ankoman/HTBPA/dat/csig_sequence.xlsx

Sheet: 制御信号一覧
 | python |  |  | short name |  |  |  | python |  |  | short name
58 | 0 | 26 | 演算結果の選択 | os | 1=eeinv | 0=postadder
57 | 1 | 25 | 逆元演算器の動作EN | inve |  |  |  |  | 17 | 逆元演算器の動作EN | inve
56 | 2 | 24 | postadder addr3[0] | poa3 |  |  |  |  | 16 | postadder outsel[0] | pos | 00:reg1 | 10:reg3
55 | 3 | 23 | postadder addr3[1] |  |  |  |  |  | 15 | postadder outsel[1] |  | 01:reg2
54 | 4 | 22 | postadder addr2[0] | poa2 |  |  |  |  | 14 | postadder mode3[0] | pom3 | 01:in | 11:in-reg | 110:p-in
53 | 5 | 21 | postadder addr2[1] |  |  |  |  |  | 13 | postadder mode3[1] |  | 10:in+reg | 00:reg
52 | 6 | 20 | postadder outsel[0] | pos | 00:reg1 | 10:reg3 |  |  | 12 | postadder mode3[2] |  | 100:reg-in | 101:p-reg
51 | 7 | 19 | postadder outsel[1] |  | 01:reg2 |  |  |  | 11 | postadder mode2[0] | pom2 | 01:in | 11:in-reg | 110:p-in
50 | 8 | 18 | postadder mode3[0] | pom3 | 01:in | 11:in-reg | 111: 無視 |  | 10 | postadder mode2[1] |  | 10:in+reg | 00:reg
49 | 9 | 17 | postadder mode3[1] |  | 10:in+reg | 00:reg |  |  | 9 | postadder mode2[2] |  | 100:reg-in | 101:p-reg
48 | 10 | 16 | postadder mode3[2] |  | 100:reg-in | 101:p-reg |  |  | 8 | postadder mode1[0] | pom1 | 01:in | 11:in-reg | 110:p-in
47 | 11 | 15 | postadder mode2[0] | pom2 | 01:in | 11:in-reg | 111: 無視 |  | 7 | postadder mode1[1] |  | 10:in+reg | 00:reg
46 | 12 | 14 | postadder mode2[1] |  | 10:in+reg | 00:reg |  |  | 6 | postadder mode1[2] |  | 100:reg-in | 101:p-reg
45 | 13 | 13 | postadder mode2[2] |  | 100:reg-in | 101:p-reg |  |  | 5 | cmul mode[0] | cm | 001: 1倍 | 100: 4倍
44 | 14 | 12 | postadder mode1[0] | pom1 | 01:in | 11:in-reg | 110:p-in |  | 4 | cmul mode[1] |  | 010: 2倍 | 110: 6倍
43 | 15 | 11 | postadder mode1[1] |  | 10:in+reg | 00:reg | 111: reg+reg |  | 3 | cmul mode[2] |  | 011: 3倍
42 | 16 | 10 | postadder mode1[2] |  | 100:reg-in | 101:p-reg |  |  | 2 | preadder mode2[0] | pm | 00:スルー/スルー | 01:1段遅れ
41 | 17 | 9 | cmul mode[0] | cm | 001: 1倍 | 100: 4倍 |  |  | 1 | preadder mode2[1] |  | 10:2段遅れ
40 | 18 | 8 | cmul mode[1] |  | 010: 2倍 | 110: 6倍 |  |  | 0 | メモリ1への書き込みEN | me
39 | 19 | 7 | cmul mode[2] |  | 011: 3倍
38 | 20 | 6 | preadder mode2[0] | pm2 | 00:スルー | 10:d0-d1
37 | 21 | 5 | preadder mode2[1] |  | 01:delay1 + d1
36 | 22 | 4 | preadder mode1[0] | pm1 | 00:スルー | 10:d0+delay0
35 | 23 | 3 | preadder mode1[1] |  | 01:d0+d1
34 | 24 | 2 | メモリ1への書き込みEN | me1
33 | 25 | 1 | メモリ0への書き込みEN | me0
32 | 26 | 0 | opcode | opcode | 0:制御信号 | 1: 命令

Sheet: Opcodev2
Init State |  | 動作命令 | opcode | cycle
MillerLoop First | 0 | MillerLoop First + MillerLoop Second r = 0 | 0 | 277
MillerLoop Second r = 0 | 0 | MillerLoop ri = 0 | 1 | 144
MillerLoop ri = 0 | 1 | MillerLoop ri = 1 | 2 | 242
MillerLoop ri = 1 | 2 | Miller Loop Final + Final Addition | 3 | 326
Miller Loop Final | 3 | f^(p^6-1) + f^(p^2+1) | 4 | 670
Final Addition | 3 | Compress even + pipeline wait | 6 | 28
f^(p^6-1) | 4 | Compress odd + pipeline wait | 5 | 28
f^(p^2+1) | 4 | Compress odd + c55 out | 7 | 33
Compress even + pipeline wait | 6 | Compress even | 8 | 28
Compress odd + pipeline wait | 5 | before c55 | 9 | 10
Compress odd + c55 out | 7 | Compress mul | 10 | 228
Compress even | 8 | FP12_sq | 11 | 57
before c55 | 9 | FP12_mul Compress out | 12 | 110
Compress mul | 10 | FP12_sq Compress out | 13 | 57
FP12_sq | 11 | FP12_Co_mul | 14 | 108
FP12_mul Compress out | 12 | FP12_mul | 15 | 108
FP12_sq Compress out | 13 | FP12_Fro2 | 16 | 10
FP12_Co_mul | 14 | FP12_Fro13(1) | 17 | 12
FP12_mul | 15 | FP12_Fro13(3) | 17 | 12
FP12_Fro2 | 16 | 2cycle wait | 18 | 2
FP12_Fro13(1) | 17
FP12_Fro13(3) | 17
2cycle wait | 18

Sheet: Sheet1
 | opcnt |  |  |  | 最終的な命令コード
 | 動作命令単位カウンタ | 動作命令 | Opnum |  |  | Opcnt | 動作命令 | Opnum |  | Cycle
 | 0 | MillerLoop First | 0 | まとめて1つの 命令に | 1 | 0 | MillerLoop First + MillerLoop Second r = 0 | 0 |  | 277
1 | 1 | MillerLoop Second r = 0 | 0 |  | 0 | 1 | MillerLoop ri = 0 | 1 |  | 144
0 | 2 | MillerLoop ri = 0 | 1 |  | 0 | 2 | MillerLoop ri = 0 | 1 |  | 144
0 | 3 | MillerLoop ri = 0 | 1 |  | 0 | 3 | MillerLoop ri = 0 | 1 |  | 144
0 | 4 | MillerLoop ri = 0 | 1 |  | 0 | 4 | MillerLoop ri = 0 | 1 |  | 144
0 | 5 | MillerLoop ri = 0 | 1 |  | 0 | 5 | MillerLoop ri = 1 | 2 |  | 242
0 | 6 | MillerLoop ri = 1 | 2 |  | 1 | 6 | MillerLoop ri = 1 | 2 |  | 242
1 | 7 | MillerLoop ri = 1 | 2 |  | 1 | 7 | MillerLoop ri = 0 | 1 |  | 144
1 | 8 | MillerLoop ri = 0 | 1 |  | 0 | 8 | MillerLoop ri = 0 | 1 |  | 144
0 | 9 | MillerLoop ri = 0 | 1 |  | 0 | 9 | MillerLoop ri = 0 | 1 |  | 144
0 | 10 | MillerLoop ri = 0 | 1 |  | 0 | 10 | MillerLoop ri = 0 | 1 |  | 144
0 | 11 | MillerLoop ri = 0 | 1 |  | 0 | 11 | MillerLoop ri = 0 | 1 |  | 144
0 | 12 | MillerLoop ri = 0 | 1 |  | 0 | 12 | MillerLoop ri = 0 | 1 |  | 144
0 | 13 | MillerLoop ri = 0 | 1 |  | 0 | 13 | MillerLoop ri = 0 | 1 |  | 144
0 | 14 | MillerLoop ri = 0 | 1 |  | 0 | 14 | MillerLoop ri = 0 | 1 |  | 144
0 | 15 | MillerLoop ri = 0 | 1 |  | 0 | 15 | MillerLoop ri = 0 | 1 |  | 144
0 | 16 | MillerLoop ri = 0 | 1 |  | 0 | 16 | MillerLoop ri = 0 | 1 |  | 144
0 | 17 | MillerLoop ri = 0 | 1 |  | 0 | 17 | MillerLoop ri = 0 | 1 |  | 144
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
34 | 101 | Compress odd + pipeline wait | 5 |  | 34 | 101 | Compress even + pipeline wait | 6 |  | 28
35 | 102 | Compress even + pipeline wait | 6 |  | 35 | 102 | Compress odd + pipeline wait | 5 |  | 28
36 | 103 | Compress odd + pipeline wait | 5 |  | 36 | 103 | Compress even + pipeline wait | 6 |  | 28
37 | 104 | Compress even + pipeline wait | 6 |  | 37 | 104 | Compress odd + pipeline wait | 5 |  | 28
38 | 105 | Compress odd + pipeline wait | 5 |  | 38 | 105 | Compress even + pipeline wait | 6 |  | 28
39 | 106 | Compress even + pipeline wait | 6 |  | 39 | 106 | Compress odd + pipeline wait | 5 |  | 28
40 | 107 | Compress odd + pipeline wait | 5 |  | 40 | 107 | Compress even + pipeline wait | 6 |  | 28
41 | 108 | Compress even + pipeline wait | 6 |  | 41 | 108 | Compress odd + pipeline wait | 5 |  | 28
42 | 109 | Compress odd + pipeline wait | 5 |  | 42 | 109 | Compress even + pipeline wait | 6 |  | 28
43 | 110 | Compress even + pipeline wait | 6 |  | 43 | 110 | Compress odd + pipeline wait | 5 |  | 28
44 | 111 | Compress odd + pipeline wait | 5 |  | 44 | 111 | Compress even + pipeline wait | 6 |  | 28
45 | 112 | Compress even + pipeline wait | 6 |  | 45 | 112 | Compress odd + pipeline wait | 5 |  | 28
46 | 113 | Compress odd + pipeline wait | 5 |  | 46 | 113 | Compress even + pipeline wait | 6 |  | 28
47 | 114 | Compress even + pipeline wait | 6 |  | 47 | 114 | Compress odd + pipeline wait | 5 |  | 28
48 | 115 | Compress odd + pipeline wait | 5 |  | 48 | 115 | Compress even + pipeline wait | 6 |  | 28
49 | 116 | Compress even + pipeline wait | 6 |  | 49 | 116 | Compress odd + pipeline wait | 5 |  | 28
50 | 117 | Compress odd + pipeline wait | 5 |  | 50 | 117 | Compress even + pipeline wait | 6 |  | 28
51 | 118 | Compress even + pipeline wait | 6 |  | 51 | 118 | Compress odd + c55 out | 7 |  | 33
52 | 119 | Compress odd + pipeline wait | 5 |  | 52 | 119 | Compress even | 8 |  | 28
53 | 120 | Compress even + pipeline wait | 6 |  | 53 | 120 | before c55 | 9 |  | 10
54 | 121 | Compress odd + c55 out | 7 |  | 54 | 121 | Compress odd + pipeline wait | 5 |  | 28
55 | 122 | Compress even | 8 |  | 55 | 122 | Compress even + pipeline wait | 6 |  | 28
56 | 123 | before c55 | 9 |  | 56 | 123 | Compress odd + pipeline wait | 5 |  | 28
 | 124 | Compress odd + pipeline wait | 5 |  |  | 124 | Compress even + pipeline wait | 6 |  | 28
57 | 125 | Compress even + pipeline wait | 6 |  | 57 | 125 | Compress odd + pipeline wait | 5 |  | 28
58 | 126 | Compress odd + pipeline wait | 5 |  | 58 | 126 | Compress even | 8 |  | 28
59 | 127 | Compress even + pipeline wait | 6 |  | 59 | 127 | Compress mul | 10 |  | 228
60 | 128 | Compress odd + pipeline wait | 5 |  | 60 | 128 | FP12_sq | 11 |  | 57
61 | 129 | Compress even | 8 |  | 61 | 129 | FP12_sq | 11 |  | 57
62 | 130 | Compress mul | 10 |  | 62 | 130 | FP12_mul Compress out | 12 |  | 110
 | 131 | FP12_sq | 11 |  |  | 131 | Compress odd + pipeline wait | 5 |  | 28
 | 132 | FP12_sq | 11 |  |  | 132 | Compress even + pipeline wait | 6 |  | 28
 | 133 | FP12_mul Compress out | 12 |  |  | 133 | Compress odd + pipeline wait | 5 |  | 28
 | 134 | Compress odd + pipeline wait | 5 |  |  | 134 | Compress even + pipeline wait | 6 |  | 28
 | 135 | Compress even + pipeline wait | 6 |  |  | 135 | Compress odd + pipeline wait | 5 |  | 28
1 | 136 | Compress odd + pipeline wait | 5 |  | 1 | 136 | Compress even + pipeline wait | 6 |  | 28
2 | 137 | Compress even + pipeline wait | 6 |  | 2 | 137 | Compress odd + pipeline wait | 5 |  | 28
3 | 138 | Compress odd + pipeline wait | 5 |  | 3 | 138 | Compress even + pipeline wait | 6 |  | 28
4 | 139 | Compress even + pipeline wait | 6 |  | 4 | 139 | Compress odd + pipeline wait | 5 |  | 28
5 | 140 | Compress odd + pipeline wait | 5 |  | 5 | 140 | Compress even + pipeline wait | 6 |  | 28
6 | 141 | Compress even + pipeline wait | 6 |  | 6 | 141 | Compress odd + pipeline wait | 5 |  | 28
7 | 142 | Compress odd + pipeline wait | 5 |  | 7 | 142 | Compress even + pipeline wait | 6 |  | 28
8 | 143 | Compress even + pipeline wait | 6 |  | 8 | 143 | Compress odd + pipeline wait | 5 |  | 28
9 | 144 | Compress odd + pipeline wait | 5 |  | 9 | 144 | Compress even + pipeline wait | 6 |  | 28
10 | 145 | Compress even + pipeline wait | 6 |  | 10 | 145 | Compress odd + pipeline wait | 5 |  | 28
11 | 146 | Compress odd + pipeline wait | 5 |  | 11 | 146 | Compress even + pipeline wait | 6 |  | 28
12 | 147 | Compress even + pipeline wait | 6 |  | 12 | 147 | Compress odd + pipeline wait | 5 |  | 28
13 | 148 | Compress odd + pipeline wait | 5 |  | 13 | 148 | Compress even + pipeline wait | 6 |  | 28
14 | 149 | Compress even + pipeline wait | 6 |  | 14 | 149 | Compress odd + pipeline wait | 5 |  | 28
15 | 150 | Compress odd + pipeline wait | 5 |  | 15 | 150 | Compress even + pipeline wait | 6 |  | 28
16 | 151 | Compress even + pipeline wait | 6 |  | 16 | 151 | Compress odd + pipeline wait | 5 |  | 28
17 | 152 | Compress odd + pipeline wait | 5 |  | 17 | 152 | Compress even + pipeline wait | 6 |  | 28
18 | 153 | Compress even + pipeline wait | 6 |  | 18 | 153 | Compress odd + pipeline wait | 5 |  | 28
19 | 154 | Compress odd + pipeline wait | 5 |  | 19 | 154 | Compress even + pipeline wait | 6 |  | 28
20 | 155 | Compress even + pipeline wait | 6 |  | 20 | 155 | Compress odd + pipeline wait | 5 |  | 28
21 | 156 | Compress odd + pipeline wait | 5 |  | 21 | 156 | Compress even + pipeline wait | 6 |  | 28
22 | 157 | Compress even + pipeline wait | 6 |  | 22 | 157 | Compress odd + pipeline wait | 5 |  | 28
23 | 158 | Compress odd + pipeline wait | 5 |  | 23 | 158 | Compress even + pipeline wait | 6 |  | 28
24 | 159 | Compress even + pipeline wait | 6 |  | 24 | 159 | Compress odd + pipeline wait | 5 |  | 28
25 | 160 | Compress odd + pipeline wait | 5 |  | 25 | 160 | Compress even + pipeline wait | 6 |  | 28
26 | 161 | Compress even + pipeline wait | 6 |  | 26 | 161 | Compress odd + pipeline wait | 5 |  | 28
27 | 162 | Compress odd + pipeline wait | 5 |  | 27 | 162 | Compress even + pipeline wait | 6 |  | 28
28 | 163 | Compress even + pipeline wait | 6 |  | 28 | 163 | Compress odd + pipeline wait | 5 |  | 28
29 | 164 | Compress odd + pipeline wait | 5 |  | 29 | 164 | Compress even + pipeline wait | 6 |  | 28
30 | 165 | Compress even + pipeline wait | 6 |  | 30 | 165 | Compress odd + pipeline wait | 5 |  | 28
31 | 166 | Compress odd + pipeline wait | 5 |  | 31 | 166 | Compress even + pipeline wait | 6 |  | 28
32 | 167 | Compress even + pipeline wait | 6 |  | 32 | 167 | Compress odd + pipeline wait | 5 |  | 28
33 | 168 | Compress odd + pipeline wait | 5 |  | 33 | 168 | Compress even + pipeline wait | 6 |  | 28
34 | 169 | Compress even + pipeline wait | 6 |  | 34 | 169 | Compress odd + pipeline wait | 5 |  | 28
35 | 170 | Compress odd + pipeline wait | 5 |  | 35 | 170 | Compress even + pipeline wait | 6 |  | 28
36 | 171 | Compress even + pipeline wait | 6 |  | 36 | 171 | Compress odd + pipeline wait | 5 |  | 28
37 | 172 | Compress odd + pipeline wait | 5 |  | 37 | 172 | Compress even + pipeline wait | 6 |  | 28
38 | 173 | Compress even + pipeline wait | 6 |  | 38 | 173 | Compress odd + pipeline wait | 5 |  | 28
39 | 174 | Compress odd + pipeline wait | 5 |  | 39 | 174 | Compress even + pipeline wait | 6 |  | 28
40 | 175 | Compress even + pipeline wait | 6 |  | 40 | 175 | Compress odd + pipeline wait | 5 |  | 28
41 | 176 | Compress odd + pipeline wait | 5 |  | 41 | 176 | Compress even + pipeline wait | 6 |  | 28
42 | 177 | Compress even + pipeline wait | 6 |  | 42 | 177 | Compress odd + pipeline wait | 5 |  | 28
43 | 178 | Compress odd + pipeline wait | 5 |  | 43 | 178 | Compress even + pipeline wait | 6 |  | 28
44 | 179 | Compress even + pipeline wait | 6 |  | 44 | 179 | Compress odd + pipeline wait | 5 |  | 28
45 | 180 | Compress odd + pipeline wait | 5 |  | 45 | 180 | Compress even + pipeline wait | 6 |  | 28
46 | 181 | Compress even + pipeline wait | 6 |  | 46 | 181 | Compress odd + pipeline wait | 5 |  | 28
47 | 182 | Compress odd + pipeline wait | 5 |  | 47 | 182 | Compress even + pipeline wait | 6 |  | 28
48 | 183 | Compress even + pipeline wait | 6 |  | 48 | 183 | Compress odd + pipeline wait | 5 |  | 28
49 | 184 | Compress odd + pipeline wait | 5 |  | 49 | 184 | Compress even + pipeline wait | 6 |  | 28
50 | 185 | Compress even + pipeline wait | 6 |  | 50 | 185 | Compress odd + c55 out | 7 |  | 33
51 | 186 | Compress odd + pipeline wait | 5 |  | 51 | 186 | Compress even | 8 |  | 28
52 | 187 | Compress even + pipeline wait | 6 |  | 52 | 187 | before c55 | 9 |  | 10
53 | 188 | Compress odd + c55 out | 7 |  | 53 | 188 | Compress odd + pipeline wait | 5 |  | 28
54 | 189 | Compress even | 8 |  | 54 | 189 | Compress even + pipeline wait | 6 |  | 28
55 | 190 | before c55 | 9 |  | 55 | 190 | Compress odd + pipeline wait | 5 |  | 28
56 | 191 | Compress odd + pipeline wait | 5 |  | 56 | 191 | Compress even + pipeline wait | 6 |  | 28
 | 192 | Compress even + pipeline wait | 6 |  |  | 192 | Compress odd + pipeline wait | 5 |  | 28
57 | 193 | Compress odd + pipeline wait | 5 |  | 57 | 193 | Compress even | 8 |  | 28
58 | 194 | Compress even + pipeline wait | 6 |  | 58 | 194 | Compress mul | 10 |  | 228
59 | 195 | Compress odd + pipeline wait | 5 |  | 59 | 195 | FP12_sq Compress out | 13 |  | 57
60 | 196 | Compress even | 8 |  | 60 | 196 | Compress odd + pipeline wait | 5 |  | 28
61 | 197 | Compress mul | 10 |  | 61 | 197 | Compress even + pipeline wait | 6 |  | 28
62 | 198 | FP12_sq Compress out | 13 |  | 62 | 198 | Compress odd + pipeline wait | 5 |  | 28
 | 199 | Compress odd + pipeline wait | 5 |  |  | 199 | Compress even + pipeline wait | 6 |  | 28
 | 200 | Compress even + pipeline wait | 6 |  |  | 200 | Compress odd + pipeline wait | 5 |  | 28
 | 201 | Compress odd + pipeline wait | 5 |  |  | 201 | Compress even + pipeline wait | 6 |  | 28
1 | 202 | Compress even + pipeline wait | 6 |  | 1 | 202 | Compress odd + pipeline wait | 5 |  | 28
2 | 203 | Compress odd + pipeline wait | 5 |  | 2 | 203 | Compress even + pipeline wait | 6 |  | 28
3 | 204 | Compress even + pipeline wait | 6 |  | 3 | 204 | Compress odd + pipeline wait | 5 |  | 28
4 | 205 | Compress odd + pipeline wait | 5 |  | 4 | 205 | Compress even + pipeline wait | 6 |  | 28
5 | 206 | Compress even + pipeline wait | 6 |  | 5 | 206 | Compress odd + pipeline wait | 5 |  | 28
6 | 207 | Compress odd + pipeline wait | 5 |  | 6 | 207 | Compress even + pipeline wait | 6 |  | 28
7 | 208 | Compress even + pipeline wait | 6 |  | 7 | 208 | Compress odd + pipeline wait | 5 |  | 28
8 | 209 | Compress odd + pipeline wait | 5 |  | 8 | 209 | Compress even + pipeline wait | 6 |  | 28
9 | 210 | Compress even + pipeline wait | 6 |  | 9 | 210 | Compress odd + pipeline wait | 5 |  | 28
10 | 211 | Compress odd + pipeline wait | 5 |  | 10 | 211 | Compress even + pipeline wait | 6 |  | 28
11 | 212 | Compress even + pipeline wait | 6 |  | 11 | 212 | Compress odd + pipeline wait | 5 |  | 28
12 | 213 | Compress odd + pipeline wait | 5 |  | 12 | 213 | Compress even + pipeline wait | 6 |  | 28
13 | 214 | Compress even + pipeline wait | 6 |  | 13 | 214 | Compress odd + pipeline wait | 5 |  | 28
14 | 215 | Compress odd + pipeline wait | 5 |  | 14 | 215 | Compress even + pipeline wait | 6 |  | 28
15 | 216 | Compress even + pipeline wait | 6 |  | 15 | 216 | Compress odd + pipeline wait | 5 |  | 28
16 | 217 | Compress odd + pipeline wait | 5 |  | 16 | 217 | Compress even + pipeline wait | 6 |  | 28
17 | 218 | Compress even + pipeline wait | 6 |  | 17 | 218 | Compress odd + pipeline wait | 5 |  | 28
18 | 219 | Compress odd + pipeline wait | 5 |  | 18 | 219 | Compress even + pipeline wait | 6 |  | 28
19 | 220 | Compress even + pipeline wait | 6 |  | 19 | 220 | Compress odd + pipeline wait | 5 |  | 28
20 | 221 | Compress odd + pipeline wait | 5 |  | 20 | 221 | Compress even + pipeline wait | 6 |  | 28
21 | 222 | Compress even + pipeline wait | 6 |  | 21 | 222 | Compress odd + pipeline wait | 5 |  | 28
22 | 223 | Compress odd + pipeline wait | 5 |  | 22 | 223 | Compress even + pipeline wait | 6 |  | 28
23 | 224 | Compress even + pipeline wait | 6 |  | 23 | 224 | Compress odd + pipeline wait | 5 |  | 28
24 | 225 | Compress odd + pipeline wait | 5 |  | 24 | 225 | Compress even + pipeline wait | 6 |  | 28
25 | 226 | Compress even + pipeline wait | 6 |  | 25 | 226 | Compress odd + pipeline wait | 5 |  | 28
26 | 227 | Compress odd + pipeline wait | 5 |  | 26 | 227 | Compress even + pipeline wait | 6 |  | 28
27 | 228 | Compress even + pipeline wait | 6 |  | 27 | 228 | Compress odd + pipeline wait | 5 |  | 28
28 | 229 | Compress odd + pipeline wait | 5 |  | 28 | 229 | Compress even + pipeline wait | 6 |  | 28
29 | 230 | Compress even + pipeline wait | 6 |  | 29 | 230 | Compress odd + pipeline wait | 5 |  | 28
30 | 231 | Compress odd + pipeline wait | 5 |  | 30 | 231 | Compress even + pipeline wait | 6 |  | 28
31 | 232 | Compress even + pipeline wait | 6 |  | 31 | 232 | Compress odd + pipeline wait | 5 |  | 28
32 | 233 | Compress odd + pipeline wait | 5 |  | 32 | 233 | Compress even + pipeline wait | 6 |  | 28
33 | 234 | Compress even + pipeline wait | 6 |  | 33 | 234 | Compress odd + pipeline wait | 5 |  | 28
34 | 235 | Compress odd + pipeline wait | 5 |  | 34 | 235 | Compress even + pipeline wait | 6 |  | 28
35 | 236 | Compress even + pipeline wait | 6 |  | 35 | 236 | Compress odd + pipeline wait | 5 |  | 28
36 | 237 | Compress odd + pipeline wait | 5 |  | 36 | 237 | Compress even + pipeline wait | 6 |  | 28
37 | 238 | Compress even + pipeline wait | 6 |  | 37 | 238 | Compress odd + pipeline wait | 5 |  | 28
38 | 239 | Compress odd + pipeline wait | 5 |  | 38 | 239 | Compress even + pipeline wait | 6 |  | 28
39 | 240 | Compress even + pipeline wait | 6 |  | 39 | 240 | Compress odd + pipeline wait | 5 |  | 28
40 | 241 | Compress odd + pipeline wait | 5 |  | 40 | 241 | Compress even + pipeline wait | 6 |  | 28
41 | 242 | Compress even + pipeline wait | 6 |  | 41 | 242 | Compress odd + pipeline wait | 5 |  | 28
42 | 243 | Compress odd + pipeline wait | 5 |  | 42 | 243 | Compress even + pipeline wait | 6 |  | 28
43 | 244 | Compress even + pipeline wait | 6 |  | 43 | 244 | Compress odd + pipeline wait | 5 |  | 28
44 | 245 | Compress odd + pipeline wait | 5 |  | 44 | 245 | Compress even + pipeline wait | 6 |  | 28
45 | 246 | Compress even + pipeline wait | 6 |  | 45 | 246 | Compress odd + pipeline wait | 5 |  | 28
46 | 247 | Compress odd + pipeline wait | 5 |  | 46 | 247 | Compress even + pipeline wait | 6 |  | 28
47 | 248 | Compress even + pipeline wait | 6 |  | 47 | 248 | Compress odd + pipeline wait | 5 |  | 28
48 | 249 | Compress odd + pipeline wait | 5 |  | 48 | 249 | Compress even + pipeline wait | 6 |  | 28
49 | 250 | Compress even + pipeline wait | 6 |  | 49 | 250 | Compress odd + c55 out | 7 |  | 33
50 | 251 | Compress odd + pipeline wait | 5 |  | 50 | 251 | Compress even | 8 |  | 28
51 | 252 | Compress even + pipeline wait | 6 |  | 51 | 252 | before c55 | 9 |  | 10
52 | 253 | Compress odd + c55 out | 7 |  | 52 | 253 | Compress odd + pipeline wait | 5 |  | 28
53 | 254 | Compress even | 8 |  | 53 | 254 | Compress even + pipeline wait | 6 |  | 28
54 | 255 | before c55 | 9 |  | 54 | 255 | Compress odd + pipeline wait | 5 |  | 28
55 | 256 | Compress odd + pipeline wait | 5 |  | 55 | 256 | Compress even + pipeline wait | 6 |  | 28
56 | 257 | Compress even + pipeline wait | 6 |  | 56 | 257 | Compress odd + pipeline wait | 5 |  | 28
 | 258 | Compress odd + pipeline wait | 5 |  |  | 258 | Compress even | 8 |  | 28
57 | 259 | Compress even + pipeline wait | 6 |  | 57 | 259 | Compress mul | 10 |  | 228
58 | 260 | Compress odd + pipeline wait | 5 |  | 58 | 260 | FP12_Co_mul | 14 |  | 108
59 | 261 | Compress even | 8 |  | 59 | 261 | FP12_mul | 15 |  | 108
60 | 262 | Compress mul | 10 |  | 60 | 262 | FP12_Co_mul | 14 |  | 108
61 | 263 | FP12_Co_mul | 14 |  | 61 | 263 | 2cycle wait | 18 |  | 2
62 | 264 | FP12_mul | 15 |  | 62 | 264 | FP12_mul | 15 |  | 108
 | 265 | FP12_Co_mul | 14 |  |  | 265 | FP12_mul | 15 |  | 108
 | 266 | 2cycle wait | 18 |  |  | 266 | FP12_Fro2 | 16 |  | 10
 | 267 | FP12_mul | 15 |  |  | 267 | FP12_Co_mul | 14 |  | 108
 | 268 | FP12_mul | 15 |  |  | 268 | FP12_Fro13(1) | 17 |  | 12
 | 269 | FP12_Fro2 | 16 |  |  | 269 | FP12_mul | 15 |  | 108
 | 270 | FP12_Co_mul | 14 |  |  | 270 | FP12_Fro13(3) | 17 |  | 12
 | 271 | FP12_Fro13(1) | 17 |  |  | 271 | FP12_mul | 15 |  | 108
 | 272 | FP12_mul | 15 |  |  | 272 | 2cycle wait | 18 |  | 2 |  | hardpart
 | 273 | FP12_Fro13(3) | 17 |  |  | 273 | FP12_mul | 15 |  | 108 |  | 7228
 | 274 | FP12_mul | 15 |  |  |  |  |  | 計 | 17579
 | 275 | 2cycle wait | 18
 | 276 | FP12_mul | 15
 | 277
 | 278
 | 279
 | 280
 |  |  |  |  |  |  | 186

Sheet: memory
 |  |  |  |  |  | 入力データ
 |  |  |  | Miller Loop
 |  |  | Y | 0xX0 |  | 0xX1 |  | 0xX2 |  | 0xX3 |  | 0xX4 |  | 0xX5 |  | 0xX6 |  | 0xX7 |  | 0xX8 |  | 0xX9 |  | 0xXa |  | 0xXb |  | 0xXc |  | 0xXd |  | 0xXe |  | 0xXf
 |  |  | X | mem0 | mem1 | mem0 | mem1 | mem0 | mem1 | mem0 | mem1 | mem0 | mem1 | mem0 | mem1 | mem0 | mem1 | mem0 | mem1 | mem0 | mem1 | mem0 | mem1 | mem0 | mem1 | mem0 | mem1 | mem0 | mem1 | mem0 | mem1 | mem0 | mem1 | mem0 | mem1
F=A-3B |  |  | 0x0Y | Xq_0 | Xq_0 | xq_1 | xq_1 | yq_0 | yq_0 | yq_1 | yq_1 | zq_0 | zq_0 | zq_1 | zq_1 | xp | xp | yp | yp | 0 | 0 | r2 | r2 | ri | ri | 1 | 1 | W2p | W2p | W3p_0 | W3p_0 | W3p_1 | W3p_1
 |  |  | 0x1Y | f0_0 | f0_0 | f0_1 | f0_1 | f1_0 | f1_0 | f1_1 | f1_1 | f2_0 | f2_0 | f2_1 | f2_1 | f3_0 | f3_0 | f3_1 | f3_1 | f4_0 | f4_0 | f4_1 | f4_1 | f5_0 | f5_0 | f5_1 | f5_1 | A_0 | A_0 | A_1 | A_1 | B_0 | B_0 | B_1 | B_1
ri=1のときは， |  |  | 0x2Y | Tx_0 | Tx_0 | Tx_1 | Tx_1 | Ty_0 | Ty_0 | Ty_1 | Ty_1 | Tz_0 | Tz_0 | Tz_1 | Tz_1 | l0_0 | l0_0 | l0_1 | l0_1 | l1_0 | l1_0 | l1_1 | l1_1 | l3_0 | l3_0 | l3_1 | l3_1 | C_0 | C_0 | C_1 | C_1 | D_0 | D_0 | D_1 | D_1
f*lが2回発生する |  |  | 0x3Y | tf0_0 | tf0_0 | tf0_1 | tf0_1 | tf1_0 | tf1_0 | tf1_1 | tf1_1 | tf2_0 | tf2_0 | tf2_1 | tf2_1 | tf3_0 | tf3_0 | tf3_1 | tf3_1 | tf4_0 | tf4_0 | tf4_1 | tf4_1 | tf5_0 | tf5_0 | tf5_1 | tf5_1 | E_0 | E_0 | E_1 | E_1 | F_0 | F_0 | F_1 | F_1
ので1回目をf*lとし |  |  | 0x4Y |  |  |  |  |  |  |  |  |  |  |  |  |  |  |  |  |  |  |  |  |  |  |  |  |  |  |  |  |  |  | g300 | g300
2回目をl*fとすることで |  |  | 0x5Y |  |  |  |  |  |  |  |  |  |  |  |  |  |  |  |  |  |  |  |  |  |  |  |  |  |  | g330 | g330 | g311 | g311 | g321 | g321
memoryの領域を削減 |  |  | 0x6Y |  |  |  |  |  |  |  |  |  |  |  |  |  |  |  |  |  |  |  |  |  |  |  |  |  |  | g100 | g100 | g130 | g130 | g111 | g111
要は，一回目はmem0から |  |  | 0x7Y |  |  |  |  |  |  |  |  |  |  |  |  |  |  |  |  |  |  |  |  |  |  |  |  |  |  | g140 | g140 | g200 | g200 | g201 | g201
 |  |  |  | Final Addtion
 |  |  | Y | 0xX0 |  | 0xX1 |  | 0xX2 |  | 0xX3 |  | 0xX4 |  | 0xX5 |  | 0xX6 |  | 0xX7 |  | 0xX8 |  | 0xX9 |  | 0xXa |  | 0xXb |  | 0xXc |  | 0xXd |  | 0xXe |  | 0xXf
 |  |  | X | mem0 | mem1 | mem0 | mem1 | mem0 | mem1 | mem0 | mem1 | mem0 | mem1 | mem0 | mem1 | mem0 | mem1 | mem0 | mem1 | mem0 | mem1 | mem0 | mem1 | mem0 | mem1 | mem0 | mem1 | mem0 | mem1 | mem0 | mem1 | mem0 | mem1 | mem0 | mem1
 |  |  | 0x0Y | Xq_0 | Xq_0 | xq_1 | xq_1 | yq_0 | yq_0 | yq_1 | yq_1 | zq_0 | zq_0 | zq_1 | zq_1 | xp | xp | yp | yp | zp | zp | r2 | r2 | ri | ri | 1 | 1 | W2p | W2p | W3p_0 | W3p_0 | W3p_1 | W3p_1 | Z_0 | Z_0
 |  |  | 0x1Y | f0_0 | f0_0 | f0_1 | f0_1 | f1_0 | f1_0 | f1_1 | f1_1 | f2_0 | f2_0 | f2_1 | f2_1 | f3_0 | f3_0 | f3_1 | f3_1 | f4_0 | f4_0 | f4_1 | f4_1 | f5_0 | f5_0 | f5_1 | f5_1 | A_0 | A_0 | A_1 | A_1 | B_0 | B_0 | B_1 | B_1
 |  |  | 0x2Y | Tx_0 | Tx_0 | Tx_1 | Tx_1 | Ty_0 | Ty_0 | Ty_1 | Ty_1 | Tz_0 | Tz_0 | Tz_1 | Tz_1 | l0_0 | l0_0 | l0_1 | l0_1 | l1_0 | l1_0 | l1_1 | l1_1 | l3_0 | l3_0 | l3_1 | l3_1 | C_0 | C_0 | C_1 | C_1 | D_0 | D_0 | D_1 | D_1
 |  |  | 0x3Y | tf0_0 | tf0_0 | tf0_1 | tf0_1 | tf1_0 | tf1_0 | tf1_1 | tf1_1 | tf2_0 | tf2_0 | tf2_1 | tf2_1 | tf3_0 | tf3_0 | tf3_1 | tf3_1 | tf4_0 | tf4_0 | tf4_1 | tf4_1 | tf5_0 | tf5_0 | tf5_1 | tf5_1 | E_0 | E_0 | E_1 | E_1 | F_0 | F_0 | F_1 | F_1
 |  |  | 0x4Y | xq1_0 | xq1_0 | xq1_1 | xq1_1 | yq1_0 | yq1_0 | yq1_1 | yq1_1 | xq2_0 | xq2_0 | xq2_1 | xq2_1 |  |  |  |  |  |  |  |  |  |  |  |  |  |  |  |  |  |  | g300 | g300
 |  |  | 0x5Y |  |  |  |  |  |  |  |  |  |  |  |  |  |  |  |  |  |  |  |  |  |  |  |  |  |  | g330 | g330 | g311 | g311 | g321 | g321
 |  |  | 0x6Y |  |  |  |  |  |  |  |  |  |  |  |  |  |  |  |  |  |  |  |  |  |  |  |  |  |  | g100 | g100 | g130 | g130 | g111 | g111
 |  |  | 0x7Y |  |  |  |  |  |  |  |  |  |  |  |  |  |  |  |  |  |  |  |  |  |  |  |  |  |  | g140 | g140 | g200 | g200 | g201 | g201
 |  |  |  | Final exp(f^(p^6-1))
 |  |  | Y | 0xX0 |  | 0xX1 |  | 0xX2 |  | 0xX3 |  | 0xX4 |  | 0xX5 |  | 0xX6 |  | 0xX7 |  | 0xX8 |  | 0xX9 |  | 0xXa |  | 0xXb |  | 0xXc |  | 0xXd |  | 0xXe |  | 0xXf
 |  |  | X | mem0 | mem1 | mem0 | mem1 | mem0 | mem1 | mem0 | mem1 | mem0 | mem1 | mem0 | mem1 | mem0 | mem1 | mem0 | mem1 | mem0 | mem1 | mem0 | mem1 | mem0 | mem1 | mem0 | mem1 | mem0 | mem1 | mem0 | mem1 | mem0 | mem1 | mem0 | mem1
 |  |  | 0x0Y
 |  |  | 0x1Y | f0_0 | f0_0 | f0_1 | f0_1 | f1_0 | f1_0 | f1_1 | f1_1 | f2_0 | f2_0 | f2_1 | f2_1 | f3_0 | f3_0 | f3_1 | f3_1 | f4_0 | f4_0 | f4_1 | f4_1 | f5_0 | f5_0 | f5_1 | f5_1 | a_0 | a_0 | a_1 | a_1 | b_0 | b_0 | b_1 | b_1
 |  |  | 0x2Y | f'0_0 | f'0_0 | f'0_1 | f'0_1 | f'1_0 | f'1_0 | f'1_1 | f'1_1 | f'2_0 | f'2_0 | f'2_1 | f'2_1 | f'3_0 | f'3_0 | f'3_1 | f'3_1 | f'4_0 | f'4_0 | f'4_1 | f'4_1 | f'5_0 | f'5_0 | f'5_1 | f'5_1 | c_0 | c_0 | c_1 | c_1 | A_0 | A_0 | A_1 | A_1
 |  |  | 0x3Y | ff_0 | ff_0 | ff_1 | ff_1 | ff_1_neg | ff_1_neg | fff | fff |  |  |  |  |  |  |  |  |  |  |  |  |  |  |  |  | B_0 | B_0 | B_1 | B_1 | C_0 | C_0 | C_1 | C_1
 |  |  | 0x4Y | t0_0 | t0_0 | t0_1 | t0_1 | t1_0 | t1_0 | t1_1 | t1_1 |  |  |  |  |  |  |  |  |  |  |  |  |  |  |  |  |  |  |  |  |  |  | g300 | g300
 |  |  | 0x5Y |  |  |  |  |  |  |  |  |  |  |  |  |  |  |  |  |  |  |  |  |  |  |  |  |  |  | g330 | g330 | g311 | g311 | g321 | g321
 |  |  | 0x6Y |  |  |  |  |  |  |  |  |  |  |  |  |  |  |  |  |  |  |  |  |  |  |  |  |  |  | g100 | g100 | g130 | g130 | g111 | g111
 |  |  | 0x7Y |  |  |  |  |  |  |  |  |  |  |  |  |  |  |  |  |  |  |  |  |  |  |  |  |  |  | g140 | g140 | g200 | g200 | g201 | g201
 |  |  |  | Final exp(f^(p^2+1))
 |  |  | Y | 0xX0 |  | 0xX1 |  | 0xX2 |  | 0xX3 |  | 0xX4 |  | 0xX5 |  | 0xX6 |  | 0xX7 |  | 0xX8 |  | 0xX9 |  | 0xXa |  | 0xXb |  | 0xXc |  | 0xXd |  | 0xXe |  | 0xXf
 |  |  | X | mem0 | mem1 | mem0 | mem1 | mem0 | mem1 | mem0 | mem1 | mem0 | mem1 | mem0 | mem1 | mem0 | mem1 | mem0 | mem1 | mem0 | mem1 | mem0 | mem1 | mem0 | mem1 | mem0 | mem1 | mem0 | mem1 | mem0 | mem1 | mem0 | mem1 | mem0 | mem1
 |  |  | 0x0Y
 |  |  | 0x1Y | f0_0 | f0_0 | f0_1 | f0_1 | f1_0 | f1_0 | f1_1 | f1_1 | f2_0 | f2_0 | f2_1 | f2_1 | f3_0 | f3_0 | f3_1 | f3_1 | f4_0 | f4_0 | f4_1 | f4_1 | f5_0 | f5_0 | f5_1 | f5_1
 |  |  | 0x2Y | f'0_0 | f"0_0 | f'0_1 | f"0_1 | f'1_0 | f"1_0 | f'1_1 | f"1_1 | f'2_0 | f"2_0 | f'2_1 | f"2_1 | f'3_0 | f"3_0 | f'3_1 | f"3_1 | f'4_0 | f"4_0 | f'4_1 | f"4_1 | f'5_0 | f"5_0 | f'5_1 | f"5_1
 |  |  | 0x3Y
 |  |  | 0x4Y |  |  |  |  |  |  |  |  |  |  |  |  |  |  |  |  |  |  |  |  |  |  |  |  |  |  |  |  |  |  | g300 | g300
 |  |  | 0x5Y |  |  |  |  |  |  |  |  |  |  |  |  |  |  |  |  |  |  |  |  |  |  |  |  |  |  | g330 | g330 | g311 | g311 | g321 | g321
 |  |  | 0x6Y |  |  |  |  |  |  |  |  |  |  |  |  |  |  |  |  |  |  |  |  |  |  |  |  |  |  | g100 | g100 | g130 | g130 | g111 | g111
 |  |  | 0x7Y |  |  |  |  |  |  |  |  |  |  |  |  |  |  |  |  |  |  |  |  |  |  |  |  |  |  | g140 | g140 | g200 | g200 | g201 | g201
 |  |  |  | hard part Compression
 |  |  | Y | 0xX0 |  | 0xX1 |  | 0xX2 |  | 0xX3 |  | 0xX4 |  | 0xX5 |  | 0xX6 |  | 0xX7 |  | 0xX8 |  | 0xX9 |  | 0xXa |  | 0xXb |  | 0xXc |  | 0xXd |  | 0xXe |  | 0xXf
 |  |  | X | mem0 | mem1 | mem0 | mem1 | mem0 | mem1 | mem0 | mem1 | mem0 | mem1 | mem0 | mem1 | mem0 | mem1 | mem0 | mem1 | mem0 | mem1 | mem0 | mem1 | mem0 | mem1 | mem0 | mem1 | mem0 | mem1 | mem0 | mem1 | mem0 | mem1 | mem0 | mem1
 |  |  | 0x0Y | tt |  |  |  |  |  |  |  |  |  |  |  |  |  |  |  |  |  |  |  |  |  |  |  | R | R
 | 16 |  | 0x1Y | f |  |  |  |  |  |  |  |  |  |  |  |  |  |  |  |  |  |  |  |  |  |  |  | R | R
 | 32 |  | 0x2Y | t0 |  |  |  |  |  |  |  |  |  |  |  |  |  |  |  |  |  |  |  |  |  |  |  | R | R
 | 48 |  | 0x3Y | t1 |  |  |  |  |  |  |  |  |  |  |  |  |  |  |  |  |  |  |  |  |  |  |  | R | R
 | 64 |  | 0x4Y | t2 |  |  |  |  |  |  |  |  |  |  |  |  |  |  |  |  |  |  |  |  |  |  |  | R | R | 1 |  |  |  | g300 | g300
 | 80 |  | 0x5Y | t3 = t55 |  |  |  |  |  |  |  |  |  |  |  |  |  |  |  |  |  |  |  |  |  |  |  | R | R | g330 | g330 | g311 | g311 | g321 | g321
 | 96 | 圧縮自乗算奇数 | 0x6Y | h0_0 | h0_0 | h0_1 | h0_1 | h1_0 | h1_0 | h1_1 | h1_1 | h2_0 | h2_0 | h2_1 | h2_1 | h3_0 | h3_0 | h3_1 | h3_1 | h4_0 | h4_0 | h4_1 | h4_1 | h5_0 | h5_0 | h5_1 | h5_1 | R | R | g100 | g100 | g130 | g130 | g111 | g111
 | 112 | 圧縮自乗算偶数 | 0x7Y |  |  | h0_1 | h0_1 | h1_0 | h1_0 | h1_1 | h1_1 | h2_0 | h2_0 | h2_1 | h2_1 | h3_0 | h3_0 | h3_1 | h3_1 | h4_0 | h4_0 | h4_1 | h4_1 | h5_0 | h5_0 | h5_1 | h5_1 | R | R | g140 | g140 | g200 | g200 | g201 | g201
 |  |  |  | hard part (Last part)
 |  |  | Y | 0xX0 |  | 0xX1 |  | 0xX2 |  | 0xX3 |  | 0xX4 |  | 0xX5 |  | 0xX6 |  | 0xX7 |  | 0xX8 |  | 0xX9 |  | 0xXa |  | 0xXb |  | 0xXc |  | 0xXd |  | 0xXe |  | 0xXf
 |  |  | X | mem0 | mem1 | mem0 | mem1 | mem0 | mem1 | mem0 | mem1 | mem0 | mem1 | mem0 | mem1 | mem0 | mem1 | mem0 | mem1 | mem0 | mem1 | mem0 | mem1 | mem0 | mem1 | mem0 | mem1 | mem0 | mem1 | mem0 | mem1 | mem0 | mem1 | mem0 | mem1
 |  |  | 0x0Y
 |  |  | 0x1Y | f0_0 | f0_0 | f0_1 | f0_1 | f1_0 | f1_0 | f1_1 | f1_1 | f2_0 | f2_0 | f2_1 | f2_1 | f3_0 | f3_0 | f3_1 | f3_1 | f4_0 | f4_0 | f4_1 | f4_1 | f5_0 | f5_0 | f5_1 | f5_1 | R | R
 |  |  | 0x2Y | f2z0_0 |  |  |  |  |  |  |  |  |  |  |  |  |  |  |  |  |  |  |  |  |  |  |  | R | R
 |  |  | 0x3Y | f6z0_0 |  |  |  |  |  |  |  |  |  |  |  |  |  |  |  |  |  |  |  |  |  |  |  | R | R
 |  |  | 0x4Y | f12z3-0_0 |  |  |  |  |  |  |  |  |  |  |  |  |  |  |  |  |  |  |  |  |  |  |  | R | R |  |  |  |  | g300 | g300
 |  |  | 0x5Y | f6z2-0_0 |  |  |  |  |  |  |  |  |  |  |  |  |  |  |  |  |  |  |  |  |  |  |  | R | R | g330 | g330 | g311 | g311 | g321 | g321
 |  |  | 0x6Y | a0_0 |  |  |  |  |  |  |  |  |  |  |  |  |  |  |  |  |  |  |  |  |  |  |  | R | R | g100 | g100 | g130 | g130 | g111 | g111
 |  |  | 0x7Y |  |  |  |  |  |  |  |  |  |  |  |  |  |  |  |  |  |  |  |  |  |  |  |  | R | R | g140 | g140 | g200 | g200 | g201 | g201
 |  |  |  |  | f'=入力 |  | f"=f^(p^2)
 |  |  |  |  | fff_acc0 : fff_acc0RR |  |  |  |  |  |  |  |  | gx_0/gx_1 : c62gx_0/c62gx_1
 |  |  |  |  | fff_acc1 : fff_acc/fff_accReduction/fff_inv |  |  |  |  |  |  |  |  | thx_0/thx_1 : c55gx_0/c55gx_1
 |  |  |  |  | fff_acc1_neg : fff_acc1_negRR
 |  |  |  | 0xX0 | 0xX1 | 0xX2 | 0xX3 | 0xX4 | 0xX5 | 0xX6 | 0xX7 | 0xX8 | 0xX9 | 0xXa | 0xXb | 0xXc | 0xXd | 0xXe | 0xXf
 |  |  | 0x7Y |  |  |  |  |  |  |  |  | g3_0_0 | g3_0_1 | g3_3_0 | g3_1_1 | g3_2_0 | g3_2_1 | g3_4_0 | g3_4_1
 |  |  | 0x8Y | g1_0_0 | g1_0_1 | g1_3_0 | g1_1_1 | g1_2_0 | g1_2_1 | g1_4_0 | g1_4_1 | g2_0_0 | g2_1_0 | g2_2_0 | g2_3_0 | g2_4_0

Sheet: Fp12_comp_sqr
changed | seq_num | 演算名 | 項 | src0 | src1 | dst | md | me0 | me1 | pm1 | pm1 | pm2 | pm2 | cm | cm | cm | pom1 | pom1 | pom1 | pom2 | pom2 | pom2 | pom3 | pom3 | pom3 | pos | pos | poa2 | poa2 | poa3 | poa3 | os | inv | reg1 | reg2[0] | reg2[1] | reg2[2] | reg3[0] | reg3[1] | reg3[2] |  |  | addra0 | addrb0 | addra1 | addrb1
 | 奇数回目 |  |  |  |  |  |  |  |  |  |  |  |  |  |  |  |  |  |  |  |  |  |  |  |  |  |  |  |  |  |  |  |  | out
x | 0 |  | 3g2^2 | g2_0 | g2_1 |  | 0 | 0 | 0 | 0 | 0 | 0 | 0 | 1 | 1 | 0 | 0 | 0 | 0 | 0 | 0 | 0 | 0 | 0 | 1 | 0 | 0 | 0 | 0 | 0 | 0 | 0 | 0 | out |  |  |  | in |  |  | 0 | 100 | 0 | 102 | #6g2g3
x | 1 |  |  | g2_0 | g2_1 |  | 0 | 0 | 0 | 0 | 1 | 1 | 0 | 0 | 1 | 1 | 0 | 0 | 0 | 0 | 0 | 1 | 0 | 0 | 0 | 0 | 0 | 0 | 0 | 0 | 0 | 0 | 0 | out | in |  |  |  |  |  | 0 | 101 | 0 | 103 | #6g2g3
x | 2 |  | 3g3^2(1+i) | g3_0 | g3_1 |  | 0 | 0 | 0 | 0 | 0 | 0 | 0 | 1 | 1 | 0 | 0 | 0 | 0 | 0 | 1 | 1 | 0 | 1 | 0 | 0 | 0 | 0 | 0 | 0 | 0 | 0 | 0 | out |  |  |  |  |  |  | 0 | 100 | 0 | 101 | #3g2^2
x | 3 |  |  | g3_0 | g3_1 |  | 0 | 0 | 0 | 0 | 1 | 1 | 0 | 0 | 1 | 1 | 0 | 0 | 0 | 0 | 1 | 1 | 0 | 1 | 0 | 0 | 0 | 0 | 0 | 0 | 0 | 0 | 0 | out |  |  |  |  |  |  | 0 | 100 | 0 | 101 | #3g2^2
x | 4 |  | -2(g4) | g4_0 | R | h4_0 | 0 | 1 | 1 | 0 | 0 | 0 | 0 | 0 | 1 | 0 | 0 | 0 | 0 | 1 | 0 | 0 | 0 | 0 | 0 | 0 | 1 | 0 | 0 | 0 | 0 | 0 | 0 |  | out |  |  |  |  |  | 0 | 104 | 0 | 106 | #6g4g5
x | 5 |  |  | g4_1 | R | h4_1 | 0 | 1 | 1 | 0 | 0 | 0 | 0 | 0 | 1 | 0 | 0 | 0 | 0 | 0 | 0 | 0 | 1 | 0 | 0 | 1 | 0 | 0 | 0 | 0 | 0 | 0 | 0 |  |  |  |  | out |  |  | 0 | 105 | 0 | 107 | #6g4g5
 | 6 |  | 6g2g3 | g2_0 | g3_0 |  | 0 | 0 | 0 | 0 | 0 | 0 | 0 | 1 | 1 | 0 | 0 | 0 | 0 | 0 | 0 | 1 | 0 | 0 | 1 | 0 | 0 | 0 | 0 | 0 | 0 | 0 | 0 | out | in |  |  | in |  |  | 0 | 101 | 0 | 103 | #6g2g3
 | 7 |  |  | g2_1 | g3_1 |  | 0 | 0 | 0 | 0 | 0 | 0 | 0 | 1 | 1 | 0 | 0 | 0 | 0 | 1 | 0 | 0 | 0 | 1 | 0 | 0 | 0 | 0 | 0 | 0 | 0 | 0 | 0 | out |  |  |  |  |  |  | 0 | 102 | 0 | 103 | #3g3^2(1+i)
 | 8 |  |  | g2_1 | g3_1 |  | 0 | 0 | 0 | 1 | 0 | 0 | 1 | 1 | 1 | 0 | 0 | 0 | 0 | 0 | 0 | 0 | 0 | 1 | 1 | 0 | 0 | 0 | 0 | 0 | 0 | 0 | 0 | out |  |  |  |  |  |  | 0 | 102 | 0 | 103 | #3g3^2(1+i)
 | 9 |  | 2(g5) | g5_0 | R | h5_0 | 0 | 1 | 1 | 0 | 0 | 0 | 0 | 0 | 1 | 0 | 0 | 0 | 0 | 0 | 1 | 0 | 0 | 0 | 0 | 0 | 1 | 0 | 0 | 0 | 0 | 0 | 0 |  | out |  |  |  |  |  | 118 | 106 | 118 | 10 | #2g5 out : (6g2g3 + 2g5)_0 -> h5_0
 | 10 |  |  | g5_1 | R | h5_1 | 0 | 1 | 1 | 0 | 0 | 0 | 0 | 0 | 1 | 0 | 0 | 0 | 0 | 0 | 0 | 0 | 0 | 1 | 0 | 1 | 0 | 0 | 0 | 0 | 0 | 0 | 0 |  |  |  |  | out |  |  | 119 | 107 | 119 | 10 | #2g5 out : (6g2g3 + 2g5)_1 -> h5_1
x | 13 |  | 6g4g5(1+i) | g4_0 | g5_0 |  | 0 | 0 | 0 | 0 | 0 | 0 | 0 | 1 | 1 | 0 | 0 | 0 | 0 | 0 | 0 | 1 | 0 | 0 | 0 | 0 | 0 | 0 | 0 | 0 | 0 | 0 | 0 | out | in |  |  |  |  |  | 0 | 105 | 0 | 107 | #6g4g5
x | 14 |  |  | g4_1 | g5_1 |  | 0 | 0 | 0 | 0 | 0 | 0 | 0 | 1 | 1 | 0 | 0 | 0 | 0 | 0 | 0 | 0 | 0 | 0 | 1 | 0 | 0 | 0 | 0 | 0 | 0 | 0 | 0 | out |  |  |  | in |  |  | 0 | 104 | 0 | 106 | #6g4g5
x | 15 |  | acc=2acc | g4_0 | g5_0 |  |  |  | preadderの内部状態のためにsrcはg40/g50 |  |  |  |  |  |  |  |  |  |  | 1 | 1 | 1 | 1 | 1 | 1
 | 16 |  |  | g4_1 | g5_1 |  | 0 | 0 | 0 | 1 | 0 | 0 | 1 | 1 | 1 | 0 | 0 | 0 | 0 | 1 | 0 | 0 | 0 | 1 | 1 | 0 | 0 | 0 | 0 | 0 | 0 | 0 | 0 | out |  |  |  |  |  |  | 0 | 105 | 0 | 107 | #6g4g5
 | 11 |  | 2(g2) | g2_0 | R | h2_0 | 0 | 1 | 1 | 0 | 0 | 0 | 0 | 0 | 1 | 0 | 0 | 0 | 0 | 0 | 1 | 0 | 0 | 0 | 0 | 0 | 0 | 0 | 0 | 0 | 0 | 0 | 0 | out |  |  |  |  |  |  | 116 | 104 | 116 | 10 | #-2g4 out : (3g^3(1+i) + 3g2^2 - 2g4)_0 -> h4_0
 | 12 |  |  | g2_1 | R | h2_1 | 0 | 1 | 1 | 0 | 0 | 0 | 0 | 0 | 1 | 0 | 0 | 0 | 0 | 0 | 0 | 0 | 0 | 1 | 0 | 0 | 0 | 0 | 0 | 0 | 0 | 0 | 0 | out |  |  |  |  |  |  | 117 | 105 | 117 | 10 | #-2g4 out : (3g^3(1+i) + 3g2^2 - 2g4)_1 -> h4_1
 | 17 |  | -2(g3) | g3_0 | R |  | 0 | 0 | 0 | 0 | 0 | 0 | 0 | 0 | 1 | 0 | 0 | 0 | 0 | 0 | 0 | 1 | 0 | 0 | 0 | 1 | 0 | 0 | 0 | 0 | 0 | 0 | 0 |  | in |  |  | out |  |  | 0 | 106 | 0 | 107 | #3g5^2(1+i)
x | 18 |  |  | g3_1 | R |  | 0 | 0 | 0 | 0 | 0 | 0 | 0 | 0 | 1 | 0 | 0 | 0 | 0 | 0 | 0 | 0 | 0 | 0 | 1 | 0 | 0 | 0 | 0 | 0 | 0 | 0 | 0 | out |  |  |  | in |  |  | 0 | 106 | 0 | 107 | #3g5^2(1+i)
x | 19 |  | 3g5^2(1+i) | g5_0 | g5_1 |  | 0 | 0 | 0 | 0 | 0 | 0 | 0 | 1 | 1 | 0 | 0 | 0 | 0 | 0 | 1 | 0 | 0 | 1 | 1 | 0 | 0 | 0 | 0 | 0 | 0 | 0 | 0 | out |  |  |  |  |  |  | 0 | 104 | 0 | 105 | #3g4^2
x | 20 |  |  | g5_0 | g5_1 |  | 0 | 0 | 0 | 0 | 1 | 1 | 0 | 0 | 1 | 1 | 0 | 0 | 0 | 0 | 1 | 1 | 0 | 1 | 0 | 0 | 0 | 0 | 0 | 0 | 0 | 0 | 0 | out |  |  |  |  |  |  | 0 | 104 | 0 | 105 | #3g4^2
x | 21 |  | 3g4^2 | g4_0 | g4_1 | h3_1 | 0 | 1 | 1 | 0 | 0 | 0 | 0 | 1 | 1 | 0 | 0 | 0 | 0 | 0 | 0 | 0 | 0 | 1 | 0 | 1 | 0 | 0 | 0 | 0 | 0 | 0 | 0 |  |  |  |  | out |  |  | 112 | 100 | 112 | 10 | #2g2 out : (6g4g5(1+i) + 2g2)_0 -> h2_0
x | 22 |  |  | g4_0 | g4_1 | h3_0 | 0 | 1 | 1 | 0 | 1 | 1 | 0 | 0 | 1 | 1 | 0 | 0 | 0 | 0 | 1 | 0 | 0 | 0 | 0 | 0 | 1 | 0 | 0 | 0 | 0 | 0 | 0 |  | out |  |  |  |  |  | 113 | 101 | 113 | 10 | #2g2 out : (6g4g5(1+i) + 2g2)_1 -> h2_1
x | 23 |  |  | g1_0 | R | acc2 |  |  |  |  |  |  |  |  |  |  |  |  |  | 0 | 0 | 1
x | 24 |  |  | g1_1 | R | acc3 |  |  |  |  |  |  |  |  |  |  |  |  |  |  |  |  | 0 | 0 | 1
x | 25 |  | 3g3g5(1+i) | g3_0 | g5_0 |  | 0 | 0 | 0 | 0 | 0 | 0 | 0 | 1 | 1 | 0 | x | x | x | 0 | 1 | 1 | 0 | 0 | 0 | 0 | 0 | 0 | 0 | 0 | 0 | 0 | 0 | out |  |  |  |  |  |  | 114 | 102 | 114 | 10 | #-2g3 out : (3g5^2(1+i) + 3g4^2 - 2g3)_0 -> h3_0
x | 26 |  |  | g3_1 | g5_1 |  | 0 | 0 | 0 | 0 | 0 | 0 | 0 | 1 | 1 | 0 | x | x | x | 0 | 0 | 0 | 0 | 1 | 0 | 0 | 0 | 0 | 0 | 0 | 0 | 0 | 0 | out |  |  |  |  |  |  | 115 | 103 | 115 | 10 | #-2g3 out : (3g5^2(1+i) + 3g4^2 - 2g3)_1 -> h3_1
x | 27 |  |  | g3_1 | g5_1 |  | 0 | 0 | 0 | 1 | 0 | 0 | 1 | 0 | 1 | 1 | x | x | x | 1 | 0 | 0 | 0 | 1 | 1 | 0 | 0 | 0 | 0 | 0 | 0 | 0 | 0 | out |  |  |  |  |  |  | 0 | 102 | 0 | 106 | #3g3g5(1+i) - g1
x | 28 |  | 3g2g4 | g2_0 | g4_0 |  | 0 | 0 | 0 | 0 | 0 | 0 | 0 | 0 | 1 | 1 | x | x | x | 0 | 1 | 0 | 1 | 0 | 0 | 0 | 0 | 0 | 0 | 0 | 0 | 0 | 0 | out |  |  |  |  |  |  | 0 | 103 | 0 | 107 | #3g3g5(1+i) - g1
x | 29 |  |  | g2_1 | g4_1 | h1_0 | 0 | 1 | 1 | 0 | 0 | 0 | 0 | 0 | 1 | 1 | x | x | x | 1 | 0 | 0 | 1 | 0 | 0 | 0 | 1 | 0 | 0 | 0 | 0 | 0 | 0 |  | out |  |  |  |  |  | 0 | 103 | 0 | 107 | #3g3g5(1+i) - g1
x | 30 |  |  | g2_1 | g4_1 | h1_1 | 0 | 1 | 1 | 1 | 0 | 0 | 1 | 0 | 1 | 1 | x | x | x | 0 | 0 | 0 | 0 | 1 | 0 | 1 | 0 | 0 | 0 | 0 | 0 | 0 | 0 |  |  |  |  | out |  |  | 0 | 100 | 0 | 104 | #3g2g4+3g3g5(1+i) - g1
x | 31 |  | nop
x | 32 |  | nop
x | 33 |  | nop
 | 34 |  | nop
 | 35 |  | nop
 | 36 |  | nop
使ってない | 偶数回目 |  |  |  |  |  |  |  |  |  |  |  |  |  |  |  |  |  |  |  |  |  |  |  |  |  |  |  |  |  |  |  |  | out
 | 0 |  | 3g5^2(1+i) | g5_0 | g5_1 |  | 0 | 0 | 0 | 0 | 0 | 0 | 0 | 1 | 1 | 0 | 0 | 0 | 0 | 0 | 0 | 1 | 0 | 0 | 1 | 0 | 0 | 1 | 0 | 1 | 0 | 0 | 0 | out |  |  | in |  |  | in |  |  | 0 | 118 | 0 | 119 | #3g5^2(1+i)
 | 1 |  |  | g5_0 | g5_1 |  | 0 | 0 | 0 | 0 | 1 | 1 | 0 | 0 | 1 | 1 | 0 | 0 | 0 | 0 | 1 | 1 | 0 | 1 | 0 | 0 | 0 | 1 | 0 | 1 | 0 | 0 | 0 | out |  |  |  |  |  |  |  |  | 0 | 118 | 0 | 119 | #3g5^2(1+i)
 | 2 |  | 6g4g5(1+i) | g4_0 | g5_0 |  | 0 | 0 | 0 | 0 | 0 | 0 | 0 | 1 | 1 | 1 | 0 | 0 | 0 | 0 | 0 | 1 | 0 | 0 | 0 | 0 | 0 | 0 | 0 | 0 | 0 | 0 | 0 | out | in |  |  |  |  |  |  |  | 0 | 116 | 0 | 118 | #6g4g5(1+i)
 | 3 |  |  | g4_1 | g5_1 |  | 0 | 0 | 0 | 0 | 0 | 0 | 0 | 1 | 1 | 1 | 0 | 0 | 0 | 0 | 0 | 0 | 0 | 0 | 1 | 0 | 0 | 0 | 0 | 0 | 0 | 0 | 0 | out |  |  |  | in |  |  |  |  | 0 | 117 | 0 | 119 | #6g4g5(1+i)
 | 4 |  |  | g4_1 | g5_1 |  | 0 | 0 | 0 | 1 | 0 | 0 | 1 | 1 | 1 | 0 | 0 | 0 | 0 | 1 | 0 | 0 | 0 | 1 | 1 | 0 | 0 | 0 | 0 | 0 | 0 | 0 | 0 | out |  |  |  |  |  |  |  |  | 0 | 117 | 0 | 119 | #6g4g5(1+i)
 | 5 |  | 2(g2) | g2_0 | R | h2_0 | 0 | 1 | 1 | 0 | 0 | 0 | 0 | 0 | 1 | 0 | 0 | 0 | 0 | 0 | 1 | 0 | 0 | 0 | 0 | 0 | 1 | 0 | 0 | 0 | 0 | 0 | 0 |  | out |  |  |  |  |  |  |  | 100 | 112 | 100 | 10 | #2g2 out : (6g4g5(1+i) + 2g2)_0 -> h2_0
 | 6 |  |  | g2_1 | R | h2_1 | 0 | 1 | 1 | 0 | 0 | 0 | 0 | 0 | 1 | 0 | 0 | 0 | 0 | 0 | 0 | 0 | 0 | 1 | 0 | 1 | 0 | 0 | 0 | 0 | 0 | 0 | 0 |  |  |  |  | out |  |  |  |  | 101 | 113 | 101 | 10 | #2g2 out : (6g4g5(1+i) + 2g2)_1 -> h2_1
 | 7 |  | 3g4^2 | g4_0 | g4_1 |  | 0 | 0 | 0 | 0 | 0 | 0 | 0 | 1 | 1 | 0 | 0 | 0 | 0 | 0 | 0 | 0 | 0 | 1 | 0 | 0 | 0 | 1 | 0 | 1 | 0 | 0 | 0 | out |  |  |  |  |  |  |  |  | 0 | 116 | 0 | 117 | #3g4^2
 | 8 |  |  | g4_0 | g4_1 |  | 0 | 0 | 0 | 0 | 1 | 1 | 0 | 0 | 1 | 1 | 0 | 0 | 0 | 0 | 1 | 0 | 0 | 0 | 0 | 0 | 0 | 1 | 0 | 1 | 0 | 0 | 0 | out |  |  |  |  |  |  |  |  | 0 | 116 | 0 | 117 | #3g4^2
 | 9 |  | 2(g5) | g5_0 | R |  | 0 | 0 | 0 | 0 | 0 | 0 | 0 | 0 | 1 | 0 | 0 | 0 | 0 | 0 | 0 | 1 | 0 | 0 | 0 | 0 | 0 | 0 | 0 | 0 | 0 | 0 | 0 | out | in |  |  |  |  |  |  |  | 0 | 118 | 0 | 10 | #2g5
 | 10 |  |  | g5_1 | R |  | 0 | 0 | 0 | 0 | 0 | 0 | 0 | 0 | 1 | 0 | 0 | 0 | 0 | 0 | 0 | 0 | 0 | 0 | 1 | 0 | 0 | 0 | 0 | 0 | 0 | 0 | 0 | out |  |  |  | in |  |  |  |  | 0 | 119 | 0 | 10 | #2g5
 | 11 |  | -2(g3) | g3_0 | R | h3_0 | 0 | 1 | 1 | 0 | 0 | 0 | 0 | 0 | 1 | 0 | 0 | 0 | 0 | 1 | 0 | 0 | 0 | 0 | 0 | 0 | 1 | 1 | 0 | 1 | 0 | 0 | 0 |  |  |  | out |  |  |  |  |  | 102 | 114 | 102 | 10 | #-2g3 out : (3g5^2(1+i) + 3g4^2 - 2g3)_0 -> h3_0
 | 12 |  |  | g3_1 | R | h3_1 | 0 | 1 | 1 | 0 | 0 | 0 | 0 | 0 | 1 | 0 | 0 | 0 | 0 | 0 | 0 | 0 | 1 | 0 | 0 | 1 | 0 | 0 | 0 | 1 | 0 | 0 | 0 |  |  |  |  |  |  | out |  |  | 103 | 115 | 103 | 10 | #-2g3 out : (3g5^2(1+i) + 3g4^2 - 2g3)_1 -> h3_1
 | 13 |  | 6g2g3 | g2_0 | g3_0 |  | 0 | 0 | 0 | 0 | 0 | 0 | 0 | 1 | 1 | 0 | 0 | 0 | 0 | 0 | 1 | 0 | 0 | 1 | 1 | 0 | 0 | 0 | 0 | 0 | 0 | 0 | 0 | out |  |  |  |  |  |  |  |  | 0 | 112 | 0 | 114 | #6g2g3
 | 14 |  |  | g2_1 | g3_1 | h5_0 | 0 | 1 | 1 | 0 | 0 | 0 | 0 | 1 | 1 | 0 | 0 | 0 | 0 | 1 | 0 | 0 | 0 | 1 | 0 | 0 | 1 | 0 | 0 | 0 | 0 | 0 | 0 |  | out |  |  |  |  |  |  |  | 106 | 113 | 106 | 115 | #6g2g3 out : (6g2g3 + 2g5)_0 -> h5_0
 | 15 |  |  | g2_1 | g3_1 | h5_1 | 0 | 1 | 1 | 1 | 0 | 0 | 1 | 1 | 1 | 0 | 0 | 0 | 0 | 0 | 0 | 0 | 0 | 1 | 1 | 1 | 0 | 0 | 0 | 0 | 0 | 0 | 0 |  |  |  |  | out |  |  |  |  | 107 | 113 | 107 | 115 | #6g2g3 out : (6g2g3 + 2g5)_1 -> h5_1
 | 16 |  | 3g3^2(1+i) | g3_0 | g3_1 |  | 0 | 0 | 0 | 0 | 0 | 0 | 0 | 1 | 1 | 0 | 0 | 0 | 0 | 0 | 0 | 1 | 0 | 0 | 1 | 0 | 0 | 1 | 0 | 1 | 0 | 0 | 0 | out |  |  | in |  |  | in |  |  | 0 | 114 | 0 | 115 | #3g3^2(1+i)
 | 17 |  |  | g3_0 | g3_1 |  | 0 | 0 | 0 | 0 | 1 | 1 | 0 | 0 | 1 | 1 | 0 | 0 | 0 | 0 | 1 | 1 | 0 | 1 | 0 | 0 | 0 | 1 | 0 | 1 | 0 | 0 | 0 | out |  |  |  |  |  |  |  |  | 0 | 114 | 0 | 115 | #3g3^2(1+i)
 | 18 |  | 3g2^2 | g2_0 | g2_1 |  | 0 | 0 | 0 | 0 | 0 | 0 | 0 | 1 | 1 | 0 | 0 | 0 | 0 | 0 | 0 | 0 | 0 | 1 | 0 | 0 | 0 | 1 | 0 | 1 | 0 | 0 | 0 | out |  |  |  |  |  |  |  |  | 0 | 112 | 0 | 113 | #3g2^2
 | 19 |  |  | g2_0 | g2_1 |  | 0 | 0 | 0 | 0 | 1 | 1 | 0 | 0 | 1 | 1 | 0 | 0 | 0 | 0 | 1 | 0 | 0 | 0 | 0 | 0 | 0 | 1 | 0 | 1 | 0 | 0 | 0 | out |  |  |  |  |  |  |  |  | 0 | 112 | 0 | 113 | #3g2^2
 | 20 |  | -2(g4) | g4_0 | R | h4_0 | 0 | 1 | 1 | 0 | 0 | 0 | 0 | 0 | 1 | 0 | 0 | 0 | 0 | 1 | 0 | 0 | 0 | 0 | 0 | 0 | 1 | 1 | 0 | 1 | 0 | 0 | 0 |  |  |  | out |  |  |  |  |  | 104 | 116 | 104 | 10 | #-2g4 out : (3g3^2(1+i) + 3g2^2 - 2g4)_0 -> h4_0
 | 21 |  |  | g4_1 | R | h4_1 | 0 | 1 | 1 | 0 | 0 | 0 | 0 | 0 | 1 | 0 | 0 | 0 | 0 | 0 | 0 | 0 | 1 | 0 | 0 | 1 | 0 | 0 | 0 | 1 | 0 | 0 | 0 |  |  |  |  |  |  | out |  |  | 105 | 117 | 105 | 10 | #-2g4 out : (3g3^2(1+i) + 3g2^2 - 2g4)_1 -> h4_1
 | 22 |  | 3g3g5(1+i) | g3_0 | g5_0 |  | 0 | 0 | 0 | 0 | 0 | 0 | 0 | 1 | 1 | 0 | x | x | x | 0 | 1 | 1 | 0 | 0 | 0 | x | x | 0 | 1 | 0 | 1 | 0 | 0 | out |  |  |  |  |  |  |  |  | 0 | 114 | 0 | 118 | #3g3g5(1+i) - g1
 | 23 |  |  | g3_1 | g5_1 |  | 0 | 0 | 0 | 0 | 0 | 0 | 0 | 1 | 1 | 0 | x | x | x | 0 | 0 | 0 | 0 | 1 | 0 | x | x | 0 | 1 | 0 | 1 | 0 | 0 | out |  |  |  |  |  |  |  |  | 0 | 115 | 0 | 119 | #3g3g5(1+i) - g1
 | 24 |  |  | g3_1 | g5_1 |  | 0 | 0 | 0 | 1 | 0 | 0 | 1 | 0 | 1 | 1 | x | x | x | 1 | 0 | 0 | 0 | 1 | 1 | x | x | 0 | 1 | 0 | 1 | 0 | 0 | out |  |  |  |  |  |  |  |  | 0 | 115 | 0 | 119 | #3g3g5(1+i) - g1
 | 25 |  | 3g2g4 | g2_0 | g4_0 |  | 0 | 0 | 0 | 0 | 0 | 0 | 0 | 0 | 1 | 1 | x | x | x | 0 | 1 | 0 | 1 | 0 | 0 | x | x | 0 | 1 | 0 | 1 | 0 | 0 | out |  |  |  |  |  |  |  |  | 0 | 112 | 0 | 116 | #3g2g4+3g3g5(1+i) - g1
 | 26 |  |  | g2_1 | g4_1 | save g1_0 | 0 | 0 | 0 | 0 | 0 | 0 | 0 | 0 | 1 | 1 | x | x | x | 1 | 0 | 0 | 1 | 0 | 0 | 0 | 1 | 0 | 1 | 0 | 1 | 0 | 0 |  |  | out |  |  |  |  |  |  | 98 | 113 | 98 | 117 | #3g2g4+3g3g5(1+i) - g1
 | 27 |  |  | g2_1 | g4_1 | save g1_1 | 0 | 0 | 0 | 1 | 0 | 0 | 1 | 0 | 1 | 1 | x | x | x | 0 | 0 | 0 | 0 | 1 | 0 | 1 | 0 | 0 | 1 | 0 | 1 | 0 | 0 |  |  |  |  |  | out |  |  |  | 99 | 113 | 99 | 117 | #3g2g4+3g3g5(1+i) - g1save : g1

Sheet: Fp12_decomp
changed | seq_num | 演算名 | 項 | src0 | src1 | dst | md | me0 | me1 | pm1 | pm1 | pm2 | pm2 | cm | cm | cm | pom1 | pom1 | pom1 | pom2 | pom2 | pom2 | pom3 | pom3 | pom3 | pos | pos | poa2 | poa2 | poa3 | poa3 | os | inv | reg1 | reg2[0] | reg2[1] | reg2[2] | reg3[0] | reg3[1] | reg3[2]
 |  |  |  |  |  |  |  |  |  |  |  |  |  |  |  |  |  |  |  |  |  |  |  |  |  |  |  |  |  |  |  |  |  | out
x | 0 | c55g2 * c55g5(1+i) |  | c55g2_0 | c55g5_0 |  | 0 | 0 | 0 | 0 | 0 | 0 | 0 | 0 | 1 | 0 | x | x | x | 0 | 0 | 1 | x | x | x | x | x | 0 | 0 | x | x | 0 | 0 | out | in
x | 1 |  |  | c55g2_1 | c55g5_1 | acc2(poa:2) | 0 | 0 | 0 | 0 | 0 | 0 | 0 | 0 | 1 | 0 | x | x | x | 0 | 0 | 0 | 0 | 0 | 1 | x | x | 0 | 0 | 0 | 0 | 0 | 0 | out |  |  |  | in
x | 2 |  |  | c55g2_1 | c55g5_1 | acc3(poa:2) | 0 | 0 | 0 | 1 | 0 | 0 | 1 | 0 | 0 | 1 | x | x | x | 1 | 0 | 0 | 0 | 1 | 1 | x | x | 0 | 0 | 0 | 0 | 0 | 0 | out
x | 3 | - 3 * c55g3 * c55g4(1+i) |  | c55g3_0 | c55g4_0 |  | 0 | 0 | 0 | 0 | 0 | 0 | 0 | 1 | 1 | 0 | x | x | x | 1 | 0 | 0 | 0 | 0 | 0 | x | x | 0 | 0 | 0 | 0 | 0 | 0 | out
x | 4 |  |  | c55g3_1 | c55g4_1 | acc2(poa:2) | 0 | 0 | 0 | 0 | 0 | 0 | 0 | 1 | 1 | 0 | x | x | x | 0 | 0 | 0 | 0 | 1 | 0 | x | x | 0 | 0 | 0 | 0 | 0 | 0 | out
x | 5 |  |  | c55g3_1 | c55g4_1 | acc3(poa:2) | 0 | 0 | 0 | 1 | 0 | 0 | 1 | 0 | 1 | 1 | x | x | x | 0 | 1 | 0 | 1 | 0 | 0 | x | x | 0 | 0 | 0 | 0 | 0 | 0 | out
x | 6 | Add 1 |  | R | R | acc2(poa:2) | 0 | 0 | 0 | 0 | 0 | 0 | 0 | 0 | 0 | 1 | x | x | x | 0 | 1 | 0 | 0 | 0 | 0 | x | x | 0 | 0 | 0 | 0 | 0 | 0 | out
x | 7 |  | 2c55g1^2(1+i) | c55g1_0 | c55g1_1 |  | 0 | 0 | 0 | 0 | 0 | 0 | 0 | 1 | 0 | 0 | x | x | x | 1 | 0 | 0 | 0 | 1 | 0 | x | x | 0 | 0 | 0 | 0 | 0 | 0 | out
x | 8 |  |  | c55g1_0 | c55g1_1 | c55g0_0 | 0 | 1 | 1 | 0 | 1 | 1 | 0 | 0 | 1 | 0 | x | x | x | 0 | 1 | 0 | 0 | 1 | 0 | 0 | 1 | 0 | 0 | 0 | 0 | 0 | 0 |  | out
x | 9 |  |  | - | - | c55g0_1 | 0 | 1 | 1 | 0 | 0 | 0 | 0 | 0 | 1 | 0 | x | x | x | x | x | x | 0 | 0 | 0 | 1 | 0 | x | x | 0 | 0 | 0 | 0 |  |  |  |  | out

Sheet: Fp12_conj
changed | seq_num | 演算名 | 項 | src0 | src1 | dst | md | me0 | me1 | pm1 | pm1 | pm2 | pm2 | cm | cm | cm | pom1 | pom1 | pom1 | pom2 | pom2 | pom2 | pom3 | pom3 | pom3 | pos | pos | poa2 | poa2 | poa3 | poa3 | os | inv | reg1 | reg2[0] | reg2[1] | reg2[2] | reg3[0] | reg3[1] | reg3[2] |  |  | addra0 | addrb0 | addra1 | addrb1
 |  |  |  |  |  |  |  |  |  |  |  |  |  |  |  |  |  |  |  |  |  |  |  |  |  |  |  |  |  |  |  |  |  | out
 | 0 |  | p-f5 | f5_0 | R | g5_0 | 0 | 1 | 1 | 0 | 0 | 0 | 0 | 0 | 0 | 1 | 0 | 0 | 0 | 1 | 1 | 0 | 0 | 0 | 0 | 0 | 1 | 0 | 0 | 0 | 0 | 0 | 0 |  | out |  |  |  |  |  | 0 | 100 | 0 | 102 | #6g2g3
 | 1 |  |  | f5_1 | R | g5_1 | 0 | 1 | 1 | 0 | 0 | 0 | 0 | 0 | 0 | 1 | 0 | 0 | 0 | 1 | 1 | 0 | 0 | 0 | 0 | 0 | 1 | 0 | 0 | 0 | 0 | 0 | 0
 |  |  | f0 | f0_0 | R | g0_0 | 0 | 1 | 1 | 0 | 0 | 0 | 0 | 0 | 0 | 1 | 0 | 0 | 0 | 0 | 0 | 1 | 0 | 0 | 0 | 0 | 1 | 0 | 0 | 0 | 0 | 0 | 0
 |  |  |  | f0_1 | R | g0_1 | 0 | 1 | 1 | 0 | 0 | 0 | 0 | 0 | 0 | 1 | 0 | 0 | 0 | 0 | 0 | 1 | 0 | 0 | 0 | 0 | 1 | 0 | 0 | 0 | 0 | 0 | 0
 |  |  | p-f3
 |  |  | f2
 |  |  | p-f1
 |  |  | f4

Sheet: ML_1
changed | seq_num | 演算名 | 項 | src0 | src1 | dst | md | me0 | me1 | pm1 | pm1 | pm2 | pm2 | cm | cm | cm | pom1 | pom1 | pom1 | pom2 | pom2 | pom2 | pom3 | pom3 | pom3 | pos | pos | poa2 | poa2 | poa3 | poa3 | os |  | reg1 | reg2[0] | reg2[1] | reg2[2] | reg3[0] | reg3[1] | reg3[2]
 |  |  |  |  |  |  | 0 | 1 | 2 | 3 | 4 | 5 | 6 | 7 | 8 | 9 | 10 | 11 | 12 | 13 | 14 | 15 | 16 | 17 | 18 | 19 | 20 | 21 | 22 | 23 | 24 | 25 | 対応演算
x | 1 |  | y^2 | y_0 | y_1 | A_1 | 0 | 1 | 1 | 0 | 0 | 0 | 0 | 0 | 1 | 0 | 0 | 0 | 1 | x | x | x | 0 | 0 | 1 | 0 | 0 | x | x | 0 | 0 | 0 |  | in |  |  |  | in
x | 2 |  | y^2 | y_0 | y_1 | A_0 | 0 | 1 | 1 | 0 | 1 | 1 | 0 | 0 | 0 | 1 | 0 | 0 | 1 | x | x | x | 0 | 0 | 1 | 0 | 0 | x | x | 0 | 0 | 0 |  | in |  |  |  | in
 | 3 |  | 3b'z^2 | z_0 | z_1 | - | 0 | 0 | 0 | 0 | 0 | 0 | 0 | 1 | 1 | 0 | 0 | 0 | 1 | 0 | 0 | 1 | x | x | x | x | x | 0 | 0 | x | x | 0 |  | in | in
 | 4 |  | 3b'z^2 | z_0 | z_1 | B_0 | 0 | 1 | 1 | 0 | 1 | 1 | 0 | 0 | 1 | 1 | 0 | 1 | 0 | 1 | 0 | 0 | x | x | x | 0 | 0 | 0 | 0 | x | x | 0 |  | out
 | 5 |  | 3b'z^2 | 2xy | x_0 | y_0 | B_1 | 0 | 1 | 1 | 0 | 0 | 0 | 0 | 0 | 1 | 0 | 0 | 0 | 1 | 0 | 0 | 0 | 0 | 0 | 1 | 0 | 1 | 0 | 0 | 0 | 0 | 0 |  | in | out |  |  | in
 | 6 |  | 2xy | x_1 | y_1 | C_0 | 0 | 1 | 1 | 0 | 0 | 0 | 0 | 0 | 1 | 0 | 1 | 0 | 0 | x | x | x | 0 | 1 | 0 | 0 | 0 | x | x | 0 | 0 | 0 |  | out
 | 7 |  | 2xy | x_1 | y_1 | C_1 | 0 | 1 | 1 | 1 | 0 | 0 | 1 | 0 | 1 | 0 | x | x | x | x | x | x | 0 | 1 | 1 | 1 | 0 | x | x | 0 | 0 | 0 |  |  |  |  |  | out
 | 8 |  | 3x^2 | x_0 | x_1 | D_1 | 0 | 1 | 1 | 0 | 0 | 0 | 0 | 1 | 1 | 0 | 0 | 0 | 1 | x | x | x | x | x | x | 0 | 0 | x | x | x | x | 0 |  | in
 | 9 |  | 3x^2 | x_0 | x_1 | D_0 | 0 | 1 | 1 | 0 | 1 | 1 | 0 | 0 | 1 | 1 | 0 | 0 | 1 | x | x | x | x | x | x | 0 | 0 | x | x | x | x | 0 |  | in
 | 10 |  | 2yz | y_0 | z_0 | - | 0 | 0 | 0 | 0 | 0 | 0 | 0 | 0 | 1 | 0 | 0 | 0 | 1 | 0 | 0 | 1 | x | x | x | 0 | 0 | 0 | 0 | x | x | 0 |  | in | in
 | 11 |  | 2yz | y_1 | z_1 | E_0 | 0 | 1 | 1 | 0 | 0 | 0 | 0 | 0 | 1 | 0 | 1 | 0 | 0 | 0 | 1 | 0 | x | x | x | 0 | 0 | 0 | 0 | x | x | 0 |  | out
 | 12 |  | 2yz | y_1 | z_1 | E_1 | 0 | 1 | 1 | 1 | 0 | 0 | 1 | 0 | 1 | 0 | x | x | x | 0 | 0 | 1 | 0 | 0 | 1 | 0 | 1 | 0 | 0 | x | x | 0 |  |  | in |  |  | in
 | 13 | f0^2 | f3^2(1+i) | f3_0 | f3_1 | - | 0 | 0 | 0 | 0 | 0 | 0 | 0 | 0 | 1 | 0 | x | x | x | 0 | 1 | 1 | 0 | 1 | 0 | x | x | x | x | 0 | 0 | 0 |  | out
 | 14 |  | f3^2(1+i) | f3_0 | f3_1 | acc2/acc3 | 0 | 0 | 0 | 0 | 1 | 1 | 0 | 0 | 0 | 1 | x | x | x | 0 | 0 | 1 | 0 | 0 | 0 | x | x | 0 | 0 | 0 | 0 | 0 |  | out | in
 | 15 |  | 2f4f2(1+i) | f4_0 | f2_0 |  | 0 | 0 | 0 | 0 | 0 | 0 | 0 | 1 | 0 | 0 | x | x | x | 0 | 1 | 0 | 0 | 0 | 0 | x | x | 0 | 0 | 0 | 0 | 0 |  | out
 | 16 |  | 2f4f2(1+i) | f4_1 | f2_1 |  | 0 | 0 | 0 | 0 | 0 | 0 | 0 | 1 | 0 | 0 | x | x | x | 0 | 0 | 0 | 1 | 0 | 0 | x | x | 0 | 0 | 0 | 0 | 0 |  | out
 | 17 |  | 2f4f2(1+i) | f4_1 | f2_1 | acc2/acc3 | 0 | 0 | 0 | 1 | 0 | 0 | 1 | 0 | 1 | 0 | x | x | x | 1 | 0 | 0 | 0 | 1 | 0 | x | x | 0 | 0 | 0 | 0 | 0 |  | out
 | 18 |  | 2f5f1(1+i) | f5_0 | f1_0 |  | 0 | 0 | 0 | 0 | 0 | 0 | 0 | 1 | 0 | 0 | x | x | x | 0 | 1 | 0 | 0 | 0 | 0 | x | x | 0 | 0 | 0 | 0 | 0 |  | out
 | 19 |  | 2f5f1(1+i) | f5_1 | f1_1 |  | 0 | 0 | 0 | 0 | 0 | 0 | 0 | 1 | 0 | 0 | x | x | x | 0 | 0 | 0 | 1 | 0 | 0 | x | x | 0 | 0 | 0 | 0 | 0 |  | out
 | 20 |  | 2f5f1(1+i) | f5_1 | f1_1 | acc2/acc3 | 0 | 0 | 0 | 1 | 0 | 0 | 1 | 0 | 1 | 0 | x | x | x | 1 | 0 | 0 | 0 | 1 | 0 | x | x | 0 | 0 | 0 | 0 | 0 |  | out
 | 21 |  | f0^2 | f0_0 | f0_1 | f0_1 | 0 | 1 | 1 | 0 | 0 | 0 | 0 | 0 | 1 | 0 | x | x | x | 0 | 0 | 0 | 0 | 1 | 0 | 1 | 0 | 0 | 0 | 0 | 0 | 0 |  |  |  |  |  | out
 | 22 |  | f0^2 | f0_0 | f0_1 | f0_0 | 0 | 1 | 1 | 0 | 1 | 1 | 0 | 0 | 0 | 1 | x | x | x | 0 | 1 | 0 | x | x | x | 0 | 1 | 0 | 0 | x | x | 0 |  |  | out
 | 23 | f1^2 | 2f5f2(1+i) | f5_0 | f2_0 |  | 0 | 0 | 0 | 0 | 0 | 0 | 0 | 1 | 0 | 0 | x | x | x | 0 | 0 | 1 | x | x | x | x | x | 0 | 0 | 0 | 0 | 0 |  | out | in
 | 24 |  | 2f5f2(1+i) | f5_1 | f2_1 | acc2 | 0 | 0 | 0 | 0 | 0 | 0 | 0 | 1 | 0 | 0 | x | x | x | 0 | 0 | 0 | 0 | 0 | 1 | x | x | 0 | 0 | 0 | 0 | 0 |  | out |  |  |  | in
 | 25 |  | 2f5f2(1+i) | f5_1 | f2_1 | acc3 | 0 | 0 | 0 | 1 | 0 | 0 | 1 | 0 | 1 | 0 | x | x | x | 1 | 0 | 0 | 0 | 1 | 1 | x | x | 0 | 0 | 0 | 0 | 0 |  | out
 | 26 |  | 2f4f3(1+i) | f4_0 | f3_0 |  | 0 | 0 | 0 | 0 | 0 | 0 | 0 | 1 | 0 | 0 | x | x | x | 0 | 1 | 0 | 0 | 0 | 0 | x | x | 0 | 0 | 0 | 0 | 0 |  | out
 | 27 |  | 2f4f3(1+i) | f4_1 | f3_1 | acc2 | 0 | 0 | 0 | 0 | 0 | 0 | 0 | 1 | 0 | 0 | x | x | x | 0 | 0 | 0 | 1 | 0 | 0 | x | x | 0 | 0 | 0 | 0 | 0 |  | out
 | 28 |  | 2f4f3(1+i) | f4_1 | f3_1 | acc3 | 0 | 0 | 0 | 1 | 0 | 0 | 1 | 0 | 1 | 0 | x | x | x | 1 | 0 | 0 | 0 | 1 | 0 | x | x | 0 | 0 | 0 | 0 | 0 |  | out
 | 29 |  | 2f1f0 | f1_0 | f0_0 |  | 0 | 0 | 0 | 0 | 0 | 0 | 0 | 0 | 1 | 0 | x | x | x | 0 | 1 | 0 | 1 | 0 | 0 | x | x | 0 | 0 | 0 | 0 | 0 |  | out
 | 30 |  | 2f1f0 | f1_1 | f0_1 | f1_0 | 0 | 1 | 1 | 0 | 0 | 0 | 0 | 0 | 1 | 0 | x | x | x | 1 | 0 | 0 | 1 | 0 | 0 | 0 | 1 | 0 | 0 | 0 | 0 | 0 |  |  | out
 | 31 |  | 2f1f0 | f1_1 | f0_1 | f1_1 | 0 | 1 | 1 | 1 | 0 | 0 | 1 | 0 | 1 | 0 | x | x | x | 0 | 0 | 0 | 0 | 1 | 0 | 1 | 0 | 0 | 0 | 0 | 0 | 0 |  |  |  |  |  | out
x | 32 |  |  | A_0 | Ri |  | 0 | 1 | 1 | 0 | 0 | 0 | 0 | 0 | 0 | 1 | 0 | 0 | 1 | x | x | x | x | x | x | x | x | x | x | x | x | 0 | 0 | out
x | 33 |  | l3 | B_0 | Ri | A_0-B_0 | 0 | 1 | 1 | 0 | 0 | 0 | 0 | 0 | 0 | 1 | 1 | 0 | 0 | x | x | x | x | x | x | 0 | 0 | x | x | x | x | 0 | 0 | out
x | 34 |  | 9b'z^2 | B_0 | Ri | A_0-3B_0 |  |  |  |  |  |  |  |  |  |  |  |  |  |  |  |  |  |  |  |  |  |  |  |  |  |  |  | out
x | 35 |  | l3 | B_1 | Ri | A_1-B_1 | 0 | 1 | 1 | 0 | 0 | 0 | 0 | 0 | 0 | 1 | x | x | x | x | x | x | 1 | 0 | 0 | 1 | 0 | x | x | 0 | 0 |  | 0 | out |  |  |  | out
x | 36 |  | 9b'z^2 | B_1 | Ri | A_1-3B_1 | 0 | 1 | 1 | 0 | 0 | 0 | 0 | 0 | 1 | 0 | x | x | x | x | x | x | 1 | 0 | 0 | 1 | 0 | x | x | 0 | 0 |  | 0 | out |  |  |  | out
x | 37 |  |  |  |  |  |  |  |  |  |  |  |  |  |  |  |  |  |  |  |  |  |  |  |  |  |  |  |  |  |  |  |  | out
 | 38 | f2^2 | f4^2(1+i) | f4_0 | f4_1 |  | 0 | 0 | 0 | 0 | 0 | 0 | 0 | 0 | 1 | 0 | x | x | x | 0 | 0 | 1 | 0 | 0 | 1 | x | x | x | x | 0 | 0 | 0 |  | out | in |  |  | in
 | 39 |  | f4^2(1+i) | f4_0 | f4_1 |  | 0 | 0 | 0 | 0 | 1 | 1 | 0 | 0 | 0 | 1 | x | x | x | 0 | 1 | 1 | 0 | 1 | 0 | x | x | 0 | 0 | 0 | 0 | 0 |  | out
 | 40 |  | 2f5f3(1+i) | f5_0 | f3_0 |  | 0 | 0 | 0 | 0 | 0 | 0 | 0 | 1 | 0 | 0 | x | x | x | 0 | 1 | 0 | 0 | 0 | 0 | x | x | 0 | 0 | 0 | 0 | 0
 | 41 |  | 2f5f3(1+i) | f5_1 | f3_1 |  | 0 | 0 | 0 | 0 | 0 | 0 | 0 | 1 | 0 | 0 | x | x | x | 0 | 0 | 0 | 1 | 0 | 0 | x | x | 0 | 0 | 0 | 0 | 0
 | 42 |  | 2f5f3(1+i) | f5_1 | f3_1 |  | 0 | 0 | 0 | 1 | 0 | 0 | 1 | 0 | 1 | 0 | x | x | x | 1 | 0 | 0 | 0 | 1 | 0 | x | x | 0 | 0 | 0 | 0 | 0 |  | in
 | 43 |  | 2f2f0 | f2_0 | f0_0 |  | 0 | 0 | 0 | 0 | 0 | 0 | 0 | 0 | 1 | 0 | x | x | x | 0 | 1 | 0 | 1 | 0 | 0 | x | x | 0 | 0 | 0 | 0 | 0 |  | in
 | 44 |  | 2f2f0 | f2_1 | f0_1 |  | 0 | 1 | 1 | 0 | 0 | 0 | 0 | 0 | 1 | 0 | x | x | x | 1 | 0 | 0 | 1 | 0 | 0 | x | x | 0 | 0 | 0 | 0 | 0 |  | in
 | 45 |  | 2f2f0 | f2_1 | f0_1 |  | 0 | 1 | 1 | 1 | 0 | 0 | 1 | 0 | 1 | 0 | x | x | x | 0 | 0 | 0 | 0 | 1 | 0 | x | x | 0 | 0 | 0 | 0 | 0 |  | out
 | 46 |  | f1^2 | f1_0 | f1_1 | f2_1 | 0 | 1 | 0 | 0 | 0 | 0 | 0 | 0 | 1 | 0 | x | x | x | 0 | 0 | 0 | 0 | 1 | 0 | 1 | 0 | 0 | 0 | 0 | 0 | 0 |  | in | in |  |  | out
 | 47 |  | f1^2 | f1_0 | f1_1 | f2_0 | 0 | 1 | 0 | 0 | 1 | 1 | 0 | 0 | 0 | 1 | x | x | x | 0 | 1 | 0 | x | x | x | 0 | 1 | 0 | 0 | x | x | 0 |  | out
 | 48 |  | ypE | yp | E_0 | l0_0 | 0 | 1 | 1 | 0 | 0 | 0 | 0 | 0 | 0 | 1 | 0 | 0 | 1 | x | x | x | x | x | x | 0 | 0 | x | x | x | x | 0 |  |  | out
 | 49 |  | ypE | yp | E_1 | l0_1 | 0 | 1 | 1 | 0 | 0 | 0 | 0 | 0 | 0 | 1 | 0 | 0 | 1 | x | x | x | x | x | x | 0 | 0 | x | x | x | x | 0 |  | out | in
 | 50 |  | xp~D | xp | D_0 | l1_0 | 0 | 0 | 0 | 0 | 0 | 0 | 0 | 0 | 0 | 1 | 0 | 0 | 1 | x | x | x | x | x | x | 0 | 0 | x | x | x | x | 0 |  | out
 | 51 |  | xp~D | xp | D_1 | l1_1 | 0 | 1 | 1 | 0 | 0 | 0 | 0 | 0 | 0 | 1 | 1 | 0 | 1 | x | x | x | 0 | 0 | 1 | 0 | 0 | x | x | x | x | 0 |  | out |  |  |  | in
 | 52 |  | 4AE | A_0 | E_0 |  | 0 | 1 | 1 | 0 | 0 | 0 | 0 | 0 | 0 | 1 | 0 | 0 | 1 | 0 | 0 | 1 | 1 | 0 | 1 | 1 | 0 | 0 | 0 | x | x | 0 |  | out
 | 53 |  | 4AE | A_1 | E_1 | z3_0=z1_0 | 0 | 1 | 1 | 0 | 0 | 0 | 0 | 0 | 0 | 1 | 1 | 0 | 0 | 0 | 1 | 0 | x | x | x | 0 | 0 | 0 | 0 | x | x | 0 |  | out
 | 54 |  | 4AE | A_1 | E_1 | z3_1=z1_1 | 0 | 1 | 1 | 1 | 0 | 0 | 1 | 0 | 0 | 1 | x | x | x | 0 | 1 | 1 | x | x | x | 0 | 1 | 0 | 0 | x | x | 0 |  | out
 | 55 | f3^2 | 2f5f4(1+i) | f5_0 | f4_0 |  | 0 | 0 | 0 | 0 | 0 | 0 | 0 | 1 | 0 | 0 | x | x | x | 0 | 0 | 1 | x | x | x | x | x | 0 | 0 | 0 | 0 | 0 |  | out
 | 56 |  | 2f5f4(1+i) | f5_1 | f4_1 |  | 0 | 0 | 0 | 0 | 0 | 0 | 0 | 1 | 0 | 0 | x | x | x | 0 | 0 | 0 | 0 | 0 | 1 | x | x | 0 | 0 | 0 | 0 | 0 |  |  | out |  |  | in
 | 57 |  | 2f5f4(1+i) | f5_1 | f4_1 |  | 0 | 0 | 0 | 1 | 0 | 0 | 1 | 0 | 1 | 0 | x | x | x | 1 | 0 | 0 | 0 | 1 | 1 | x | x | 0 | 0 | 0 | 0 | 0
 | 58 |  | 2f3f0 | f3_0 | f0_0 |  | 0 | 0 | 0 | 0 | 0 | 0 | 0 | 0 | 1 | 0 | x | x | x | 0 | 1 | 0 | 1 | 0 | 0 | x | x | 0 | 0 | 0 | 0 | 0 |  | out | in
 | 59 |  | 2f3f0 | f3_1 | f0_1 |  | 0 | 0 | 0 | 0 | 0 | 0 | 0 | 0 | 1 | 0 | x | x | x | 1 | 0 | 0 | 1 | 0 | 0 | x | x | 0 | 0 | 0 | 0 | 0 |  | out
 | 60 |  | 2f3f0 | f3_1 | f0_1 |  | 0 | 0 | 0 | 1 | 0 | 0 | 1 | 0 | 1 | 0 | x | x | x | 0 | 0 | 0 | 0 | 1 | 0 | x | x | 0 | 0 | 0 | 0 | 0 |  | out
 | 61 |  | 2f2f1 | f2_0 | f1_0 |  | 0 | 0 | 0 | 0 | 0 | 0 | 0 | 0 | 1 | 0 | x | x | x | 0 | 1 | 0 | 1 | 0 | 0 | x | x | 0 | 0 | 0 | 0 | 0 |  | out
 | 62 |  | 2f2f1 | f2_1 | f1_1 | f3_0 | 0 | 1 | 1 | 0 | 0 | 0 | 0 | 0 | 1 | 0 | x | x | x | 1 | 0 | 0 | 1 | 0 | 0 | 0 | 1 | 0 | 0 | 0 | 0 | 0 |  | out
 | 63 |  | 2f2f1 | f2_1 | f1_1 | f3_1 | 0 | 1 | 1 | 1 | 0 | 0 | 1 | 0 | 1 | 0 | x | x | x | 0 | 0 | 0 | 0 | 1 | 0 | 1 | 0 | 0 | 0 | 0 | 0 | 0 |  | out |  |  |  | out
 | 64 | f4^2 | f5^2(1+i) | f5_0 | f5_1 |  | 0 | 0 | 0 | 0 | 0 | 0 | 0 | 0 | 1 | 0 | x | x | x | 0 | 0 | 1 | 0 | 0 | 1 | x | x | x | x | 0 | 0 | 0 |  | out |  |  |  | in
 | 65 |  | f5^2(1+i) | f5_0 | f5_1 |  | 0 | 0 | 0 | 0 | 1 | 1 | 0 | 0 | 0 | 1 | x | x | x | 0 | 1 | 1 | 0 | 1 | 0 | x | x | 0 | 0 | 0 | 0 | 0 |  | out
 | 66 |  | 2f4f0 | f4_0 | f0_0 |  | 0 | 0 | 0 | 0 | 0 | 0 | 0 | 0 | 1 | 0 | x | x | x | 0 | 1 | 0 | 1 | 0 | 0 | x | x | 0 | 0 | 0 | 0 | 0
 | 67 |  | 2f4f0 | f4_1 | f0_1 |  | 0 | 0 | 0 | 0 | 0 | 0 | 0 | 0 | 1 | 0 | x | x | x | 1 | 0 | 0 | 1 | 0 | 0 | x | x | 0 | 0 | 0 | 0 | 0 |  |  | out
 | 68 |  | 2f4f0 | f4_1 | f0_1 |  | 0 | 0 | 0 | 1 | 0 | 0 | 1 | 0 | 1 | 0 | x | x | x | 0 | 0 | 0 | 0 | 1 | 0 | x | x | 0 | 0 | 0 | 0 | 0 |  | out | in
 | 69 |  | 2f3f1 | f3_0 | f1_0 |  | 0 | 0 | 0 | 0 | 0 | 0 | 0 | 0 | 1 | 0 | x | x | x | 0 | 1 | 0 | 1 | 0 | 0 | x | x | 0 | 0 | 0 | 0 | 0 |  | out
 | 70 |  | 2f3f1 | f3_1 | f1_1 |  | 0 | 0 | 0 | 0 | 0 | 0 | 0 | 0 | 1 | 0 | x | x | x | 1 | 0 | 0 | 1 | 0 | 0 | x | x | 0 | 0 | 0 | 0 | 0 |  | out
 | 71 |  | 2f3f1 | f3_1 | f1_1 |  | 0 | 0 | 0 | 1 | 0 | 0 | 1 | 0 | 1 | 0 | x | x | x | 0 | 0 | 0 | 0 | 1 | 0 | x | x | 0 | 0 | 0 | 0 | 0 |  | out
 | 72 |  | f2^2 | f2_0 | f2_1 | f4_1 | 0 | 1 | 1 | 0 | 0 | 0 | 0 | 0 | 1 | 0 | x | x | x | 0 | 0 | 0 | 0 | 1 | 0 | 1 | 0 | 0 | 0 | 0 | 0 | 0 |  | out |  |  |  | out
 | 73 |  | f2^2 | f2_0 | f2_1 | f4_0 | 0 | 1 | 1 | 0 | 1 | 1 | 0 | 0 | 0 | 1 | x | x | x | 0 | 1 | 0 | x | x | x | 0 | 1 | 0 | 0 | x | x | 0 |  | out
 | 74 | f5^2 | 2f5f0 | f5_0 | f0_0 |  | 0 | 0 | 0 | 0 | 0 | 0 | 0 | 0 | 1 | 0 | x | x | x | 0 | 0 | 1 | 0 | 0 | 1 | x | x | 0 | 0 | 0 | 0 | 0 |  | out |  |  |  | in
 | 75 |  | 2f5f0 | f5_1 | f0_1 |  | 0 | 0 | 0 | 0 | 0 | 0 | 0 | 0 | 1 | 0 | x | x | x | 1 | 0 | 0 | 0 | 1 | 0 | x | x | 0 | 0 | 0 | 0 | 0 |  |  | out
 | 76 |  | 2f5f0 | f5_1 | f0_1 |  | 0 | 0 | 0 | 1 | 0 | 0 | 1 | 0 | 1 | 0 | x | x | x | 0 | 0 | 0 | 0 | 1 | 1 | x | x | 0 | 0 | 0 | 0 | 0
 | 77 |  | 2f4f1 | f4_0 | f1_0 |  | 0 | 0 | 0 | 0 | 0 | 0 | 0 | 0 | 1 | 0 | x | x | x | 0 | 1 | 0 | 1 | 0 | 0 | x | x | 0 | 0 | 0 | 0 | 0 |  | out
 | 78 |  | 2f4f1 | f4_1 | f1_1 |  | 0 | 0 | 0 | 0 | 0 | 0 | 0 | 0 | 1 | 0 | x | x | x | 1 | 0 | 0 | 1 | 0 | 0 | x | x | 0 | 0 | 0 | 0 | 0 |  | out | in
 | 79 |  | 2f4f1 | f4_1 | f1_1 |  | 0 | 0 | 0 | 1 | 0 | 0 | 1 | 0 | 1 | 0 | x | x | x | 0 | 0 | 0 | 0 | 1 | 0 | x | x | 0 | 0 | 0 | 0 | 0 |  | out
 | 80 |  | 2f3f2 | f3_0 | f2_0 |  | 0 | 0 | 0 | 0 | 0 | 0 | 0 | 0 | 1 | 0 | x | x | x | 0 | 1 | 0 | 1 | 0 | 0 | x | x | 0 | 0 | 0 | 0 | 0 |  | out
 | 81 |  | 2f3f2 | f3_1 | f2_1 | f5_0 | 0 | 1 | 1 | 0 | 0 | 0 | 0 | 0 | 1 | 0 | x | x | x | 1 | 0 | 0 | 1 | 0 | 0 | 0 | 1 | 0 | 0 | 0 | 0 | 0 |  | out
 | 82 |  | 2f3f2 | f3_1 | f2_1 | f5_1 | 0 | 1 | 1 | 1 | 0 | 0 | 1 | 0 | 1 | 0 | x | x | x | 0 | 0 | 0 | 0 | 1 | 0 | 1 | 0 | 0 | 0 | 0 | 0 | 0 |  |  |  |  |  | out
x | 83 |  | A^2 | A_0 | A_1 |  | 0 | 0 | 0 | 0 | 0 | 0 | 0 | 0 | 1 | 0 | x | x | x | 0 | 0 | 0 | 0 | 0 | 1 | x | x | 0 | 0 | 0 | 0 | 0 |  |  | out |  |  | in
x | 84 |  | A^2 | A_0 | A_1 |  | 0 | 0 | 0 | 0 | 1 | 1 | 0 | 0 | 0 | 1 | x | x | x | 0 | 0 | 1 | 0 | 0 | 0 | x | x | 0 | 0 | 0 | 0 | 0 |  | out
x | 85 |  | 6AB | A_0 | B_0 |  | 0 | 0 | 0 | 0 | 0 | 0 | 0 | 1 | 1 | 0 | x | x | x | 0 | 1 | 0 | 1 | 0 | 0 | x | x | 0 | 0 | 0 | 0 | 0
x | 86 |  | 6AB | A_1 | B_1 |  | 0 | 0 | 0 | 0 | 0 | 0 | 0 | 1 | 1 | 0 | x | x | x | 1 | 0 | 0 | 1 | 0 | 0 | x | x | 0 | 0 | 0 | 0 | 0
x | 87 |  | 6AB | A_1 | B_1 |  | 0 | 0 | 0 | 1 | 0 | 0 | 1 | 1 | 1 | 0 | x | x | x | 0 | 0 | 0 | 0 | 1 | 0 | x | x | 0 | 0 | 0 | 0 | 0 |  | out
x | 88 |  | 3B^2 | B_0 | B_1 | y3_1=y1_1 | 0 | 1 | 1 | 0 | 0 | 0 | 0 | 1 | 1 | 0 | x | x | x | 0 | 0 | 0 | 1 | 0 | 0 | 1 | 0 | 0 | 0 | 0 | 0 | 0 |  |  |  |  |  | out
x | 89 |  | 3B^2 | B_0 | B_1 | y3_0=y1_0 | 0 | 1 | 1 | 0 | 1 | 1 | 0 | 0 | 1 | 1 | x | x | x | 1 | 0 | 0 | 0 | 0 | 0 | 0 | 1 | 0 | 0 | 0 | 0 | 0
x | 90 |  | y1-yqz1 | yq_0 | z1_0 |  | 0 | 0 | 0 | 0 | 0 | 0 | 0 | 0 | 0 | 1 | x | x | x | 1 | 0 | 0 | 0 | 1 | 0 | X | X | 0 | 0 | 0 | 0 | 0 |  | out
x | 91 |  | y1-yqz1 | yq_1 | z1_1 | A_0 | 0 | 1 | 1 | 0 | 0 | 0 | 0 | 0 | 0 | 1 | X | X | X | 0 | 1 | 0 | 0 | 1 | 0 | 0 | 1 | 0 | 0 | 0 | 0 | 0 |  | out
x | 92 |  | y1-yqz1 | yq_1 | z1_1 | A_1 | 0 | 1 | 1 | 1 | 0 | 0 | 1 | 0 | 0 | 1 | x | x | x | x | x | x | 1 | 0 | 0 | 1 | 0 | 0 | 0 | 0 | 0 | 0 |  | out |  |  |  | out
 | 93 |  | (A-3B)C | (A-3B)_0 | C_0 | - | 0 | 0 | 0 | 0 | 0 | 0 | 0 | 0 | 0 | 1 | x | x | x | 0 | 0 | 1 | 0 | 0 | 1 | x | x | 1 | 0 | 1 | 0 | 0 |  | out |  |  | in |  |  | in
 | 94 |  | (A-3B)C | (A-3B)_1 | C_1 | x3_0=x1_0 | 0 | 1 | 1 | 0 | 0 | 0 | 0 | 0 | 0 | 1 | x | x | x | 1 | 0 | 0 | 0 | 1 | 0 | 0 | 1 | 1 | 0 | 1 | 0 | 0 |  |  | out |  | out
 | 95 |  | (A-3B)C | (A-3B)_1 | C_1 | x3_1=x1_1 | 0 | 1 | 1 | 1 | 0 | 0 | 1 | 0 | 0 | 1 | x | x | x | 0 | 0 | 0 | 0 | 1 | 1 | 1 | 0 | 1 | 0 | 1 | 0 | 0 |  |  |  |  |  |  |  | out
 | 96 |  | x1-xqz1 | xq_0 | z1_0 |  | 0 | 0 | 0 | 0 | 0 | 0 | 0 | 0 | 0 | 1 | x | x | x | 1 | 0 | 0 | 0 | 1 | 0 | X | X | 1 | 0 | 1 | 0 | 0 |  | out | in
 | 97 |  | x1-xqz1 | xq_1 | z1_1 | B_0 | 0 | 1 | 1 | 0 | 0 | 0 | 0 | 0 | 0 | 1 | X | X | X | 0 | 1 | 0 | 0 | 1 | 0 | 0 | 1 | 1 | 0 | 1 | 0 | 0 |  | out |  |  | out
 | 98 |  | x1-xqz1 | xq_1 | z1_1 | B_1 | 0 | 1 | 1 | 1 | 0 | 0 | 1 | 0 | 0 | 1 | x | x | x | x | x | x | 1 | 0 | 0 | 1 | 0 | 1 | 0 | 1 | 0 | 0 |  | out |  |  |  |  |  | out
 | 99 |  | f3l3(1+i) | f3_0 | l3_0 |  | 0 | 0 | 0 | 0 | 0 | 0 | 0 | 0 | 1 | 0 | x | x | x | 0 | 0 | 1 | x | x | x | x | x | 0 | 0 | 0 | 0 | 0 |  | out
 | 100 |  | f3l3(1+i) | f3_1 | l3_1 |  | 0 | 0 | 0 | 0 | 0 | 0 | 0 | 0 | 1 | 0 | x | x | x | 0 | 0 | 0 | 0 | 0 | 1 | x | x | 0 | 0 | 0 | 0 | 0 |  |  | out |  |  | in
 | 101 |  | f3l3(1+i) | f3_1 | l3_1 |  | 0 | 0 | 0 | 1 | 0 | 0 | 1 | 0 | 0 | 1 | x | x | x | 1 | 0 | 0 | 0 | 1 | 1 | x | x | 0 | 0 | 0 | 0 | 0
 | 102 |  | f5l1(1+i) | f5_0 | l1_0 |  | 0 | 0 | 0 | 0 | 0 | 0 | 0 | 0 | 1 | 0 | x | x | x | 0 | 1 | 0 | 0 | 0 | 0 | x | x | 0 | 0 | 0 | 0 | 0 |  | out | in
 | 103 |  | f5l1(1+i) | f5_1 | l1_1 |  | 0 | 0 | 0 | 0 | 0 | 0 | 0 | 0 | 1 | 0 | x | x | x | 0 | 0 | 0 | 1 | 0 | 0 | x | x | 0 | 0 | 0 | 0 | 0 |  | out
 | 104 |  | f5l1(1+i) | f5_1 | l1_1 |  | 0 | 0 | 0 | 1 | 0 | 0 | 1 | 0 | 0 | 1 | x | x | x | 1 | 0 | 0 | 0 | 1 | 0 | x | x | 0 | 0 | 0 | 0 | 0 |  | out
 | 105 |  | f0l0 | f0_0 | l0_0 |  | 0 | 0 | 0 | 0 | 0 | 0 | 0 | 0 | 0 | 1 | x | x | x | 0 | 1 | 0 | 1 | 0 | 0 | x | x | 0 | 0 | 0 | 0 | 0 |  | out
 | 106 |  | f0l0 | f0_1 | l0_1 | f0_0 | 0 | 0 | 1 | 0 | 0 | 0 | 0 | 0 | 0 | 1 | x | x | x | 1 | 0 | 0 | 1 | 0 | 0 | 0 | 1 | 0 | 0 | 0 | 0 | 0 |  | out
 | 107 |  | f0l0 | f0_1 | l0_1 | f0_1 | 0 | 0 | 1 | 1 | 0 | 0 | 1 | 0 | 0 | 1 | x | x | x | 0 | 0 | 0 | 0 | 1 | 0 | 1 | 0 | 0 | 0 | 0 | 0 | 0 |  | out |  |  |  | out
 | 108 |  | f4l3(1+i) | f4_0 | l3_0 |  | 0 | 0 | 0 | 0 | 0 | 0 | 0 | 0 | 1 | 0 | x | x | x | 0 | 0 | 1 | x | x | x | x | x | 0 | 0 | 0 | 0 | 0 |  | out
 | 109 |  | f4l3(1+i) | f4_1 | l3_1 |  | 0 | 0 | 0 | 0 | 0 | 0 | 0 | 0 | 1 | 0 | x | x | x | 0 | 0 | 0 | 0 | 0 | 1 | x | x | 0 | 0 | 0 | 0 | 0 |  |  | out |  |  | in
 | 110 |  | f4l3(1+i) | f4_1 | l3_1 |  | 0 | 0 | 0 | 1 | 0 | 0 | 1 | 0 | 0 | 1 | x | x | x | 1 | 0 | 0 | 0 | 1 | 1 | x | x | 0 | 0 | 0 | 0 | 0
 | 111 |  | f0l1 | f0_0 | l1_0 |  | 0 | 0 | 0 | 0 | 0 | 0 | 0 | 0 | 0 | 1 | x | x | x | 0 | 1 | 0 | 1 | 0 | 0 | x | x | 0 | 0 | 0 | 0 | 0 |  | out | in
 | 112 |  | f0l1 | f0_1 | l1_1 |  | 0 | 0 | 0 | 0 | 0 | 0 | 0 | 0 | 0 | 1 | x | x | x | 1 | 0 | 0 | 1 | 0 | 0 | x | x | 0 | 0 | 0 | 0 | 0 |  | out
 | 113 |  | f0l1 | f0_1 | l1_1 |  | 0 | 0 | 0 | 1 | 0 | 0 | 1 | 0 | 0 | 1 | x | x | x | 0 | 0 | 0 | 0 | 1 | 0 | x | x | 0 | 0 | 0 | 0 | 0 |  | out
 | 114 |  | f1l0 | f1_0 | l0_0 |  | 0 | 0 | 0 | 0 | 0 | 0 | 0 | 0 | 0 | 1 | x | x | x | 0 | 1 | 0 | 1 | 0 | 0 | x | x | 0 | 0 | 0 | 0 | 0 |  | out
 | 115 |  | f1l0 | f1_1 | l0_1 | f1_0 | 0 | 0 | 1 | 0 | 0 | 0 | 0 | 0 | 0 | 1 | x | x | x | 1 | 0 | 0 | 1 | 0 | 0 | 0 | 1 | 0 | 0 | 0 | 0 | 0 |  | out
 | 116 |  | f1l0 | f1_1 | l0_1 | f1_1 | 0 | 0 | 1 | 1 | 0 | 0 | 1 | 0 | 0 | 1 | x | x | x | 0 | 0 | 0 | 0 | 1 | 0 | 1 | 0 | 0 | 0 | 0 | 0 | 0 |  | out |  |  |  | out
 | 117 |  | f5l3(1+i) | f5_0 | l3_0 |  | 0 | 0 | 0 | 0 | 0 | 0 | 0 | 0 | 1 | 0 | x | x | x | 0 | 0 | 1 | x | x | x | x | x | 0 | 0 | 0 | 0 | 0 |  | out
 | 118 |  | f5l3(1+i) | f5_1 | l3_1 |  | 0 | 0 | 0 | 0 | 0 | 0 | 0 | 0 | 1 | 0 | x | x | x | 0 | 0 | 0 | 0 | 0 | 1 | x | x | 0 | 0 | 0 | 0 | 0 |  |  | out |  |  | in
 | 119 |  | f5l3(1+i) | f5_1 | l3_1 |  | 0 | 0 | 0 | 1 | 0 | 0 | 1 | 0 | 0 | 1 | x | x | x | 1 | 0 | 0 | 0 | 1 | 1 | x | x | 0 | 0 | 0 | 0 | 0
 | 120 |  | f1l1 | f1_0 | l1_0 |  | 0 | 0 | 0 | 0 | 0 | 0 | 0 | 0 | 0 | 1 | x | x | x | 0 | 1 | 0 | 1 | 0 | 0 | x | x | 0 | 0 | 0 | 0 | 0 |  | out | in
 | 121 |  | f1l1 | f1_1 | l1_1 |  | 0 | 0 | 0 | 0 | 0 | 0 | 0 | 0 | 0 | 1 | x | x | x | 1 | 0 | 0 | 1 | 0 | 0 | x | x | 0 | 0 | 0 | 0 | 0 |  | out
 | 122 |  | f1l1 | f1_1 | l1_1 |  | 0 | 0 | 0 | 1 | 0 | 0 | 1 | 0 | 0 | 1 | x | x | x | 0 | 0 | 0 | 0 | 1 | 0 | x | x | 0 | 0 | 0 | 0 | 0 |  | out
 | 123 |  | f2l0 | f2_0 | l0_0 |  | 0 | 0 | 0 | 0 | 0 | 0 | 0 | 0 | 0 | 1 | x | x | x | 0 | 1 | 0 | 1 | 0 | 0 | x | x | 0 | 0 | 0 | 0 | 0 |  | out
 | 124 |  | f2l0 | f2_1 | l0_1 | f2_0 | 0 | 0 | 1 | 0 | 0 | 0 | 0 | 0 | 0 | 1 | x | x | x | 1 | 0 | 0 | 1 | 0 | 0 | 0 | 1 | 0 | 0 | 0 | 0 | 0 |  | out
 | 125 |  | f2l0 | f2_1 | l0_1 | f2_1 | 0 | 0 | 1 | 1 | 0 | 0 | 1 | 0 | 0 | 1 | x | x | x | 0 | 0 | 0 | 0 | 1 | 0 | 1 | 0 | 0 | 0 | 0 | 0 | 0 |  | out |  |  |  | out
 | 126 |  | f0l3 | f0_0 | l3_0 |  | 0 | 0 | 0 | 0 | 0 | 0 | 0 | 0 | 0 | 1 | x | x | x | 0 | 0 | 1 | 0 | 0 | 1 | x | x | 0 | 0 | 0 | 0 | 0 |  | out |  |  |  | in
 | 127 |  | f0l3 | f0_1 | l3_1 |  | 0 | 0 | 0 | 0 | 0 | 0 | 0 | 0 | 0 | 1 | x | x | x | 1 | 0 | 0 | 0 | 1 | 0 | x | x | 0 | 0 | 0 | 0 | 0 |  |  | out
 | 128 |  | f0l3 | f0_1 | l3_1 |  | 0 | 0 | 0 | 1 | 0 | 0 | 1 | 0 | 0 | 1 | x | x | x | 0 | 0 | 0 | 0 | 1 | 1 | x | x | 0 | 0 | 0 | 0 | 0
 | 129 |  | f2l1 | f2_0 | l1_0 |  | 0 | 0 | 0 | 0 | 0 | 0 | 0 | 0 | 0 | 1 | x | x | x | 0 | 1 | 0 | 1 | 0 | 0 | x | x | 0 | 0 | 0 | 0 | 0 |  | in
 | 130 |  | f2l1 | f2_1 | l1_1 |  | 0 | 0 | 0 | 0 | 0 | 0 | 0 | 0 | 0 | 1 | x | x | x | 1 | 0 | 0 | 1 | 0 | 0 | x | x | 0 | 0 | 0 | 0 | 0 |  | in
 | 131 |  | f2l1 | f2_1 | l1_1 |  | 0 | 0 | 0 | 1 | 0 | 0 | 1 | 0 | 0 | 1 | x | x | x | 0 | 0 | 0 | 0 | 1 | 0 | x | x | 0 | 0 | 0 | 0 | 0 |  | in
 | 132 |  | f3l0 | f3_0 | l3_0 |  | 0 | 0 | 0 | 0 | 0 | 0 | 0 | 0 | 0 | 1 | x | x | x | 0 | 1 | 0 | 1 | 0 | 0 | x | x | 0 | 0 | 0 | 0 | 0 |  | in
 | 133 |  | f3l0 | f3_1 | l3_1 | f3_0 | 0 | 0 | 1 | 0 | 0 | 0 | 0 | 0 | 0 | 1 | x | x | x | 1 | 0 | 0 | 1 | 0 | 0 | 0 | 1 | 0 | 0 | 0 | 0 | 0 |  | out | in
 | 134 |  | f3l0 | f3_1 | l3_1 | f3_1 | 0 | 0 | 1 | 1 | 0 | 0 | 1 | 0 | 0 | 1 | x | x | x | 0 | 0 | 0 | 0 | 1 | 0 | 1 | 0 | 0 | 0 | 0 | 0 | 0 |  | out |  |  |  | out
 | 135 |  | A^2 | A_0 | A_1 | C_1 | 0 | 1 | 1 | 0 | 0 | 0 | 0 | 0 | 1 | 0 | 0 | 0 | 1 | x | x | x | x | x | x | 0 | 0 | x | x | x | x | 0 |  | out
 | 136 |  | A^2 | A_0 | A_1 | C_0 | 0 | 1 | 1 | 0 | 1 | 1 | 0 | 0 | 0 | 1 | 0 | 0 | 1 | x | x | x | x | x | x | 0 | 0 | x | x | x | x | 0 |  | out
 | 137 |  | B^2 | B_0 | B_1 | D_1 | 0 | 1 | 1 | 0 | 0 | 0 | 0 | 0 | 1 | 0 | 0 | 0 | 1 | x | x | x | x | x | x | 0 | 0 | x | x | x | x | 0 |  | out
 | 138 |  | B^2 | B_0 | B_1 | D_0 | 0 | 1 | 1 | 0 | 1 | 1 | 0 | 0 | 0 | 1 | 0 | 0 | 1 | x | x | x | x | x | x | 0 | 0 | x | x | x | x | 0 |  | out
 | 139 |  | f1l3 | f1_0 | l3_0 |  | 0 | 0 | 0 | 0 | 0 | 0 | 0 | 0 | 0 | 1 | x | x | x | 0 | 0 | 1 | 0 | 0 | 1 | x | x | 0 | 0 | 0 | 0 | 0 |  | out |  |  |  | in
 | 140 |  | f1l3 | f1_1 | l3_1 |  | 0 | 0 | 0 | 0 | 0 | 0 | 0 | 0 | 0 | 1 | x | x | x | 1 | 0 | 0 | 0 | 1 | 0 | x | x | 0 | 0 | 0 | 0 | 0 |  |  | out
 | 141 |  | f1l3 | f1_1 | l3_1 |  | 0 | 0 | 0 | 1 | 0 | 0 | 1 | 0 | 0 | 1 | x | x | x | 0 | 0 | 0 | 0 | 1 | 1 | x | x | 0 | 0 | 0 | 0 | 0
 | 142 |  | f3l1 | f3_0 | l1_0 |  | 0 | 0 | 0 | 0 | 0 | 0 | 0 | 0 | 0 | 1 | x | x | x | 0 | 1 | 0 | 1 | 0 | 0 | x | x | 0 | 0 | 0 | 0 | 0 |  | out | in
 | 143 |  | f3l1 | f3_1 | l1_1 |  | 0 | 0 | 0 | 0 | 0 | 0 | 0 | 0 | 0 | 1 | x | x | x | 1 | 0 | 0 | 1 | 0 | 0 | x | x | 0 | 0 | 0 | 0 | 0 |  | out
 | 144 |  | f3l1 | f3_1 | l1_1 |  | 0 | 0 | 0 | 1 | 0 | 0 | 1 | 0 | 0 | 1 | x | x | x | 0 | 0 | 0 | 0 | 1 | 0 | x | x | 0 | 0 | 0 | 0 | 0 |  | out
 | 145 |  | f4l0 | f4_0 | l0_0 |  | 0 | 0 | 0 | 0 | 0 | 0 | 0 | 0 | 0 | 1 | x | x | x | 0 | 1 | 0 | 1 | 0 | 0 | x | x | 0 | 0 | 0 | 0 | 0 |  | out
 | 146 |  | f4l0 | f4_1 | l0_1 | f4_0 | 0 | 0 | 1 | 0 | 0 | 0 | 0 | 0 | 0 | 1 | x | x | x | 1 | 0 | 0 | 1 | 0 | 0 | 0 | 1 | 0 | 0 | 0 | 0 | 0 |  |  | out
 | 147 |  | f4l0 | f4_1 | l0_1 | f4_1 | 0 | 0 | 1 | 1 | 0 | 0 | 1 | 0 | 0 | 1 | x | x | x | 0 | 0 | 0 | 0 | 1 | 0 | 1 | 0 | 0 | 0 | 0 | 0 | 0 |  |  |  |  |  | out
 | 148 |  | yqB | yq_0 | B_0 |  | 0 | 0 | 0 | 0 | 0 | 0 | 0 | 0 | 0 | 1 | x | x | x | 0 | 0 | 1 | 0 | 0 | 1 | x | x | 0 | 0 | 0 | 0 | 0 |  | in |  |  |  | in
 | 149 |  | yqB | yq_1 | B_1 | acc2 | 0 | 0 | 0 | 0 | 0 | 0 | 0 | 0 | 0 | 1 | x | x | x | 1 | 0 | 0 | 0 | 1 | 0 | x | x | 0 | 0 | 0 | 0 | 0 |  | in
 | 150 |  | yqB | yq_1 | B_1 | acc3 | 0 | 0 | 0 | 1 | 0 | 0 | 1 | 0 | 0 | 1 | x | x | x | 0 | 0 | 0 | 0 | 1 | 1 | x | x | 0 | 0 | 0 | 0 | 0 |  | out | in
 | 151 |  | xqA | xq_0 | A_0 |  | 0 | 0 | 0 | 0 | 0 | 0 | 0 | 0 | 0 | 1 | x | x | x | 1 | 0 | 0 | 0 | 1 | 0 | x | x | 0 | 0 | 0 | 0 | 0 |  | in | out
 | 152 |  | xqA | xq_1 | A_1 | l3_0 | 0 | 1 | 0 | 0 | 0 | 0 | 0 | 0 | 0 | 1 | x | x | x | 0 | 1 | 0 | 0 | 1 | 0 | 0 | 1 | 0 | 0 | 0 | 0 | 0 |  | out | in
 | 153 |  | xqA | xq_1 | A_1 | l3_1 | 0 | 1 | 0 | 1 | 0 | 0 | 1 | 0 | 0 | 1 | x | x | x | 0 | 0 | 0 | 1 | 0 | 0 | 1 | 0 | 0 | 0 | 0 | 0 | 0 |  | out |  |  |  | out
 | 154 |  | xpA | xp | A_0 | l1_0 | 0 | 1 | 0 | 0 | 0 | 0 | 0 | 0 | 0 | 1 | 0 | 0 | 1 | x | x | x | x | x | x | 0 | 0 | 0 | 0 | 0 | 0 | 0 |  | out
 | 155 |  | xpA | xp | A_1 | l1_1 | 0 | 1 | 0 | 0 | 0 | 0 | 0 | 0 | 0 | 1 | 0 | 0 | 1 | x | x | x | x | x | x | 0 | 0 | 0 | 0 | 0 | 0 | 0 |  | out
 | 156 |  | yp~B | yp | B_0 | l0_0 | 0 | 0 | 0 | 0 | 0 | 0 | 0 | 0 | 0 | 1 | 0 | 0 | 0 | 0 | 0 | 1 | x | x | x | 0 | 0 | 0 | 0 | 0 | 0 | 0 |  | out
 | 157 |  | yp~B | yp | B_1 | l0_1 | 0 | 1 | 0 | 0 | 0 | 0 | 0 | 0 | 0 | 1 | 0 | 0 | 1 | 1 | 0 | 1 | x | x | x | 0 | 1 | 0 | 0 | 0 | 0 | 0 |  | out
 | 158 |  | f2l3 | f2_0 | l3_0 |  | 0 | 1 | 0 | 0 | 0 | 0 | 0 | 0 | 0 | 1 | 1 | 0 | 1 | 0 | 0 | 1 | 0 | 0 | 1 | 0 | 0 | 0 | 0 | 0 | 0 | 0 |  | out |  |  |  | in
 | 159 |  | f2l3 | f2_1 | l3_1 |  | 0 | 0 | 0 | 0 | 0 | 0 | 0 | 0 | 0 | 1 | x | x | x | 1 | 0 | 0 | 0 | 1 | 0 | x | x | 0 | 0 | 0 | 0 | 0 |  |  | out
 | 160 |  | f2l3 | f2_1 | l3_1 |  | 0 | 0 | 0 | 1 | 0 | 0 | 1 | 0 | 0 | 1 | x | x | x | 0 | 0 | 0 | 0 | 1 | 1 | x | x | 0 | 0 | 0 | 0 | 0
 | 161 |  | f4l1 | f4_0 | l1_0 |  | 0 | 0 | 0 | 0 | 0 | 0 | 0 | 0 | 0 | 1 | x | x | x | 0 | 1 | 0 | 1 | 0 | 0 | x | x | 0 | 0 | 0 | 0 | 0 |  | out | in
 | 162 |  | f4l1 | f4_1 | l1_1 |  | 0 | 0 | 0 | 0 | 0 | 0 | 0 | 0 | 0 | 1 | x | x | x | 1 | 0 | 0 | 1 | 0 | 0 | x | x | 0 | 0 | 0 | 0 | 0 |  |  | out
 | 163 |  | f4l1 | f4_1 | l1_1 |  | 0 | 0 | 0 | 1 | 0 | 0 | 1 | 0 | 0 | 1 | x | x | x | 0 | 0 | 0 | 0 | 1 | 0 | x | x | 0 | 0 | 0 | 0 | 0
 | 164 |  | f5l0 | f5_0 | l0_0 |  | 0 | 0 | 0 | 0 | 0 | 0 | 0 | 0 | 0 | 1 | x | x | x | 0 | 1 | 0 | 1 | 0 | 0 | x | x | 0 | 0 | 0 | 0 | 0 |  | out
 | 165 |  | f5l0 | f5_1 | l0_1 | f5_0 | 0 | 1 | 1 | 0 | 0 | 0 | 0 | 0 | 0 | 1 | x | x | x | 1 | 0 | 0 | 1 | 0 | 0 | 0 | 1 | 0 | 0 | 0 | 0 | 0 |  | out
 | 166 |  | f5l0 | f5_1 | l0_1 | f5_1 | 0 | 1 | 1 | 1 | 0 | 0 | 1 | 0 | 0 | 1 | x | x | x | 0 | 0 | 0 | 0 | 1 | 0 | 1 | 0 | 0 | 0 | 0 | 0 | 0 |  | out |  |  |  | out
 | 167 |  | BD | B_0 | D_0 |  | 0 | 0 | 0 | 0 | 0 | 0 | 0 | 0 | 0 | 1 | x | x | x | 0 | 0 | 1 | 0 | 0 | 1 | x | x | 0 | 0 | 0 | 0 | 0 |  | out |  |  |  | in
 | 168 |  | BD | B_1 | D_1 | E_0 | 0 | 1 | 1 | 0 | 0 | 0 | 0 | 0 | 0 | 1 | x | x | x | 1 | 0 | 0 | 0 | 1 | 0 | 0 | 1 | 0 | 0 | 0 | 0 | 0 |  |  | out
 | 169 |  | BD | B_1 | D_1 | E_1 | 0 | 1 | 1 | 1 | 0 | 0 | 1 | 0 | 0 | 1 | x | x | x | 0 | 0 | 0 | 0 | 1 | 1 | 1 | 0 | 0 | 0 | 0 | 0 | 0 |  |  |  |  |  | out
 | 170 |  | z1C | z1_0 | C_0 |  | 0 | 0 | 0 | 0 | 0 | 0 | 0 | 0 | 0 | 1 | x | x | x | 0 | 1 | 0 | 1 | 0 | 0 | x | x | 0 | 0 | 0 | 0 | 0 |  | out
 | 171 |  | z1C | z1_1 | C_1 |  | 0 | 0 | 0 | 0 | 0 | 0 | 0 | 0 | 0 | 1 | x | x | x | 1 | 0 | 0 | 1 | 0 | 0 | x | x | 0 | 0 | 0 | 0 | 0 |  |  | out
 | 172 |  | z1C | z1_1 | C_1 |  | 0 | 0 | 0 | 1 | 0 | 0 | 1 | 0 | 0 | 1 | x | x | x | 0 | 0 | 0 | 0 | 1 | 0 | x | x | 0 | 0 | 0 | 0 | 0
 | 173 |  | 2x1D | x1_0 | D_0 |  | 0 | 0 | 0 | 0 | 0 | 0 | 0 | 0 | 1 | 0 | x | x | x | 1 | 0 | 0 | 0 | 1 | 0 | x | x | 0 | 0 | 0 | 0 | 0 |  | out | in
 | 174 |  | 2x1D | x1_1 | D_1 | C_0 | 0 | 1 | 1 | 0 | 0 | 0 | 0 | 0 | 1 | 0 | x | x | x | 0 | 1 | 0 | 0 | 1 | 0 | 0 | 1 | 0 | 0 | 0 | 0 | 0 |  | out
 | 175 |  | 2x1D | x1_1 | D_1 | C_1 | 0 | 1 | 1 | 1 | 0 | 0 | 1 | 0 | 1 | 0 | x | x | x | 0 | 0 | 0 | 1 | 0 | 0 | 1 | 0 | 0 | 0 | 0 | 0 | 0 |  | out |  |  |  | out
 | 176 |  | x1D | x1_0 | D_0 |  | 0 | 0 | 0 | 0 | 0 | 0 | 0 | 0 | 0 | 1 | x | x | x | 1 | 0 | 0 | 0 | 1 | 0 | x | x | 0 | 0 | 0 | 0 | 0 |  | out
 | 177 |  | x1D | x1_1 | D_1 | D_0 | 0 | 1 | 1 | 0 | 0 | 0 | 0 | 0 | 0 | 1 | x | x | x | 0 | 1 | 0 | 0 | 1 | 0 | 0 | 1 | 0 | 0 | 0 | 0 | 0 |  | out
 | 178 |  | x1D | x1_1 | D_1 | D_1 | 0 | 1 | 1 | 1 | 0 | 0 | 1 | 0 | 0 | 1 | x | x | x | 0 | 0 | 0 | 1 | 0 | 0 | 1 | 0 | 0 | 0 | 0 | 0 | 0 |  | out |  |  |  | out
 | 179 |  | f3l3(1+i) | f3_0 | l3_0 |  | 0 | 0 | 0 | 0 | 0 | 0 | 0 | 0 | 1 | 0 | x | x | x | 0 | 0 | 1 | x | x | x | x | x | 0 | 0 | 0 | 0 | 0 |  | out
 | 180 |  | f3l3(1+i) | f3_1 | l3_1 |  | 0 | 0 | 0 | 0 | 0 | 0 | 0 | 0 | 1 | 0 | x | x | x | 0 | 0 | 0 | 0 | 0 | 1 | x | x | 0 | 0 | 0 | 0 | 0 |  | out |  |  |  | in
 | 181 |  | f3l3(1+i) | f3_1 | l3_1 |  | 0 | 0 | 0 | 1 | 0 | 0 | 1 | 0 | 0 | 1 | x | x | x | 1 | 0 | 0 | 0 | 1 | 1 | x | x | 0 | 0 | 0 | 0 | 0 |  |  | out
 | 182 |  | f0l0 | f0_0 | l0_0 |  | 0 | 0 | 0 | 0 | 0 | 0 | 0 | 0 | 0 | 1 | x | x | x | 0 | 1 | 0 | 1 | 0 | 0 | x | x | 0 | 0 | 0 | 0 | 0 |  |  | in
 | 183 |  | f0l0 | f0_1 | l0_1 |  | 0 | 0 | 0 | 0 | 0 | 0 | 0 | 0 | 0 | 1 | x | x | x | 1 | 0 | 0 | 1 | 0 | 0 | x | x | 0 | 0 | 0 | 0 | 0 |  | out
 | 184 |  | f0l0 | f0_1 | l0_1 |  | 0 | 0 | 0 | 1 | 0 | 0 | 1 | 0 | 0 | 1 | x | x | x | 0 | 0 | 0 | 0 | 1 | 0 | x | x | 0 | 0 | 0 | 0 | 0 |  | out
 | 185 |  | f5l1(1+i) | f5_0 | l1_0 |  | 0 | 0 | 0 | 0 | 0 | 0 | 0 | 0 | 1 | 0 | x | x | x | 0 | 1 | 0 | 0 | 0 | 0 | x | x | 0 | 0 | 0 | 0 | 0 |  | out
 | 186 |  | f5l1(1+i) | f5_1 | l1_1 |  | 0 | 0 | 0 | 0 | 0 | 0 | 0 | 0 | 1 | 0 | x | x | x | 0 | 0 | 0 | 1 | 0 | 0 | x | x | 0 | 0 | 0 | 0 | 0 |  | out
 | 187 |  | f5l1(1+i) | f5_1 | l1_1 | f0_0 | 0 | 1 | 1 | 1 | 0 | 0 | 1 | 0 | 0 | 1 | x | x | x | 1 | 0 | 0 | 0 | 1 | 0 | 0 | 1 | 0 | 0 | 0 | 0 | 0 |  | out
 | 188 |  | f4l3(1+i) | f4_0 | l3_0 | f0_1 | 0 | 1 | 1 | 0 | 0 | 0 | 0 | 0 | 1 | 0 | x | x | x | 0 | 0 | 1 | x | x | x | 1 | 0 | 0 | 0 | 0 | 0 | 0 |  | out |  |  |  | out
 | 189 |  | f4l3(1+i) | f4_1 | l3_1 |  | 0 | 0 | 0 | 0 | 0 | 0 | 0 | 0 | 1 | 0 | x | x | x | 0 | 0 | 0 | 0 | 0 | 1 | x | x | 0 | 0 | 0 | 0 | 0 |  |  | out |  |  | in
 | 190 |  | f4l3(1+i) | f4_1 | l3_1 |  | 0 | 0 | 0 | 1 | 0 | 0 | 1 | 0 | 0 | 1 | x | x | x | 1 | 0 | 0 | 0 | 1 | 1 | x | x | 0 | 0 | 0 | 0 | 0
 | 191 |  | f0l1 | f0_0 | l1_0 |  | 0 | 0 | 0 | 0 | 0 | 0 | 0 | 0 | 0 | 1 | x | x | x | 0 | 1 | 0 | 1 | 0 | 0 | x | x | 0 | 0 | 0 | 0 | 0 |  | out | in
 | 192 |  | f0l1 | f0_1 | l1_1 |  | 0 | 0 | 0 | 0 | 0 | 0 | 0 | 0 | 0 | 1 | x | x | x | 1 | 0 | 0 | 1 | 0 | 0 | x | x | 0 | 0 | 0 | 0 | 0 |  | out
 | 193 |  | f0l1 | f0_1 | l1_1 |  | 0 | 0 | 0 | 1 | 0 | 0 | 1 | 0 | 0 | 1 | x | x | x | 0 | 0 | 0 | 0 | 1 | 0 | x | x | 0 | 0 | 0 | 0 | 0 |  | out
 | 194 |  | f1l0 | f1_0 | l0_0 |  | 0 | 0 | 0 | 0 | 0 | 0 | 0 | 0 | 0 | 1 | x | x | x | 0 | 1 | 0 | 1 | 0 | 0 | x | x | 0 | 0 | 0 | 0 | 0 |  | out
 | 195 |  | f1l0 | f1_1 | l0_1 | f1_0 | 0 | 1 | 1 | 0 | 0 | 0 | 0 | 0 | 0 | 1 | x | x | x | 1 | 0 | 0 | 1 | 0 | 0 | 0 | 1 | 0 | 0 | 0 | 0 | 0 |  | out
 | 196 |  | f1l0 | f1_1 | l0_1 | f1_1 | 0 | 1 | 1 | 1 | 0 | 0 | 1 | 0 | 0 | 1 | x | x | x | 0 | 0 | 0 | 0 | 1 | 0 | 1 | 0 | 0 | 0 | 0 | 0 | 0 |  | out |  |  |  | out
 | 197 |  | f5l3(1+i) | f5_0 | l3_0 |  | 0 | 0 | 0 | 0 | 0 | 0 | 0 | 0 | 1 | 0 | x | x | x | 0 | 0 | 1 | x | x | x | x | x | 0 | 0 | 0 | 0 | 0 |  | out
 | 198 |  | f5l3(1+i) | f5_1 | l3_1 |  | 0 | 0 | 0 | 0 | 0 | 0 | 0 | 0 | 1 | 0 | x | x | x | 0 | 0 | 0 | 0 | 0 | 1 | x | x | 0 | 0 | 0 | 0 | 0 |  |  | out |  |  | in
 | 199 |  | f5l3(1+i) | f5_1 | l3_1 |  | 0 | 0 | 0 | 1 | 0 | 0 | 1 | 0 | 0 | 1 | x | x | x | 1 | 0 | 0 | 0 | 1 | 1 | x | x | 0 | 0 | 0 | 0 | 0
 | 200 |  | f1l1 | f1_0 | l1_0 |  | 0 | 0 | 0 | 0 | 0 | 0 | 0 | 0 | 0 | 1 | x | x | x | 0 | 1 | 0 | 1 | 0 | 0 | x | x | 0 | 0 | 0 | 0 | 0 |  | in | in
 | 201 |  | f1l1 | f1_1 | l1_1 |  | 0 | 0 | 0 | 0 | 0 | 0 | 0 | 0 | 0 | 1 | x | x | x | 1 | 0 | 0 | 1 | 0 | 0 | x | x | 0 | 0 | 0 | 0 | 0 |  | out
 | 202 |  | f1l1 | f1_1 | l1_1 |  | 0 | 0 | 0 | 1 | 0 | 0 | 1 | 0 | 0 | 1 | x | x | x | 0 | 0 | 0 | 0 | 1 | 0 | x | x | 0 | 0 | 0 | 0 | 0 |  |  | out
 | 203 |  | f2l0 | f2_0 | l0_0 |  | 0 | 0 | 0 | 0 | 0 | 0 | 0 | 0 | 0 | 1 | x | x | x | 0 | 1 | 0 | 1 | 0 | 0 | x | x | 0 | 0 | 0 | 0 | 0 |  | out | in
 | 204 |  | f2l0 | f2_1 | l0_1 | f2_0 | 0 | 1 | 1 | 0 | 0 | 0 | 0 | 0 | 0 | 1 | x | x | x | 1 | 0 | 0 | 1 | 0 | 0 | 0 | 1 | 0 | 0 | 0 | 0 | 0 |  | out
 | 205 |  | f2l0 | f2_1 | l0_1 | f2_1 | 0 | 1 | 1 | 1 | 0 | 0 | 1 | 0 | 0 | 1 | x | x | x | 0 | 0 | 0 | 0 | 1 | 0 | 1 | 0 | 0 | 0 | 0 | 0 | 0 |  | out |  |  |  | out
 | 206 |  | BC | B_0 | C_0 |  | 0 | 0 | 0 | 0 | 0 | 0 | 0 | 0 | 0 | 1 | 0 | 0 | 1 | 0 | 0 | 1 | x | x | x | 0 | 0 | 0 | 0 | x | x | 0 |  | out
 | 207 |  | BC | B_1 | C_1 | x3_0 | 0 | 1 | 1 | 0 | 0 | 0 | 0 | 0 | 0 | 1 | 1 | 0 | 0 | 0 | 1 | 0 | x | x | x | 0 | 0 | 0 | 0 | x | x | 0 |  |  | out
 | 208 |  | BC | B_1 | C_1 | x3_1 | 0 | 1 | 1 | 1 | 0 | 0 | 1 | 0 | 0 | 1 | x | x | x | 0 | 1 | 1 | x | x | x | 0 | 1 | 0 | 0 | x | x | 0
 | 209 |  | AD | A_0 | D_0 |  | 0 | 0 | 0 | 0 | 0 | 0 | 0 | 0 | 0 | 1 | x | x | x | 0 | 0 | 1 | 0 | 0 | 1 | x | x | 0 | 0 | 0 | 0 | 0 |  | in | in |  |  | in
 | 210 |  | AD | A_1 | D_1 |  | 0 | 0 | 0 | 0 | 0 | 0 | 0 | 0 | 0 | 1 | x | x | x | 0 | 1 | 1 | 0 | 1 | 0 | x | x | 0 | 0 | 0 | 0 | 0 |  | out
 | 211 |  | AD | A_1 | D_1 |  | 0 | 0 | 0 | 1 | 0 | 0 | 1 | 0 | 0 | 1 | x | x | x | 0 | 0 | 0 | 1 | 0 | 0 | x | x | 0 | 0 | 0 | 0 | 0 |  |  | out
 | 212 |  | y1E | y1_0 | E_0 |  | 0 | 0 | 0 | 0 | 0 | 0 | 0 | 0 | 0 | 1 | x | x | x | 1 | 0 | 0 | 0 | 1 | 0 | x | x | 0 | 0 | 0 | 0 | 0 |  | out | in
 | 213 |  | y1E | y1_1 | E_0 | y3_0 | 0 | 1 | 1 | 0 | 0 | 0 | 0 | 0 | 0 | 1 | x | x | x | 0 | 1 | 0 | 0 | 1 | 0 | 0 | 1 | 0 | 0 | 0 | 0 | 0 |  | out
 | 214 |  | y1E | y1_1 | E_1 | y3_1 | 0 | 1 | 1 | 1 | 0 | 0 | 1 | 0 | 0 | 1 | x | x | x | 0 | 0 | 0 | 1 | 0 | 0 | 1 | 0 | 0 | 0 | 0 | 0 | 0 |  | out |  |  |  | out
 | 215 |  | z1E | z1_0 | E_0 |  | 0 | 0 | 0 | 0 | 0 | 0 | 0 | 0 | 0 | 1 | 0 | 0 | 1 | 0 | 0 | 1 | x | x | x | 0 | 0 | 0 | 0 | x | x | 0 |  | out
 | 216 |  | z1E | z1_1 | E_1 | z3_0 | 0 | 1 | 1 | 0 | 0 | 0 | 0 | 0 | 0 | 1 | 1 | 0 | 0 | 0 | 1 | 0 | x | x | x | 0 | 0 | 0 | 0 | x | x | 0 |  | out
 | 217 |  | z1E | z1_1 | E_1 | z3_1 | 0 | 1 | 1 | 1 | 0 | 0 | 1 | 0 | 0 | 1 | x | x | x | 0 | 1 | 1 | x | x | x | 0 | 1 | 0 | 0 | x | x | 0 |  | out
 | 218 |  | f0l3 | f0_0 | l3_0 |  | 0 | 0 | 0 | 0 | 0 | 0 | 0 | 0 | 0 | 1 | x | x | x | 0 | 0 | 1 | 0 | 0 | 1 | x | x | 0 | 0 | 0 | 0 | 0 |  | out |  |  |  | in
 | 219 |  | f0l3 | f0_1 | l3_1 |  | 0 | 0 | 0 | 0 | 0 | 0 | 0 | 0 | 0 | 1 | x | x | x | 1 | 0 | 0 | 0 | 1 | 0 | x | x | 0 | 0 | 0 | 0 | 0 |  |  | out
 | 220 |  | f0l3 | f0_1 | l3_1 |  | 0 | 0 | 0 | 1 | 0 | 0 | 1 | 0 | 0 | 1 | x | x | x | 0 | 0 | 0 | 0 | 1 | 1 | x | x | 0 | 0 | 0 | 0 | 0
 | 221 |  | f2l1 | f2_0 | l1_0 |  | 0 | 0 | 0 | 0 | 0 | 0 | 0 | 0 | 0 | 1 | x | x | x | 0 | 1 | 0 | 1 | 0 | 0 | x | x | 0 | 0 | 0 | 0 | 0 |  | out | in
 | 222 |  | f2l1 | f2_1 | l1_1 |  | 0 | 0 | 0 | 0 | 0 | 0 | 0 | 0 | 0 | 1 | x | x | x | 1 | 0 | 0 | 1 | 0 | 0 | x | x | 0 | 0 | 0 | 0 | 0 |  | out
 | 223 |  | f2l1 | f2_1 | l1_1 |  | 0 | 0 | 0 | 1 | 0 | 0 | 1 | 0 | 0 | 1 | x | x | x | 0 | 0 | 0 | 0 | 1 | 0 | x | x | 0 | 0 | 0 | 0 | 0 |  | out
 | 224 |  | f3l0 | f3_0 | l3_0 |  | 0 | 0 | 0 | 0 | 0 | 0 | 0 | 0 | 0 | 1 | x | x | x | 0 | 1 | 0 | 1 | 0 | 0 | x | x | 0 | 0 | 0 | 0 | 0 |  | out
 | 225 |  | f3l0 | f3_1 | l3_1 | f3_0 | 0 | 1 | 1 | 0 | 0 | 0 | 0 | 0 | 0 | 1 | x | x | x | 1 | 0 | 0 | 1 | 0 | 0 | 0 | 1 | 0 | 0 | 0 | 0 | 0 |  | out
 | 226 |  | f3l0 | f3_1 | l3_1 | f3_1 | 0 | 1 | 1 | 1 | 0 | 0 | 1 | 0 | 0 | 1 | x | x | x | 0 | 0 | 0 | 0 | 1 | 0 | 1 | 0 | 0 | 0 | 0 | 0 | 0 |  | out |  |  |  | out
 | 227 |  | f1l3 | f1_0 | l3_0 |  | 0 | 0 | 0 | 0 | 0 | 0 | 0 | 0 | 0 | 1 | x | x | x | 0 | 0 | 1 | 0 | 0 | 1 | x | x | 0 | 0 | 0 | 0 | 0 |  | x0 |  |  |  | in
 | 228 |  | f1l3 | f1_1 | l3_1 |  | 0 | 0 | 0 | 0 | 0 | 0 | 0 | 0 | 0 | 1 | x | x | x | 1 | 0 | 0 | 0 | 1 | 0 | x | x | 0 | 0 | 0 | 0 | 0 |  | x1 | out
 | 229 |  | f1l3 | f1_1 | l3_1 |  | 0 | 0 | 0 | 1 | 0 | 0 | 1 | 0 | 0 | 1 | x | x | x | 0 | 0 | 0 | 0 | 1 | 1 | x | x | 0 | 0 | 0 | 0 | 0 |  | x1
 | 230 |  | f3l1 | f3_0 | l1_0 |  | 0 | 0 | 0 | 0 | 0 | 0 | 0 | 0 | 0 | 1 | x | x | x | 0 | 1 | 0 | 1 | 0 | 0 | x | x | 0 | 0 | 0 | 0 | 0 |  | x0 | in
 | 231 |  | f3l1 | f3_1 | l1_1 |  | 0 | 0 | 0 | 0 | 0 | 0 | 0 | 0 | 0 | 1 | x | x | x | 1 | 0 | 0 | 1 | 0 | 0 | x | x | 0 | 0 | 0 | 0 | 0
 | 232 |  | f3l1 | f3_1 | l1_1 |  | 0 | 0 | 0 | 1 | 0 | 0 | 1 | 0 | 0 | 1 | x | x | x | 0 | 0 | 0 | 0 | 1 | 0 | x | x | 0 | 0 | 0 | 0 | 0
 | 233 |  | f4l0 | f4_0 | l0_0 |  | 0 | 0 | 0 | 0 | 0 | 0 | 0 | 0 | 0 | 1 | x | x | x | 0 | 1 | 0 | 1 | 0 | 0 | x | x | 0 | 0 | 0 | 0 | 0
 | 234 |  | f4l0 | f4_1 | l0_1 | f4_0 | 0 | 1 | 1 | 0 | 0 | 0 | 0 | 0 | 0 | 1 | x | x | x | 1 | 0 | 0 | 1 | 0 | 0 | 0 | 1 | 0 | 0 | 0 | 0 | 0
 | 235 |  | f4l0 | f4_1 | l0_1 | f4_1 | 0 | 1 | 1 | 1 | 0 | 0 | 1 | 0 | 0 | 1 | x | x | x | 0 | 0 | 0 | 0 | 1 | 0 | 1 | 0 | 0 | 0 | 0 | 0 | 0 |  |  |  |  |  | out
 | 236 |  | f2l3 | f2_0 | l3_0 |  | 0 | 0 | 0 | 0 | 0 | 0 | 0 | 0 | 0 | 1 | x | x | x | 0 | 0 | 1 | 0 | 0 | 1 | x | x | 0 | 0 | 0 | 0 | 0 |  |  |  |  |  | in
 | 237 |  | f2l3 | f2_1 | l3_1 |  | 0 | 0 | 0 | 0 | 0 | 0 | 0 | 0 | 0 | 1 | x | x | x | 1 | 0 | 0 | 0 | 1 | 0 | x | x | 0 | 0 | 0 | 0 | 0 |  |  | out
 | 238 |  | f2l3 | f2_1 | l3_1 |  | 0 | 0 | 0 | 1 | 0 | 0 | 1 | 0 | 0 | 1 | x | x | x | 0 | 0 | 0 | 0 | 1 | 1 | x | x | 0 | 0 | 0 | 0 | 0
 | 239 |  | f4l1 | f4_0 | l1_0 |  | 0 | 0 | 0 | 0 | 0 | 0 | 0 | 0 | 0 | 1 | x | x | x | 0 | 1 | 0 | 1 | 0 | 0 | x | x | 0 | 0 | 0 | 0 | 0
 | 240 |  | f4l1 | f4_1 | l1_1 |  | 0 | 0 | 0 | 0 | 0 | 0 | 0 | 0 | 0 | 1 | x | x | x | 1 | 0 | 0 | 1 | 0 | 0 | x | x | 0 | 0 | 0 | 0 | 0
 | 241 |  | f4l1 | f4_1 | l1_1 |  | 0 | 0 | 0 | 1 | 0 | 0 | 1 | 0 | 0 | 1 | x | x | x | 0 | 0 | 0 | 0 | 1 | 0 | x | x | 0 | 0 | 0 | 0 | 0
 | 242 |  | f5l0 | f5_0 | l0_0 |  | 0 | 0 | 0 | 0 | 0 | 0 | 0 | 0 | 0 | 1 | x | x | x | 0 | 1 | 0 | 1 | 0 | 0 | x | x | 0 | 0 | 0 | 0 | 0
 | 243 |  | f5l0 | f5_1 | l0_1 | f5_0 | 0 | 1 | 1 | 0 | 0 | 0 | 0 | 0 | 0 | 1 | x | x | x | 1 | 0 | 0 | 1 | 0 | 0 | 0 | 1 | 0 | 0 | 0 | 0 | 0
 | 244 |  | f5l0 | f5_1 | l0_1 | f5_1 | 0 | 1 | 1 | 1 | 0 | 0 | 1 | 0 | 0 | 1 | x | x | x | 0 | 0 | 0 | 0 | 1 | 0 | 1 | 0 | 0 | 0 | 0 | 0 | 0
 |  |  | finish

Sheet: ML_0
changed | seq_num | 演算名 | 項 | src0 | src1 | dst | md | me0 | me1 | pm1 | pm1 | pm2 | pm2 | cm | cm | cm | pom1 | pom1 | pom1 | pom2 | pom2 | pom2 | pom3 | pom3 | pom3 | pos | pos | poa2 | poa2 | poa3 | poa3 | env | os |  | reg1 | reg2[0] | reg2[1] | reg2[2] | reg3[0] | reg3[1] | reg3[2] |  |  | reg1 | reg2[0] | reg2[1] | reg2[2] | reg3[0] | reg3[1] | reg3[2]
 |  |  |  |  |  |  | 0 | 1 | 2 | 3 | 4 | 5 | 6 | 7 | 8 | 9 | 10 | 11 | 12 | 13 | 14 | 15 | 16 | 17 | 18 | 19 | 20 | 21 | 22 | 23 | 24 | 25 | 26 | 対応演算
 | 1 |  | y^2 | y_0 | y_1 | A_1 | 0 | 1 | 1 | 0 | 0 | 0 | 0 | 0 | 1 | 0 | 0 | 0 | 1 | x | x | x | 0 | 0 | 1 | 0 | 0 | x | x | 1 | 0 |  | 0 |  |  |  |  |  |  |  | A=y^2 |  |  | in |  |  |  |  |  | in
 | 2 |  | y^2 | y_0 | y_1 | A_0 | 0 | 1 | 1 | 0 | 1 | 1 | 0 | 0 | 0 | 1 | 0 | 0 | 1 | x | x | x | 0 | 0 | 1 | 0 | 0 | x | x | 0 | 1 |  | 0 |  |  |  |  |  |  | A=y^2 | A=y^2 | in | pom2/pom3=001 | in |  |  |  |  | in
 | 3 |  | 3b'z^2 | z_0 | z_1 | - | 0 | 0 | 0 | 0 | 0 | 0 | 0 | 1 | 1 | 0 | 0 | 0 | 1 | 0 | 0 | 1 | x | x | x | x | x | 0 | 0 | x | x |  | 0 |  |  | B |  |  |  |  |  | out | pos=01/10 | in | in
 | 4 |  | 3b'z^2 | z_0 | z_1 | B_0 | 0 | 1 | 1 | 0 | 1 | 1 | 0 | 0 | 1 | 1 | 0 | 1 | 0 | 1 | 0 | 0 | x | x | x | 0 | 0 | 0 | 0 | x | x |  | 0 |  |  | B |  |  |  |  |  |  |  | out
 | 5 |  | 3b'z^2 | 2xy | x_0 | y_0 | B_1 | 0 | 1 | 1 | 0 | 0 | 0 | 0 | 0 | 1 | 0 | 0 | 0 | 1 | 0 | 0 | 0 | 0 | 0 | 1 | 0 | 1 | 0 | 0 | 0 | 0 |  | 0 |  |  | B |  |  | C=2xy |  |  |  |  | in | out |  |  | in
 | 6 |  | 2xy | x_1 | y_1 | C_0 | 0 | 1 | 1 | 0 | 0 | 0 | 0 | 0 | 1 | 0 | 1 | 0 | 0 | x | x | x | 0 | 1 | 0 | 0 | 0 | x | x | 0 | 0 |  | 0 |  |  |  |  |  | C=2xy |  |  |  |  | out
 | 7 |  | 2xy | x_1 | y_1 | C_1 | 0 | 1 | 1 | 1 | 0 | 0 | 1 | 0 | 1 | 0 | x | x | x | x | x | x | 0 | 1 | 1 | 1 | 0 | x | x | 0 | 0 |  | 0 |  |  |  |  |  | C=2xy |  |  |  |  |  |  |  |  | out
 | 8 |  | 3x^2 | x_0 | x_1 | D_1 | 0 | 1 | 1 | 0 | 0 | 0 | 0 | 1 | 1 | 0 | 0 | 0 | 1 | x | x | x | x | x | x | 0 | 0 | x | x | x | x |  | 0 |  |  |  |  |  |  |  |  |  |  | in
 | 9 |  | 3x^2 | x_0 | x_1 | D_0 | 0 | 1 | 1 | 0 | 1 | 1 | 0 | 0 | 1 | 1 | 0 | 0 | 1 | x | x | x | x | x | x | 0 | 0 | x | x | x | x |  | 0 |  |  |  |  |  |  |  |  |  |  | in
 | 10 |  | 2yz | y_0 | z_0 | - | 0 | 0 | 0 | 0 | 0 | 0 | 0 | 0 | 1 | 0 | 0 | 0 | 1 | 0 | 0 | 1 | x | x | x | 0 | 0 | 0 | 0 | x | x |  | 0 |  |  |  |  |  |  |  |  |  |  | in | in
 | 11 |  | 2yz | y_1 | z_1 | E_0 | 0 | 1 | 1 | 0 | 0 | 0 | 0 | 0 | 1 | 0 | 1 | 0 | 0 | 0 | 1 | 0 | x | x | x | 0 | 0 | 0 | 0 | x | x |  | 0 |  |  |  |  |  |  |  |  |  |  | out
 | 12 |  | 2yz | y_1 | z_1 | E_1 | 0 | 1 | 1 | 1 | 0 | 0 | 1 | 0 | 1 | 0 | x | x | x | 0 | 1 | 1 | x | x | x | 0 | 1 | 0 | 0 | x | x |  | 0 |  |  |  |  |  |  |  |  |  |  |  | out
 | 13 | f0^2 | f3^2(1+i) | f3_0 | f3_1 | - | 0 | 0 | 0 | 0 | 0 | 0 | 0 | 0 | 1 | 0 | x | x | x | 0 | 0 | 1 | 0 | 0 | 1 | x | x | x | x | 0 | 0 |  | 0 |  |  |  |  |  |  |  |  |  |  | out | in |  |  | in
 | 14 |  | f3^2(1+i) | f3_0 | f3_1 | acc2/acc3 | 0 | 0 | 0 | 0 | 1 | 1 | 0 | 0 | 0 | 1 | x | x | x | 0 | 1 | 1 | 0 | 1 | 0 | x | x | 0 | 0 | 0 | 0 |  | 0 |  |  |  |  |  |  |  |  |  |  | out
 | 15 |  | 2f4f2(1+i) | f4_0 | f2_0 |  | 0 | 0 | 0 | 0 | 0 | 0 | 0 | 1 | 0 | 0 | x | x | x | 0 | 1 | 0 | 0 | 0 | 0 | x | x | 0 | 0 | 0 | 0 |  | 0 |  |  |  |  |  |  |  |  |  |  | out
 | 16 |  | 2f4f2(1+i) | f4_1 | f2_1 |  | 0 | 0 | 0 | 0 | 0 | 0 | 0 | 1 | 0 | 0 | x | x | x | 0 | 0 | 0 | 1 | 0 | 0 | x | x | 0 | 0 | 0 | 0 |  | 0 |  |  |  |  |  |  |  |  |  |  | out
 | 17 |  | 2f4f2(1+i) | f4_1 | f2_1 | acc2/acc3 | 0 | 0 | 0 | 1 | 0 | 0 | 1 | 0 | 1 | 0 | x | x | x | 1 | 0 | 0 | 0 | 1 | 0 | x | x | 0 | 0 | 0 | 0 |  | 0 |  |  |  |  |  |  |  |  |  |  | out
 | 18 |  | 2f5f1(1+i) | f5_0 | f1_0 |  | 0 | 0 | 0 | 0 | 0 | 0 | 0 | 1 | 0 | 0 | x | x | x | 0 | 1 | 0 | 0 | 0 | 0 | x | x | 0 | 0 | 0 | 0 |  | 0 |  |  |  |  |  |  |  |  |  |  | out
 | 19 |  | 2f5f1(1+i) | f5_1 | f1_1 |  | 0 | 0 | 0 | 0 | 0 | 0 | 0 | 1 | 0 | 0 | x | x | x | 0 | 0 | 0 | 1 | 0 | 0 | x | x | 0 | 0 | 0 | 0 |  | 0 |  |  |  |  |  |  |  |  |  |  | out
 | 20 |  | 2f5f1(1+i) | f5_1 | f1_1 | acc2/acc3 | 0 | 0 | 0 | 1 | 0 | 0 | 1 | 0 | 1 | 0 | x | x | x | 1 | 0 | 0 | 0 | 1 | 0 | x | x | 0 | 0 | 0 | 0 |  | 0 |  |  |  |  |  |  |  |  |  |  | out
 | 21 |  | f0^2 | f0_0 | f0_1 | f0_1 | 0 | 1 | 1 | 0 | 0 | 0 | 0 | 0 | 1 | 0 | x | x | x | 0 | 0 | 0 | 0 | 1 | 0 | 1 | 0 | 0 | 0 | 0 | 0 |  | 0 |  |  |  |  |  |  |  |  |  |  |  |  |  |  | out
 | 22 |  | f0^2 | f0_0 | f0_1 | f0_0 | 0 | 1 | 1 | 0 | 1 | 1 | 0 | 0 | 0 | 1 | x | x | x | 0 | 1 | 0 | x | x | x | 0 | 1 | 0 | 0 | x | x |  | 0 |  |  |  |  |  |  |  |  |  |  |  | out
 | 23 | f1^2 | 2f5f2(1+i) | f5_0 | f2_0 |  | 0 | 0 | 0 | 0 | 0 | 0 | 0 | 1 | 0 | 0 | x | x | x | 0 | 0 | 1 | x | x | x | x | x | 0 | 0 | 0 | 0 |  | 0 |  |  |  |  |  |  |  |  |  |  | out | in
 | 24 |  | 2f5f2(1+i) | f5_1 | f2_1 | acc2 | 0 | 0 | 0 | 0 | 0 | 0 | 0 | 1 | 0 | 0 | x | x | x | 0 | 0 | 0 | 0 | 0 | 1 | x | x | 0 | 0 | 0 | 0 |  | 0 |  |  |  |  |  |  |  |  |  |  | out |  |  |  | in
 | 25 |  | 2f5f2(1+i) | f5_1 | f2_1 | acc3 | 0 | 0 | 0 | 1 | 0 | 0 | 1 | 0 | 1 | 0 | x | x | x | 1 | 0 | 0 | 0 | 1 | 1 | x | x | 0 | 0 | 0 | 0 |  | 0 |  |  |  |  |  |  |  |  |  |  | out
 | 26 |  | 2f4f3(1+i) | f4_0 | f3_0 |  | 0 | 0 | 0 | 0 | 0 | 0 | 0 | 1 | 0 | 0 | x | x | x | 0 | 1 | 0 | 0 | 0 | 0 | x | x | 0 | 0 | 0 | 0 |  | 0 |  |  |  |  |  |  |  |  |  |  | out
 | 27 |  | 2f4f3(1+i) | f4_1 | f3_1 | acc2 | 0 | 0 | 0 | 0 | 0 | 0 | 0 | 1 | 0 | 0 | x | x | x | 0 | 0 | 0 | 1 | 0 | 0 | x | x | 0 | 0 | 0 | 0 |  | 0 |  |  |  |  |  |  |  |  |  |  | out
 | 28 |  | 2f4f3(1+i) | f4_1 | f3_1 | acc3 | 0 | 0 | 0 | 1 | 0 | 0 | 1 | 0 | 1 | 0 | x | x | x | 1 | 0 | 0 | 0 | 1 | 0 | x | x | 0 | 0 | 0 | 0 |  | 0 |  |  |  |  |  |  |  |  |  |  | out
 | 29 |  | 2f1f0 | f1_0 | f0_0 |  | 0 | 0 | 0 | 0 | 0 | 0 | 0 | 0 | 1 | 0 | x | x | x | 0 | 1 | 0 | 1 | 0 | 0 | x | x | 0 | 0 | 0 | 0 |  | 0 |  |  |  |  |  |  |  |  |  |  | out
 | 30 |  | 2f1f0 | f1_1 | f0_1 | f1_0 | 0 | 1 | 1 | 0 | 0 | 0 | 0 | 0 | 1 | 0 | x | x | x | 1 | 0 | 0 | 1 | 0 | 0 | 0 | 1 | 0 | 0 | 0 | 0 |  | 0 |  |  |  |  |  |  |  |  |  |  |  | out
 | 31 |  | 2f1f0 | f1_1 | f0_1 | f1_1 | 0 | 1 | 1 | 1 | 0 | 0 | 1 | 0 | 1 | 0 | x | x | x | 0 | 0 | 0 | 0 | 1 | 0 | 1 | 0 | 0 | 0 | 0 | 0 |  | 0 |  |  |  |  |  |  |  |  |  |  |  |  |  |  | out
x | 32 |  |  | A_0 | Ri |  | 0 | 1 | 1 | 0 | 0 | 0 | 0 | 0 | 0 | 1 | 0 | 0 | 1 | x | x | x | x | x | x | x | x | x | x | x | x | 0 | 0 |  |  |  |  |  |  |  |  |  |  | in
x | 33 |  | l3 | B_0 | Ri | A_0-B_0 | 0 | 1 | 1 | 0 | 0 | 0 | 0 | 0 | 0 | 1 | 1 | 0 | 0 | x | x | x | x | x | x | 0 | 0 | x | x | x | x | 0 | 0 |  |  |  |  |  |  |  |  |  |  | out
x | 34 |  | 9b'z^2 | B_0 | Ri | A_0-3B_0
x | 35 |  | l3 | B_1 | Ri | A_1-B_1 | 0 | 1 | 1 | 0 | 0 | 0 | 0 | 0 | 0 | 1 | x | x | x | x | x | x | 1 | 0 | 0 | 1 | 0 | x | x | 1 | 0 |  | 0 |  |  |  |  |  |  |  |  |  |  |  |  |  |  |  |  | out
x | 36 |  | 9b'z^2 | B_1 | Ri | A_1-3B_1 | 0 | 1 | 1 | 0 | 0 | 0 | 0 | 0 | 1 | 0 | x | x | x | x | x | x | 1 | 0 | 0 | 1 | 0 | x | x | 1 | 0 |  | 0 |  |  |  |  |  |  |  |  |  |  |  |  |  |  |  |  | out
x | 37
 | 38 | f2^2 | f4^2(1+i) | f4_0 | f4_1 |  | 0 | 0 | 0 | 0 | 0 | 0 | 0 | 0 | 1 | 0 | x | x | x | 0 | 0 | 1 | 0 | 0 | 1 | x | x | x | x | 0 | 0 |  | 0 |  |  |  |  |  |  |  |  |  |  | out | in |  |  | in
 | 39 |  | f4^2(1+i) | f4_0 | f4_1 |  | 0 | 0 | 0 | 0 | 1 | 1 | 0 | 0 | 0 | 1 | x | x | x | 0 | 1 | 1 | 0 | 1 | 0 | x | x | 0 | 0 | 0 | 0 |  | 0 |  |  |  |  |  |  |  |  |  |  | out
 | 40 |  | 2f5f3(1+i) | f5_0 | f3_0 |  | 0 | 0 | 0 | 0 | 0 | 0 | 0 | 1 | 0 | 0 | x | x | x | 0 | 1 | 0 | 0 | 0 | 0 | x | x | 0 | 0 | 0 | 0 |  | 0 |  |  |  |  |  |  |  |  |  |  | out
 | 41 |  | 2f5f3(1+i) | f5_1 | f3_1 |  | 0 | 0 | 0 | 0 | 0 | 0 | 0 | 1 | 0 | 0 | x | x | x | 0 | 0 | 0 | 1 | 0 | 0 | x | x | 0 | 0 | 0 | 0 |  | 0 |  |  |  |  |  |  |  |  |  |  | out
 | 42 |  | 2f5f3(1+i) | f5_1 | f3_1 |  | 0 | 0 | 0 | 1 | 0 | 0 | 1 | 0 | 1 | 0 | x | x | x | 1 | 0 | 0 | 0 | 1 | 0 | x | x | 0 | 0 | 0 | 0 |  | 0 |  |  |  |  |  |  |  |  |  |  | out
 | 43 |  | 2f2f0 | f2_0 | f0_0 |  | 0 | 0 | 0 | 0 | 0 | 0 | 0 | 0 | 1 | 0 | x | x | x | 0 | 1 | 0 | 1 | 0 | 0 | x | x | 0 | 0 | 0 | 0 |  | 0 |  |  |  |  |  |  |  |  |  |  | out
 | 44 |  | 2f2f0 | f2_1 | f0_1 |  | 0 | 0 | 0 | 0 | 0 | 0 | 0 | 0 | 1 | 0 | x | x | x | 1 | 0 | 0 | 1 | 0 | 0 | x | x | 0 | 0 | 0 | 0 |  | 0 |  |  |  |  |  |  |  |  |  |  | out
 | 45 |  | 2f2f0 | f2_1 | f0_1 |  | 0 | 0 | 0 | 1 | 0 | 0 | 1 | 0 | 1 | 0 | x | x | x | 0 | 0 | 0 | 0 | 1 | 0 | x | x | 0 | 0 | 0 | 0 |  | 0 |  |  |  |  |  |  |  |  |  |  | out
 | 46 |  | f1^2 | f1_0 | f1_1 | f2_1 | 0 | 1 | 1 | 0 | 0 | 0 | 0 | 0 | 1 | 0 | x | x | x | 0 | 0 | 0 | 0 | 1 | 0 | 1 | 0 | 0 | 0 | 0 | 0 |  | 0 |  |  |  |  |  |  |  |  |  |  |  |  |  |  | out
 | 47 |  | f1^2 | f1_0 | f1_1 | f2_0 | 0 | 1 | 1 | 0 | 1 | 1 | 0 | 0 | 0 | 1 | x | x | x | 0 | 1 | 0 | x | x | x | 0 | 1 | 0 | 0 | x | x |  | 0 |  |  |  |  |  |  |  |  |  |  |  | out
 | 48 |  | ypE | yp | E_0 | l0_0 | 0 | 1 | 1 | 0 | 0 | 0 | 0 | 0 | 0 | 1 | 0 | 0 | 1 | x | x | x | x | x | x | 0 | 0 | x | x | x | x |  | 0 |  |  |  |  |  |  |  |  |  |  | in
 | 49 |  | ypE | yp | E_1 | l0_1 | 0 | 1 | 1 | 0 | 0 | 0 | 0 | 0 | 0 | 1 | 0 | 0 | 1 | x | x | x | x | x | x | 0 | 0 | x | x | x | x |  | 0 |  |  |  |  |  |  |  |  |  |  | in
 | 50 |  | xp~D | xp | D_0 |  | 0 | 0 | 0 | 0 | 0 | 0 | 0 | 0 | 0 | 1 | x | x | x | x | x | x | 0 | 0 | 1 | x | x | x | x | x | x |  | 0 |  |  |  |  |  |  |  |  |  |  | out |  |  |  | in
 | 51 |  | xp~D | xp | D_1 | l1_0 | 0 | 1 | 1 | 0 | 0 | 0 | 0 | 0 | 0 | 1 | 0 | 0 | 1 | x | x | x | 1 | 0 | 1 | 1 | 0 | x | x | x | x |  | 0 |  |  |  |  |  | ? |  |  |  |  | in
 | 52 | f3^2 | 2f5f4(1+i) | f5_0 | f4_0 | l1_1 | 0 | 1 | 1 | 0 | 0 | 0 | 0 | 1 | 0 | 0 | 1 | 0 | 1 | 0 | 0 | 1 | x | x | x | 0 | 0 | 0 | 0 | 0 | 0 |  | 0 |  |  |  |  |  |  |  |  |  |  | out | in
 | 53 |  | 2f5f4(1+i) | f5_1 | f4_1 |  | 0 | 0 | 0 | 0 | 0 | 0 | 0 | 1 | 0 | 0 | x | x | x | 0 | 0 | 0 | 0 | 0 | 1 | x | x | 0 | 0 | 0 | 0 |  | 0 |  |  |  |  |  |  |  |  |  |  | out |  |  |  | in
 | 54 |  | 2f5f4(1+i) | f5_1 | f4_1 |  | 0 | 0 | 0 | 1 | 0 | 0 | 1 | 0 | 1 | 0 | x | x | x | 1 | 0 | 0 | 0 | 1 | 1 | x | x | 0 | 0 | 0 | 0 |  | 0 |  |  |  |  |  |  |  |  |  |  | out
 | 55 |  | 2f3f0 | f3_0 | f0_0 |  | 0 | 0 | 0 | 0 | 0 | 0 | 0 | 0 | 1 | 0 | x | x | x | 0 | 1 | 0 | 1 | 0 | 0 | x | x | 0 | 0 | 0 | 0 |  | 0 |  |  |  |  |  |  |  |  |  |  | out
 | 56 |  | 2f3f0 | f3_1 | f0_1 |  | 0 | 0 | 0 | 0 | 0 | 0 | 0 | 0 | 1 | 0 | x | x | x | 1 | 0 | 0 | 1 | 0 | 0 | x | x | 0 | 0 | 0 | 0 |  | 0 |  |  |  |  |  |  |  |  |  |  | out
 | 57 |  | 2f3f0 | f3_1 | f0_1 |  | 0 | 0 | 0 | 1 | 0 | 0 | 1 | 0 | 1 | 0 | x | x | x | 0 | 0 | 0 | 0 | 1 | 0 | x | x | 0 | 0 | 0 | 0 |  | 0 |  |  |  |  |  |  |  |  |  |  | out
 | 58 |  | 2f2f1 | f2_0 | f1_0 |  | 0 | 0 | 0 | 0 | 0 | 0 | 0 | 0 | 1 | 0 | x | x | x | 0 | 1 | 0 | 1 | 0 | 0 | x | x | 0 | 0 | 0 | 0 |  | 0 |  |  |  |  |  |  |  |  |  |  | out
 | 59 |  | 2f2f1 | f2_1 | f1_1 | f3_0 | 0 | 1 | 1 | 0 | 0 | 0 | 0 | 0 | 1 | 0 | x | x | x | 1 | 0 | 0 | 1 | 0 | 0 | 0 | 1 | 0 | 0 | 0 | 0 |  | 0 |  |  |  |  |  |  |  |  |  |  |  | out
 | 60 |  | 2f2f1 | f2_1 | f1_1 | f3_1 | 0 | 1 | 1 | 1 | 0 | 0 | 1 | 0 | 1 | 0 | x | x | x | 0 | 0 | 0 | 0 | 1 | 0 | 1 | 0 | 0 | 0 | 0 | 0 |  | 0 |  |  |  |  |  |  |  |  |  |  |  |  |  |  | out
 | 61 | f4^2 | f5^2(1+i) | f5_0 | f5_1 |  | 0 | 0 | 0 | 0 | 0 | 0 | 0 | 0 | 1 | 0 | x | x | x | 0 | 0 | 1 | 0 | 0 | 1 | x | x | x | x | 0 | 0 |  | 0 |  |  |  |  |  |  |  |  |  |  | out | in |  |  | in
 | 62 |  | f5^2(1+i) | f5_0 | f5_1 |  | 0 | 0 | 0 | 0 | 1 | 1 | 0 | 0 | 0 | 1 | x | x | x | 0 | 1 | 1 | 0 | 1 | 0 | x | x | 0 | 0 | 0 | 0 |  | 0 |  |  |  |  |  |  |  |  |  |  | out
 | 63 |  | 2f4f0 | f4_0 | f0_0 |  | 0 | 0 | 0 | 0 | 0 | 0 | 0 | 0 | 1 | 0 | x | x | x | 0 | 1 | 0 | 1 | 0 | 0 | x | x | 0 | 0 | 0 | 0 |  | 0 |  |  |  |  |  |  |  |  |  |  | out
 | 64 |  | 2f4f0 | f4_1 | f0_1 |  | 0 | 0 | 0 | 0 | 0 | 0 | 0 | 0 | 1 | 0 | x | x | x | 1 | 0 | 0 | 1 | 0 | 0 | x | x | 0 | 0 | 0 | 0 |  | 0 |  |  |  |  |  |  |  |  |  |  | out
 | 65 |  | 2f4f0 | f4_1 | f0_1 |  | 0 | 0 | 0 | 1 | 0 | 0 | 1 | 0 | 1 | 0 | x | x | x | 0 | 0 | 0 | 0 | 1 | 0 | x | x | 0 | 0 | 0 | 0 |  | 0 |  |  |  |  |  |  |  |  |  |  | out
 | 66 |  | 2f3f1 | f3_0 | f1_0 |  | 0 | 0 | 0 | 0 | 0 | 0 | 0 | 0 | 1 | 0 | x | x | x | 0 | 1 | 0 | 1 | 0 | 0 | x | x | 0 | 0 | 0 | 0 |  | 0 |  |  |  |  |  |  |  |  |  |  | out
 | 67 |  | 2f3f1 | f3_1 | f1_1 |  | 0 | 0 | 0 | 0 | 0 | 0 | 0 | 0 | 1 | 0 | x | x | x | 1 | 0 | 0 | 1 | 0 | 0 | x | x | 0 | 0 | 0 | 0 |  | 0 |  |  |  |  |  |  |  |  |  |  | out
 | 68 |  | 2f3f1 | f3_1 | f1_1 |  | 0 | 0 | 0 | 1 | 0 | 0 | 1 | 0 | 1 | 0 | x | x | x | 0 | 0 | 0 | 0 | 1 | 0 | x | x | 0 | 0 | 0 | 0 |  | 0 |  |  |  |  |  |  |  |  |  |  | out
 | 69 |  | f2^2 | f2_0 | f2_1 | f4_1 | 0 | 1 | 1 | 0 | 0 | 0 | 0 | 0 | 1 | 0 | x | x | x | 0 | 0 | 0 | 0 | 1 | 0 | 1 | 0 | 0 | 0 | 0 | 0 |  | 0 |  |  |  |  |  |  |  |  |  |  |  |  |  |  | out
 | 70 |  | f2^2 | f2_0 | f2_1 | f4_0 | 0 | 1 | 1 | 0 | 1 | 1 | 0 | 0 | 0 | 1 | x | x | x | 0 | 1 | 0 | x | x | x | 0 | 1 | 0 | 0 | x | x |  | 0 |  |  |  |  |  |  |  |  |  |  |  | out
 | 71 | f5^2 | 2f5f0 | f5_0 | f0_0 |  | 0 | 0 | 0 | 0 | 0 | 0 | 0 | 0 | 1 | 0 | x | x | x | 0 | 0 | 1 | 0 | 0 | 1 | x | x | 0 | 0 | 0 | 0 |  | 0 |  |  |  |  |  |  |  |  |  |  | out | in |  |  | in
 | 72 |  | 2f5f0 | f5_1 | f0_1 |  | 0 | 0 | 0 | 0 | 0 | 0 | 0 | 0 | 1 | 0 | x | x | x | 1 | 0 | 0 | 0 | 1 | 0 | x | x | 0 | 0 | 0 | 0 |  | 0 |  |  |  |  |  |  |  |  |  |  | out
 | 73 |  | 2f5f0 | f5_1 | f0_1 |  | 0 | 0 | 0 | 1 | 0 | 0 | 1 | 0 | 1 | 0 | x | x | x | 0 | 0 | 0 | 0 | 1 | 1 | x | x | 0 | 0 | 0 | 0 |  | 0 |  |  |  |  |  |  |  |  |  |  | out
 | 74 |  | 2f4f1 | f4_0 | f1_0 |  | 0 | 0 | 0 | 0 | 0 | 0 | 0 | 0 | 1 | 0 | x | x | x | 0 | 1 | 0 | 1 | 0 | 0 | x | x | 0 | 0 | 0 | 0 |  | 0 |  |  |  |  |  |  |  |  |  |  | out
 | 75 |  | 2f4f1 | f4_1 | f1_1 |  | 0 | 0 | 0 | 0 | 0 | 0 | 0 | 0 | 1 | 0 | x | x | x | 1 | 0 | 0 | 1 | 0 | 0 | x | x | 0 | 0 | 0 | 0 |  | 0 |  |  |  |  |  |  |  |  |  |  | out
 | 76 |  | 2f4f1 | f4_1 | f1_1 |  | 0 | 0 | 0 | 1 | 0 | 0 | 1 | 0 | 1 | 0 | x | x | x | 0 | 0 | 0 | 0 | 1 | 0 | x | x | 0 | 0 | 0 | 0 |  | 0 |  |  |  |  |  |  |  |  |  |  | out
 | 77 |  | 2f3f2 | f3_0 | f2_0 |  | 0 | 0 | 0 | 0 | 0 | 0 | 0 | 0 | 1 | 0 | x | x | x | 0 | 1 | 0 | 1 | 0 | 0 | x | x | 0 | 0 | 0 | 0 |  | 0 |  |  |  |  |  |  |  |  |  |  | out
 | 78 |  | 2f3f2 | f3_1 | f2_1 | f5_0 | 0 | 1 | 1 | 0 | 0 | 0 | 0 | 0 | 1 | 0 | x | x | x | 1 | 0 | 0 | 1 | 0 | 0 | 0 | 1 | 0 | 0 | 0 | 0 |  | 0 |  |  |  |  |  |  |  |  |  |  |  | out
 | 79 |  | 2f3f2 | f3_1 | f2_1 | f5_1 | 0 | 1 | 1 | 1 | 0 | 0 | 1 | 0 | 1 | 0 | x | x | x | 0 | 0 | 0 | 0 | 1 | 0 | 1 | 0 | 0 | 0 | 0 | 0 |  | 0 |  |  |  |  |  |  |  |  |  |  |  |  |  |  | out
x | 80 |  | (A-3B)C | (A-3B)_0 | C_0 | - | 0 | 0 | 0 | 0 | 0 | 0 | 0 | 0 | 0 | 1 | 0 | 0 | 1 | 0 | 0 | 1 | x | x | x | 0 | 0 | 0 | 0 | x | x |  | 0 |  |  |  |  |  |  |  |  |  |  | in | in
x | 81 |  | (A-3B)C | (A-3B)_1 | C_1 | x3_0 | 0 | 1 | 1 | 0 | 0 | 0 | 0 | 0 | 0 | 1 | 1 | 0 | 0 | 0 | 1 | 0 | x | x | x | 0 | 0 | 0 | 0 | x | x |  | 0 |  |  |  |  |  |  |  |  |  |  | out
x | 82 |  | (A-3B)C | (A-3B)_1 | C_1 | x3_1 | 0 | 1 | 1 | 1 | 0 | 0 | 1 | 0 | 0 | 1 | x | x | x | 0 | 1 | 1 | x | x | x | 0 | 1 | 0 | 0 | x | x |  | 0 |  |  |  |  |  |  |  |  |  |  |  | out
 | 83 |  | A^2 | A_0 | A_1 |  | 0 | 0 | 0 | 0 | 0 | 0 | 0 | 0 | 1 | 0 | x | x | x | 0 | 0 | 0 | 0 | 0 | 1 | x | x | 0 | 0 | 0 | 0 |  | 0 |  |  |  |  |  |  |  |  |  |  | out |  |  |  | in
 | 84 |  | A^2 | A_0 | A_1 |  | 0 | 0 | 0 | 0 | 1 | 1 | 0 | 0 | 0 | 1 | x | x | x | 0 | 0 | 1 | 0 | 0 | 0 | x | x | 0 | 0 | 0 | 0 |  | 0 |  |  |  |  |  |  |  |  |  |  | out | in
 | 85 |  | 6AB | A_0 | B_0 |  | 0 | 0 | 0 | 0 | 0 | 0 | 0 | 1 | 1 | 0 | x | x | x | 0 | 1 | 0 | 1 | 0 | 0 | x | x | 0 | 0 | 0 | 0 |  | 0 |  |  |  |  |  |  |  |  |  |  | out
 | 86 |  | 6AB | A_1 | B_1 |  | 0 | 0 | 0 | 0 | 0 | 0 | 0 | 1 | 1 | 0 | x | x | x | 1 | 0 | 0 | 1 | 0 | 0 | x | x | 0 | 0 | 0 | 0 |  | 0 |  |  |  |  |  |  |  |  |  |  | out
 | 87 |  | 6AB | A_1 | B_1 |  | 0 | 0 | 0 | 1 | 0 | 0 | 1 | 1 | 1 | 0 | x | x | x | 0 | 0 | 0 | 0 | 1 | 0 | x | x | 0 | 0 | 0 | 0 |  | 0 |  |  |  |  |  |  |  |  |  |  | out
 | 88 |  | 3B^2 | B_0 | B_1 | y3_1 | 0 | 1 | 1 | 0 | 0 | 0 | 0 | 1 | 1 | 0 | x | x | x | 0 | 0 | 0 | 1 | 0 | 0 | 1 | 0 | 0 | 0 | 0 | 0 |  | 0 |  |  |  |  |  |  |  |  |  |  |  |  |  |  | out
 | 89 |  | 3B^2 | B_0 | B_1 | y3_0 | 0 | 1 | 1 | 0 | 1 | 1 | 0 | 0 | 1 | 1 | x | x | x | 1 | 0 | 0 | x | x | x | 0 | 1 | 0 | 0 | 0 | 0 |  | 0 |  |  |  |  |  |  |  |  |  |  |  | out
 | 90 |  | 4AE | A_0 | E_0 |  | 0 | 0 | 0 | 0 | 0 | 0 | 0 | 1 | 0 | 0 | 0 | 0 | 1 | 0 | 0 | 1 | x | x | x | 0 | 0 | 0 | 0 | x | x |  | 0 |  |  |  |  |  |  |  |  |  |  | in | in
 | 91 |  | 4AE | A_1 | E_1 | z3_0 | 0 | 1 | 1 | 0 | 0 | 0 | 0 | 1 | 0 | 0 | 1 | 0 | 0 | 0 | 1 | 0 | x | x | x | 0 | 0 | 0 | 0 | x | x |  | 0 |  |  |  |  |  |  |  |  |  |  | out
 | 92 |  | 4AE | A_1 | E_1 | z3_1 | 0 | 1 | 1 | 1 | 0 | 0 | 1 | 1 | 0 | 0 | x | x | x | 0 | 1 | 1 | x | x | x | 0 | 1 | 0 | 0 | x | x |  | 0 |  |  |  |  |  |  |  |  |  |  |  | out
 | 93 |  | f3l3(1+i) | f3_0 | l3_0 |  | 0 | 0 | 0 | 0 | 0 | 0 | 0 | 0 | 1 | 0 | x | x | x | 0 | 0 | 1 | x | x | x | x | x | 0 | 0 | 0 | 0 |  | 0 |  |  |  |  |  |  |  |  |  |  | out | in
 | 94 |  | f3l3(1+i) | f3_1 | l3_1 |  | 0 | 0 | 0 | 0 | 0 | 0 | 0 | 0 | 1 | 0 | x | x | x | 0 | 0 | 0 | 0 | 0 | 1 | x | x | 0 | 0 | 0 | 0 |  | 0 |  |  |  |  |  |  |  |  |  |  | out |  |  |  | in
 | 95 |  | f3l3(1+i) | f3_1 | l3_1 |  | 0 | 0 | 0 | 1 | 0 | 0 | 1 | 0 | 0 | 1 | x | x | x | 1 | 0 | 0 | 0 | 1 | 1 | x | x | 0 | 0 | 0 | 0 |  | 0 |  |  |  |  |  |  |  |  |  |  | out
 | 96 |  | f0l0 | f0_0 | l0_0 |  | 0 | 0 | 0 | 0 | 0 | 0 | 0 | 0 | 0 | 1 | x | x | x | 0 | 1 | 0 | 1 | 0 | 0 | x | x | 0 | 0 | 0 | 0 |  | 0 |  |  |  |  |  |  |  |  |  |  | out
 | 97 |  | f0l0 | f0_1 | l0_1 |  | 0 | 0 | 0 | 0 | 0 | 0 | 0 | 0 | 0 | 1 | x | x | x | 1 | 0 | 0 | 1 | 0 | 0 | x | x | 0 | 0 | 0 | 0 |  | 0 |  |  |  |  |  |  |  |  |  |  | out
 | 98 |  | f0l0 | f0_1 | l0_1 |  | 0 | 0 | 0 | 1 | 0 | 0 | 1 | 0 | 0 | 1 | x | x | x | 0 | 0 | 0 | 0 | 1 | 0 | x | x | 0 | 0 | 0 | 0 |  | 0 |  |  |  |  |  |  |  |  |  |  | out
 | 99 |  | f5l1(1+i) | f5_0 | l1_0 |  | 0 | 0 | 0 | 0 | 0 | 0 | 0 | 0 | 1 | 0 | x | x | x | 0 | 1 | 0 | 0 | 0 | 0 | x | x | 0 | 0 | 0 | 0 |  | 0 |  |  |  |  |  |  |  |  |  |  | out
 | 100 |  | f5l1(1+i) | f5_1 | l1_1 |  | 0 | 0 | 0 | 0 | 0 | 0 | 0 | 0 | 1 | 0 | x | x | x | 0 | 0 | 0 | 1 | 0 | 0 | x | x | 0 | 0 | 0 | 0 |  | 0 |  |  |  |  |  |  |  |  |  |  | out
 | 101 |  | f5l1(1+i) | f5_1 | l1_1 | f0_0 | 0 | 1 | 1 | 1 | 0 | 0 | 1 | 0 | 0 | 1 | x | x | x | 1 | 0 | 0 | 0 | 1 | 0 | 0 | 1 | 0 | 0 | 0 | 0 |  | 0 |  |  |  |  |  |  |  |  |  |  |  | out
 | 102 |  | f4l3(1+i) | f4_0 | l3_0 | f0_1 | 0 | 1 | 1 | 0 | 0 | 0 | 0 | 0 | 1 | 0 | x | x | x | 0 | 0 | 1 | x | x | x | 1 | 0 | 0 | 0 | 0 | 0 |  | 0 |  |  |  |  |  |  |  |  |  |  |  | in |  |  | out
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
 | 142 |  | f4l1 | f4_1 | l1_1 |  | 0 | 0 | 0 | 0 | 0 | 0 | 0 | 0 | 0 | 1 | x | x | x | 1 | 0 | 0 | 1 | 0 | 0 | x | x | 0 | 0 | 0 | 0 |  | 0 |  |  |  |  |  |  |  |  |  |  | out
 | 143 |  | f4l1 | f4_1 | l1_1 |  | 0 | 0 | 0 | 1 | 0 | 0 | 1 | 0 | 0 | 1 | x | x | x | 0 | 0 | 0 | 0 | 1 | 0 | x | x | 0 | 0 | 0 | 0 |  | 0 |  |  |  |  |  |  |  |  |  |  | out
 | 144 |  | f5l0 | f5_0 | l0_0 |  | 0 | 0 | 0 | 0 | 0 | 0 | 0 | 0 | 0 | 1 | x | x | x | 0 | 1 | 0 | 1 | 0 | 0 | x | x | 0 | 0 | 0 | 0 |  | 0 |  |  |  |  |  |  |  |  |  |  | out
 | 145 |  | f5l0 | f5_1 | l0_1 | f5_0 | 0 | 1 | 1 | 0 | 0 | 0 | 0 | 0 | 0 | 1 | x | x | x | 1 | 0 | 0 | 1 | 0 | 0 | 0 | 1 | 0 | 0 | 0 | 0 |  | 0 |  |  |  |  |  |  |  |  |  |  |  | out
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
