ankoman/HTBPA/src/const.xdc

#create_clock -period 2.000 -waveform {0.000 1.000} [get_ports clk]


#############################################################################
#### VCU118 Rev2.0 XDC 12/08/2017
#############################################################################
##Other net   PACKAGE_PIN AE17     - DXN                       Bank   0 - DXN
##Other net   PACKAGE_PIN AE18     - DXP                       Bank   0 - DXP
##Other net   PACKAGE_PIN AD18     - GND                       Bank   0 - VREFP
##Other net   PACKAGE_PIN AC17     - GND                       Bank   0 - VREFN
##Other net   PACKAGE_PIN AC18     - SYSMON_VP                 Bank   0 - VP
##Other net   PACKAGE_PIN AD17     - SYSMON_VN                 Bank   0 - VN
##Other net   PACKAGE_PIN U10      - FPGA_M0                   Bank   0 - M0_0
##Other net   PACKAGE_PIN Y11      - FPGA_M1                   Bank   0 - M1_0
##Other net   PACKAGE_PIN AC12     - FPGA_INIT_B               Bank   0 - INIT_B_0
##Other net   PACKAGE_PIN W11      - FPGA_M2                   Bank   0 - M2_0
##Other net   PACKAGE_PIN AB11     - GND                       Bank   0 - RSVDGND
##Other net   PACKAGE_PIN AD12     - PUDC_B_PIN                Bank   0 - PUDC_B_0
##Other net   PACKAGE_PIN AG12     - POR_OVERRIDE_PIN          Bank   0 - POR_OVERRIDE
##Other net   PACKAGE_PIN AE12     - FPGA_DONE                 Bank   0 - DONE_0
##Other net   PACKAGE_PIN AH11     - FPGA_PROG_B               Bank   0 - PROGRAM_B_0
##Other net   PACKAGE_PIN AD13     - FPGA_TDO_FMC_TDI          Bank   0 - TDO_0
##Other net   PACKAGE_PIN AD15     - JTAG_TDI                  Bank   0 - TDI_0
##Other net   PACKAGE_PIN AJ11     - QSPI0_CS_B                Bank   0 - RDWR_FCS_B_0
##Other net   PACKAGE_PIN AM11     - QSPI0_DQ2                 Bank   0 - D02_0
##Other net   PACKAGE_PIN AP11     - QSPI0_DQ0                 Bank   0 - D00_MOSI_0
##Other net   PACKAGE_PIN AL11     - QSPI0_DQ3                 Bank   0 - D03_0
##Other net   PACKAGE_PIN AN11     - QSPI0_DQ1                 Bank   0 - D01_DIN_0
##Other net   PACKAGE_PIN AF15     - JTAG_TMS                  Bank   0 - TMS_0
##Other net   PACKAGE_PIN AF13     - QSPI_CCLK                 Bank   0 - CCLK_0
##Other net   PACKAGE_PIN AE13     - JTAG_TCK                  Bank   0 - TCK_0
##Other net   PACKAGE_PIN AT11     - FPGA_VBATT                Bank   0 - VBATT
#set_property PACKAGE_PIN B25      [get_ports "RLD3_C3_72B_DM3"] ;# Bank  48 VCCO - VCC1V2_FPGA - IO_L24N_T3U_N11_48
#set_property IOSTANDARD  SSTL12 [get_ports "RLD3_C3_72B_DM3"] ;# Bank  48 VCCO - VCC1V2_FPGA - IO_L24N_T3U_N11_48
#set_property PACKAGE_PIN C25      [get_ports "RLD3_C3_72B_DQ71"] ;# Bank  48 VCCO - VCC1V2_FPGA - IO_L24P_T3U_N10_48
#set_property IOSTANDARD  SSTL12 [get_ports "RLD3_C3_72B_DQ71"] ;# Bank  48 VCCO - VCC1V2_FPGA - IO_L24P_T3U_N10_48
#set_property PACKAGE_PIN D26      [get_ports "RLD3_C3_72B_DQ70"] ;# Bank  48 VCCO - VCC1V2_FPGA - IO_L23N_T3U_N9_48
#set_property IOSTANDARD  SSTL12 [get_ports "RLD3_C3_72B_DQ70"] ;# Bank  48 VCCO - VCC1V2_FPGA - IO_L23N_T3U_N9_48
#set_property PACKAGE_PIN D25      [get_ports "RLD3_C3_72B_DQ69"] ;# Bank  48 VCCO - VCC1V2_FPGA - IO_L23P_T3U_N8_48
#set_property IOSTANDARD  SSTL12 [get_ports "RLD3_C3_72B_DQ69"] ;# Bank  48 VCCO - VCC1V2_FPGA - IO_L23P_T3U_N8_48
#set_property PACKAGE_PIN A26      [get_ports "RLD3_C3_72B_DQ68"] ;# Bank  48 VCCO - VCC1V2_FPGA - IO_L22N_T3U_N7_DBC_AD0N_48
#set_property IOSTANDARD  SSTL12 [get_ports "RLD3_C3_72B_DQ68"] ;# Bank  48 VCCO - VCC1V2_FPGA - IO_L22N_T3U_N7_DBC_AD0N_48
#set_property PACKAGE_PIN B26      [get_ports "RLD3_C3_72B_DQ67"] ;# Bank  48 VCCO - VCC1V2_FPGA - IO_L22P_T3U_N6_DBC_AD0P_48
#set_property IOSTANDARD  SSTL12 [get_ports "RLD3_C3_72B_DQ67"] ;# Bank  48 VCCO - VCC1V2_FPGA - IO_L22P_T3U_N6_DBC_AD0P_48
#set_property PACKAGE_PIN B27      [get_ports "RLD3_C3_72B_DQ66"] ;# Bank  48 VCCO - VCC1V2_FPGA - IO_L21N_T3L_N5_AD8N_48
#set_property IOSTANDARD  SSTL12 [get_ports "RLD3_C3_72B_DQ66"] ;# Bank  48 VCCO - VCC1V2_FPGA - IO_L21N_T3L_N5_AD8N_48
#set_property PACKAGE_PIN C27      [get_ports "RLD3_C3_72B_DQ65"] ;# Bank  48 VCCO - VCC1V2_FPGA - IO_L21P_T3L_N4_AD8P_48
#set_property IOSTANDARD  SSTL12 [get_ports "RLD3_C3_72B_DQ65"] ;# Bank  48 VCCO - VCC1V2_FPGA - IO_L21P_T3L_N4_AD8P_48
#set_property PACKAGE_PIN A28      [get_ports "RLD3_C3_72B_DQ64"] ;# Bank  48 VCCO - VCC1V2_FPGA - IO_L20N_T3L_N3_AD1N_48
#set_property IOSTANDARD  SSTL12 [get_ports "RLD3_C3_72B_DQ64"] ;# Bank  48 VCCO - VCC1V2_FPGA - IO_L20N_T3L_N3_AD1N_48
#set_property PACKAGE_PIN B28      [get_ports "RLD3_C3_72B_DQ63"] ;# Bank  48 VCCO - VCC1V2_FPGA - IO_L20P_T3L_N2_AD1P_48
#set_property IOSTANDARD  SSTL12 [get_ports "RLD3_C3_72B_DQ63"] ;# Bank  48 VCCO - VCC1V2_FPGA - IO_L20P_T3L_N2_AD1P_48
#set_property PACKAGE_PIN C28      [get_ports "RLD3_C3_72B_QK7_N"] ;# Bank  48 VCCO - VCC1V2_FPGA - IO_L19N_T3L_N1_DBC_AD9N_48
#set_property IOSTANDARD  DIFF_SSTL12 [get_ports "RLD3_C3_72B_QK7_N"] ;# Bank  48 VCCO - VCC1V2_FPGA - IO_L19N_T3L_N1_DBC_AD9N_48
#set_property PACKAGE_PIN D27      [get_ports "RLD3_C3_72B_QK7_P"] ;# Bank  48 VCCO - VCC1V2_FPGA - IO_L19P_T3L_N0_DBC_AD9P_48
#set_property IOSTANDARD  DIFF_SSTL12 [get_ports "RLD3_C3_72B_QK7_P"] ;# Bank  48 VCCO - VCC1V2_FPGA - IO_L19P_T3L_N0_DBC_AD9P_48
##set_property PACKAGE_PIN A25      [get_ports ""] ;# Bank  48 VCCO - VCC1V2_FPGA - IO_T3U_N12_48
##set_property IOSTANDARD  LVCMOSxx [get_ports ""] ;# Bank  48 VCCO - VCC1V2_FPGA - IO_T3U_N12_48
##set_property PACKAGE_PIN H25      [get_ports ""] ;# Bank  48 VCCO - VCC1V2_FPGA - IO_T2U_N12_48
##set_property IOSTANDARD  LVCMOSxx [get_ports ""] ;# Bank  48 VCCO - VCC1V2_FPGA - IO_T2U_N12_48
#set_property PACKAGE_PIN F25      [get_ports "RLD3_C3_72B_QVLD3"] ;# Bank  48 VCCO - VCC1V2_FPGA - IO_L18N_T2U_N11_AD2N_48
#set_property IOSTANDARD  SSTL12 [get_ports "RLD3_C3_72B_QVLD3"] ;# Bank  48 VCCO - VCC1V2_FPGA - IO_L18N_T2U_N11_AD2N_48
#set_property PACKAGE_PIN G25      [get_ports "RLD3_C3_72B_DQ62"] ;# Bank  48 VCCO - VCC1V2_FPGA - IO_L18P_T2U_N10_AD2P_48
#set_property IOSTANDARD  SSTL12 [get_ports "RLD3_C3_72B_DQ62"] ;# Bank  48 VCCO - VCC1V2_FPGA - IO_L18P_T2U_N10_AD2P_48
#set_property PACKAGE_PIN E27      [get_ports "RLD3_C3_72B_DQ61"] ;# Bank  48 VCCO - VCC1V2_FPGA - IO_L17N_T2U_N9_AD10N_48
#set_property IOSTANDARD  SSTL12 [get_ports "RLD3_C3_72B_DQ61"] ;# Bank  48 VCCO - VCC1V2_FPGA - IO_L17N_T2U_N9_AD10N_48
#set_property PACKAGE_PIN E26      [get_ports "RLD3_C3_72B_DQ60"] ;# Bank  48 VCCO - VCC1V2_FPGA - IO_L17P_T2U_N8_AD10P_48
#set_property IOSTANDARD  SSTL12 [get_ports "RLD3_C3_72B_DQ60"] ;# Bank  48 VCCO - VCC1V2_FPGA - IO_L17P_T2U_N8_AD10P_48
#set_property PACKAGE_PIN G28      [get_ports "RLD3_C3_72B_DQ59"] ;# Bank  48 VCCO - VCC1V2_FPGA - IO_L16N_T2U_N7_QBC_AD3N_48
#set_property IOSTANDARD  SSTL12 [get_ports "RLD3_C3_72B_DQ59"] ;# Bank  48 VCCO - VCC1V2_FPGA - IO_L16N_T2U_N7_QBC_AD3N_48
#set_property PACKAGE_PIN H28      [get_ports "RLD3_C3_72B_DQ58"] ;# Bank  48 VCCO - VCC1V2_FPGA - IO_L16P_T2U_N6_QBC_AD3P_48
#set_property IOSTANDARD  SSTL12 [get_ports "RLD3_C3_72B_DQ58"] ;# Bank  48 VCCO - VCC1V2_FPGA - IO_L16P_T2U_N6_QBC_AD3P_48
#set_property PACKAGE_PIN E28      [get_ports "RLD3_C3_72B_DQ57"] ;# Bank  48 VCCO - VCC1V2_FPGA - IO_L15N_T2L_N5_AD11N_48
#set_property IOSTANDARD  SSTL12 [get_ports "RLD3_C3_72B_DQ57"] ;# Bank  48 VCCO - VCC1V2_FPGA - IO_L15N_T2L_N5_AD11N_48
#set_property PACKAGE_PIN F28      [get_ports "RLD3_C3_72B_DQ56"] ;# Bank  48 VCCO - VCC1V2_FPGA - IO_L15P_T2L_N4_AD11P_48
#set_property IOSTANDARD  SSTL12 [get_ports "RLD3_C3_72B_DQ56"] ;# Bank  48 VCCO - VCC1V2_FPGA - IO_L15P_T2L_N4_AD11P_48
#set_property PACKAGE_PIN G27      [get_ports "RLD3_C3_72B_DQ55"] ;# Bank  48 VCCO - VCC1V2_FPGA - IO_L14N_T2L_N3_GC_48
#set_property IOSTANDARD  SSTL12 [get_ports "RLD3_C3_72B_DQ55"] ;# Bank  48 VCCO - VCC1V2_FPGA - IO_L14N_T2L_N3_GC_48
#set_property PACKAGE_PIN H27      [get_ports "RLD3_C3_72B_DQ54"] ;# Bank  48 VCCO - VCC1V2_FPGA - IO_L14P_T2L_N2_GC_48
#set_property IOSTANDARD  SSTL12 [get_ports "RLD3_C3_72B_DQ54"] ;# Bank  48 VCCO - VCC1V2_FPGA - IO_L14P_T2L_N2_GC_48
#set_property PACKAGE_PIN F26      [get_ports "RLD3_C3_72B_QK6_N"] ;# Bank  48 VCCO - VCC1V2_FPGA - IO_L13N_T2L_N1_GC_QBC_48
#set_property IOSTANDARD  DIFF_SSTL12 [get_ports "RLD3_C3_72B_QK6_N"] ;# Bank  48 VCCO - VCC1V2_FPGA - IO_L13N_T2L_N1_GC_QBC_48
#set_property PACKAGE_PIN G26      [get_ports "RLD3_C3_72B_QK6_P"] ;# Bank  48 VCCO - VCC1V2_FPGA - IO_L13P_T2L_N0_GC_QBC_48
#set_property IOSTANDARD  DIFF_SSTL12 [get_ports "RLD3_C3_72B_QK6_P"] ;# Bank  48 VCCO - VCC1V2_FPGA - IO_L13P_T2L_N0_GC_QBC_48
#set_property PACKAGE_PIN J27      [get_ports "RLD3_C3_72B_QVLD2"] ;# Bank  48 VCCO - VCC1V2_FPGA - IO_L12N_T1U_N11_GC_48
#set_property IOSTANDARD  SSTL12 [get_ports "RLD3_C3_72B_QVLD2"] ;# Bank  48 VCCO - VCC1V2_FPGA - IO_L12N_T1U_N11_GC_48
#set_property PACKAGE_PIN K27      [get_ports "RLD3_C3_72B_DQ53"] ;# Bank  48 VCCO - VCC1V2_FPGA - IO_L12P_T1U_N10_GC_48
#set_property IOSTANDARD  SSTL12 [get_ports "RLD3_C3_72B_DQ53"] ;# Bank  48 VCCO - VCC1V2_FPGA - IO_L12P_T1U_N10_GC_48
#set_property PACKAGE_PIN J26      [get_ports "RLD3_C3_72B_DQ52"] ;# Bank  48 VCCO - VCC1V2_FPGA - IO_L11N_T1U_N9_GC_48
#set_property IOSTANDARD  SSTL12 [get_ports "RLD3_C3_72B_DQ52"] ;# Bank  48 VCCO - VCC1V2_FPGA - IO_L11N_T1U_N9_GC_48
#set_property PACKAGE_PIN K26      [get_ports "RLD3_C3_72B_DQ51"] ;# Bank  48 VCCO - VCC1V2_FPGA - IO_L11P_T1U_N8_GC_48
#set_property IOSTANDARD  SSTL12 [get_ports "RLD3_C3_72B_DQ51"] ;# Bank  48 VCCO - VCC1V2_FPGA - IO_L11P_T1U_N8_GC_48
#set_property PACKAGE_PIN L25      [get_ports "RLD3_C3_72B_DQ50"] ;# Bank  48 VCCO - VCC1V2_FPGA - IO_L10N_T1U_N7_QBC_AD4N_48
#set_property IOSTANDARD  SSTL12 [get_ports "RLD3_C3_72B_DQ50"] ;# Bank  48 VCCO - VCC1V2_FPGA - IO_L10N_T1U_N7_QBC_AD4N_48
#set_property PACKAGE_PIN L24      [get_ports "RLD3_C3_72B_DQ49"] ;# Bank  48 VCCO - VCC1V2_FPGA - IO_L10P_T1U_N6_QBC_AD4P_48
#set_property IOSTANDARD  SSTL12 [get_ports "RLD3_C3_72B_DQ49"] ;# Bank  48 VCCO - VCC1V2_FPGA - IO_L10P_T1U_N6_QBC_AD4P_48
#set_property PACKAGE_PIN K28      [get_ports "RLD3_C3_72B_DQ48"] ;# Bank  48 VCCO - VCC1V2_FPGA - IO_L9N_T1L_N5_AD12N_48
#set_property IOSTANDARD  SSTL12 [get_ports "RLD3_C3_72B_DQ48"] ;# Bank  48 VCCO - VCC1V2_FPGA - IO_L9N_T1L_N5_AD12N_48
#set_property PACKAGE_PIN L28      [get_ports "RLD3_C3_72B_DQ47"] ;# Bank  48 VCCO - VCC1V2_FPGA - IO_L9P_T1L_N4_AD12P_48
#set_property IOSTANDARD  SSTL12 [get_ports "RLD3_C3_72B_DQ47"] ;# Bank  48 VCCO - VCC1V2_FPGA - IO_L9P_T1L_N4_AD12P_48
#set_property PACKAGE_PIN L26      [get_ports "RLD3_C3_72B_DQ46"] ;# Bank  48 VCCO - VCC1V2_FPGA - IO_L8N_T1L_N3_AD5N_48
#set_property IOSTANDARD  SSTL12 [get_ports "RLD3_C3_72B_DQ46"] ;# Bank  48 VCCO - VCC1V2_FPGA - IO_L8N_T1L_N3_AD5N_48
#set_property PACKAGE_PIN M25      [get_ports "RLD3_C3_72B_DQ45"] ;# Bank  48 VCCO - VCC1V2_FPGA - IO_L8P_T1L_N2_AD5P_48
#set_property IOSTANDARD  SSTL12 [get_ports "RLD3_C3_72B_DQ45"] ;# Bank  48 VCCO - VCC1V2_FPGA - IO_L8P_T1L_N2_AD5P_48
#set_property PACKAGE_PIN M28      [get_ports "RLD3_C3_72B_QK5_N"] ;# Bank  48 VCCO - VCC1V2_FPGA - IO_L7N_T1L_N1_QBC_AD13N_48
#set_property IOSTANDARD  DIFF_SSTL12 [get_ports "RLD3_C3_72B_QK5_N"] ;# Bank  48 VCCO - VCC1V2_FPGA - IO_L7N_T1L_N1_QBC_AD13N_48
#set_property PACKAGE_PIN M27      [get_ports "RLD3_C3_72B_QK5_P"] ;# Bank  48 VCCO - VCC1V2_FPGA - IO_L7P_T1L_N0_QBC_AD13P_48
#set_property IOSTANDARD  DIFF_SSTL12 [get_ports "RLD3_C3_72B_QK5_P"] ;# Bank  48 VCCO - VCC1V2_FPGA - IO_L7P_T1L_N0_QBC_AD13P_48
##set_property PACKAGE_PIN J25      [get_ports ""] ;# Bank  48 VCCO - VCC1V2_FPGA - IO_T1U_N12_48
##set_property IOSTANDARD  LVCMOSxx [get_ports ""] ;# Bank  48 VCCO - VCC1V2_FPGA - IO_T1U_N12_48
##set_property PACKAGE_PIN M26      [get_ports "VRP_48"] ;# Bank  48 VCCO - VCC1V2_FPGA - IO_T0U_N12_VRP_48
##set_property IOSTANDARD  LVCMOSxx [get_ports "VRP_48"] ;# Bank  48 VCCO - VCC1V2_FPGA - IO_T0U_N12_VRP_48
#set_property PACKAGE_PIN N24      [get_ports "RLD3_C3_72B_DM2"] ;# Bank  48 VCCO - VCC1V2_FPGA - IO_L6N_T0U_N11_AD6N_48
#set_property IOSTANDARD  SSTL12 [get_ports "RLD3_C3_72B_DM2"] ;# Bank  48 VCCO - VCC1V2_FPGA - IO_L6N_T0U_N11_AD6N_48
#set_property PACKAGE_PIN P24      [get_ports "RLD3_C3_72B_DQ44"] ;# Bank  48 VCCO - VCC1V2_FPGA - IO_L6P_T0U_N10_AD6P_48
#set_property IOSTANDARD  SSTL12 [get_ports "RLD3_C3_72B_DQ44"] ;# Bank  48 VCCO - VCC1V2_FPGA - IO_L6P_T0U_N10_AD6P_48
#set_property PACKAGE_PIN N27      [get_ports "RLD3_C3_72B_DQ43"] ;# Bank  48 VCCO - VCC1V2_FPGA - IO_L5N_T0U_N9_AD14N_48
#set_property IOSTANDARD  SSTL12 [get_ports "RLD3_C3_72B_DQ43"] ;# Bank  48 VCCO - VCC1V2_FPGA - IO_L5N_T0U_N9_AD14N_48
#set_property PACKAGE_PIN P26      [get_ports "RLD3_C3_72B_DQ42"] ;# Bank  48 VCCO - VCC1V2_FPGA - IO_L5P_T0U_N8_AD14P_48
#set_property IOSTANDARD  SSTL12 [get_ports "RLD3_C3_72B_DQ42"] ;# Bank  48 VCCO - VCC1V2_FPGA - IO_L5P_T0U_N8_AD14P_48
#set_property PACKAGE_PIN N25      [get_ports "RLD3_C3_72B_DQ41"] ;# Bank  48 VCCO - VCC1V2_FPGA - IO_L4N_T0U_N7_DBC_AD7N_48
#set_property IOSTANDARD  SSTL12 [get_ports "RLD3_C3_72B_DQ41"] ;# Bank  48 VCCO - VCC1V2_FPGA - IO_L4N_T0U_N7_DBC_AD7N_48
#set_property PACKAGE_PIN P25      [get_ports "RLD3_C3_72B_DQ40"] ;# Bank  48 VCCO - VCC1V2_FPGA - IO_L4P_T0U_N6_DBC_AD7P_48
#set_property IOSTANDARD  SSTL12 [get_ports "RLD3_C3_72B_DQ40"] ;# Bank  48 VCCO - VCC1V2_FPGA - IO_L4P_T0U_N6_DBC_AD7P_48
#set_property PACKAGE_PIN P27      [get_ports "RLD3_C3_72B_DQ39"] ;# Bank  48 VCCO - VCC1V2_FPGA - IO_L3N_T0L_N5_AD15N_48
#set_property IOSTANDARD  SSTL12 [get_ports "RLD3_C3_72B_DQ39"] ;# Bank  48 VCCO - VCC1V2_FPGA - IO_L3N_T0L_N5_AD15N_48
#set_property PACKAGE_PIN R27      [get_ports "RLD3_C3_72B_DQ38"] ;# Bank  48 VCCO - VCC1V2_FPGA - IO_L3P_T0L_N4_AD15P_48
#set_property IOSTANDARD  SSTL12 [get_ports "RLD3_C3_72B_DQ38"] ;# Bank  48 VCCO - VCC1V2_FPGA - IO_L3P_T0L_N4_AD15P_48
#set_property PACKAGE_PIN R24      [get_ports "RLD3_C3_72B_DQ37"] ;# Bank  48 VCCO - VCC1V2_FPGA - IO_L2N_T0L_N3_48
#set_property IOSTANDARD  SSTL12 [get_ports "RLD3_C3_72B_DQ37"] ;# Bank  48 VCCO - VCC1V2_FPGA - IO_L2N_T0L_N3_48
#set_property PACKAGE_PIN T24      [get_ports "RLD3_C3_72B_DQ36"] ;# Bank  48 VCCO - VCC1V2_FPGA - IO_L2P_T0L_N2_48
#set_property IOSTANDARD  SSTL12 [get_ports "RLD3_C3_72B_DQ36"] ;# Bank  48 VCCO - VCC1V2_FPGA - IO_L2P_T0L_N2_48
#set_property PACKAGE_PIN R26      [get_ports "RLD3_C3_72B_QK4_N"] ;# Bank  48 VCCO - VCC1V2_FPGA - IO_L1N_T0L_N1_DBC_48
#set_property IOSTANDARD  DIFF_SSTL12 [get_ports "RLD3_C3_72B_QK4_N"] ;# Bank  48 VCCO - VCC1V2_FPGA - IO_L1N_T0L_N1_DBC_48
#set_property PACKAGE_PIN T26      [get_ports "RLD3_C3_72B_QK4_P"] ;# Bank  48 VCCO - VCC1V2_FPGA - IO_L1P_T0L_N0_DBC_48
#set_property IOSTANDARD  DIFF_SSTL12 [get_ports "RLD3_C3_72B_QK4_P"] ;# Bank  48 VCCO - VCC1V2_FPGA - IO_L1P_T0L_N0_DBC_48
##Other net   PACKAGE_PIN T25      -                  Bank  48 - VREF_48
#set_property PACKAGE_PIN C29      [get_ports "RLD3_C3_72B_A1"] ;# Bank  47 VCCO - VCC1V2_FPGA - IO_L24N_T3U_N11_47
#set_property IOSTANDARD  SSTL12 [get_ports "RLD3_C3_72B_A1"] ;# Bank  47 VCCO - VCC1V2_FPGA - IO_L24N_T3U_N11_47
#set_property PACKAGE_PIN D29      [get_ports "RLD3_C3_72B_A2"] ;# Bank  47 VCCO - VCC1V2_FPGA - IO_L24P_T3U_N10_47
#set_property IOSTANDARD  SSTL12 [get_ports "RLD3_C3_72B_A2"] ;# Bank  47 VCCO - VCC1V2_FPGA - IO_L24P_T3U_N10_47
#set_property PACKAGE_PIN B30      [get_ports "RLD3_C3_72B_A3"] ;# Bank  47 VCCO - VCC1V2_FPGA - IO_L23N_T3U_N9_47
#set_property IOSTANDARD  SSTL12 [get_ports "RLD3_C3_72B_A3"] ;# Bank  47 VCCO - VCC1V2_FPGA - IO_L23N_T3U_N9_47
#set_property PACKAGE_PIN C30      [get_ports "RLD3_C3_72B_A4"] ;# Bank  47 VCCO - VCC1V2_FPGA - IO_L23P_T3U_N8_47
#set_property IOSTANDARD  SSTL12 [get_ports "RLD3_C3_72B_A4"] ;# Bank  47 VCCO - VCC1V2_FPGA - IO_L23P_T3U_N8_47
#set_property PACKAGE_PIN A31      [get_ports "RLD3_C3_72B_A5"] ;# Bank  47 VCCO - VCC1V2_FPGA - IO_L22N_T3U_N7_DBC_AD0N_47
#set_property IOSTANDARD  SSTL12 [get_ports "RLD3_C3_72B_A5"] ;# Bank  47 VCCO - VCC1V2_FPGA - IO_L22N_T3U_N7_DBC_AD0N_47
#set_property PACKAGE_PIN A30      [get_ports "RLD3_C3_72B_A6"] ;# Bank  47 VCCO - VCC1V2_FPGA - IO_L22P_T3U_N6_DBC_AD0P_47
#set_property IOSTANDARD  SSTL12 [get_ports "RLD3_C3_72B_A6"] ;# Bank  47 VCCO - VCC1V2_FPGA - IO_L22P_T3U_N6_DBC_AD0P_47
#set_property PACKAGE_PIN A33      [get_ports "RLD3_C3_72B_A7"] ;# Bank  47 VCCO - VCC1V2_FPGA - IO_L21N_T3L_N5_AD8N_47
#set_property IOSTANDARD  SSTL12 [get_ports "RLD3_C3_72B_A7"] ;# Bank  47 VCCO - VCC1V2_FPGA - IO_L21N_T3L_N5_AD8N_47
#set_property PACKAGE_PIN B33      [get_ports "RLD3_C3_72B_A8"] ;# Bank  47 VCCO - VCC1V2_FPGA - IO_L21P_T3L_N4_AD8P_47
#set_property IOSTANDARD  SSTL12 [get_ports "RLD3_C3_72B_A8"] ;# Bank  47 VCCO - VCC1V2_FPGA - IO_L21P_T3L_N4_AD8P_47
#set_property PACKAGE_PIN B32      [get_ports "RLD3_C3_72B_A9"] ;# Bank  47 VCCO - VCC1V2_FPGA - IO_L20N_T3L_N3_AD1N_47
#set_property IOSTANDARD  SSTL12 [get_ports "RLD3_C3_72B_A9"] ;# Bank  47 VCCO - VCC1V2_FPGA - IO_L20N_T3L_N3_AD1N_47
#set_property PACKAGE_PIN B31      [get_ports "RLD3_C3_72B_A10"] ;# Bank  47 VCCO - VCC1V2_FPGA - IO_L20P_T3L_N2_AD1P_47
#set_property IOSTANDARD  SSTL12 [get_ports "RLD3_C3_72B_A10"] ;# Bank  47 VCCO - VCC1V2_FPGA - IO_L20P_T3L_N2_AD1P_47
#set_property PACKAGE_PIN C33      [get_ports "RLD3_C3_72B_A11"] ;# Bank  47 VCCO - VCC1V2_FPGA - IO_L19N_T3L_N1_DBC_AD9N_47
#set_property IOSTANDARD  SSTL12 [get_ports "RLD3_C3_72B_A11"] ;# Bank  47 VCCO - VCC1V2_FPGA - IO_L19N_T3L_N1_DBC_AD9N_47
#set_property PACKAGE_PIN C32      [get_ports "RLD3_C3_72B_A12"] ;# Bank  47 VCCO - VCC1V2_FPGA - IO_L19P_T3L_N0_DBC_AD9P_47
#set_property IOSTANDARD  SSTL12 [get_ports "RLD3_C3_72B_A12"] ;# Bank  47 VCCO - VCC1V2_FPGA - IO_L19P_T3L_N0_DBC_AD9P_47
#set_property PACKAGE_PIN A29      [get_ports "RLD3_C3_72B_A0"] ;# Bank  47 VCCO - VCC1V2_FPGA - IO_T3U_N12_47
#set_property IOSTANDARD  SSTL12 [get_ports "RLD3_C3_72B_A0"] ;# Bank  47 VCCO - VCC1V2_FPGA - IO_T3U_N12_47
#set_property PACKAGE_PIN D30      [get_ports "RLD3_C3_72B_A13"] ;# Bank  47 VCCO - VCC1V2_FPGA - IO_T2U_N12_47
#set_property IOSTANDARD  SSTL12 [get_ports "RLD3_C3_72B_A13"] ;# Bank  47 VCCO - VCC1V2_FPGA - IO_T2U_N12_47
#set_property PACKAGE_PIN E29      [get_ports "RLD3_C3_72B_A14"] ;# Bank  47 VCCO - VCC1V2_FPGA - IO_L18N_T2U_N11_AD2N_47
#set_property IOSTANDARD  SSTL12 [get_ports "RLD3_C3_72B_A14"] ;# Bank  47 VCCO - VCC1V2_FPGA - IO_L18N_T2U_N11_AD2N_47
#set_property PACKAGE_PIN F29      [get_ports "RLD3_C3_72B_A15"] ;# Bank  47 VCCO - VCC1V2_FPGA - IO_L18P_T2U_N10_AD2P_47
#set_property IOSTANDARD  SSTL12 [get_ports "RLD3_C3_72B_A15"] ;# Bank  47 VCCO - VCC1V2_FPGA - IO_L18P_T2U_N10_AD2P_47
#set_property PACKAGE_PIN D32      [get_ports "RLD3_C3_72B_A16"] ;# Bank  47 VCCO - VCC1V2_FPGA - IO_L17N_T2U_N9_AD10N_47
#set_property IOSTANDARD  SSTL12 [get_ports "RLD3_C3_72B_A16"] ;# Bank  47 VCCO - VCC1V2_FPGA - IO_L17N_T2U_N9_AD10N_47
#set_property PACKAGE_PIN E32      [get_ports "RLD3_C3_72B_A17"] ;# Bank  47 VCCO - VCC1V2_FPGA - IO_L17P_T2U_N8_AD10P_47
#set_property IOSTANDARD  SSTL12 [get_ports "RLD3_C3_72B_A17"] ;# Bank  47 VCCO - VCC1V2_FPGA - IO_L17P_T2U_N8_AD10P_47
#set_property PACKAGE_PIN D31      [get_ports "RLD3_C3_72B_A18"] ;# Bank  47 VCCO - VCC1V2_FPGA - IO_L16N_T2U_N7_QBC_AD3N_47
#set_property IOSTANDARD  SSTL12 [get_ports "RLD3_C3_72B_A18"] ;# Bank  47 VCCO - VCC1V2_FPGA - IO_L16N_T2U_N7_QBC_AD3N_47
#set_property PACKAGE_PIN E31      [get_ports "RLD3_C3_72B_A19"] ;# Bank  47 VCCO - VCC1V2_FPGA - IO_L16P_T2U_N6_QBC_AD3P_47
#set_property IOSTANDARD  SSTL12 [get_ports "RLD3_C3_72B_A19"] ;# Bank  47 VCCO - VCC1V2_FPGA - IO_L16P_T2U_N6_QBC_AD3P_47
#set_property PACKAGE_PIN E33      [get_ports "RLD3_C3_72B_BA0"] ;# Bank  47 VCCO - VCC1V2_FPGA - IO_L15N_T2L_N5_AD11N_47
#set_property IOSTANDARD  SSTL12 [get_ports "RLD3_C3_72B_BA0"] ;# Bank  47 VCCO - VCC1V2_FPGA - IO_L15N_T2L_N5_AD11N_47
#set_property PACKAGE_PIN F33      [get_ports "RLD3_C3_72B_BA1"] ;# Bank  47 VCCO - VCC1V2_FPGA - IO_L15P_T2L_N4_AD11P_47
#set_property IOSTANDARD  SSTL12 [get_ports "RLD3_C3_72B_BA1"] ;# Bank  47 VCCO - VCC1V2_FPGA - IO_L15P_T2L_N4_AD11P_47
#set_property PACKAGE_PIN F30      [get_ports "RLD3_C3_72B_BA2"] ;# Bank  47 VCCO - VCC1V2_FPGA - IO_L14N_T2L_N3_GC_47
#set_property IOSTANDARD  SSTL12 [get_ports "RLD3_C3_72B_BA2"] ;# Bank  47 VCCO - VCC1V2_FPGA - IO_L14N_T2L_N3_GC_47
#set_property PACKAGE_PIN G30      [get_ports "RLD3_C3_72B_BA3"] ;# Bank  47 VCCO - VCC1V2_FPGA - IO_L14P_T2L_N2_GC_47
#set_property IOSTANDARD  SSTL12 [get_ports "RLD3_C3_72B_BA3"] ;# Bank  47 VCCO - VCC1V2_FPGA - IO_L14P_T2L_N2_GC_47
#set_property PACKAGE_PIN F31      [get_ports "CLK_N"] ;# Bank  47 VCCO - VCC1V2_FPGA - IO_L13N_T2L_N1_GC_QBC_47
#set_property IOSTANDARD  DIFF_SSTL12 [get_ports "CLK_N"] ;# Bank  47 VCCO - VCC1V2_FPGA - IO_L13N_T2L_N1_GC_QBC_47
#set_property PACKAGE_PIN G31      [get_ports "CLK_P"] ;# Bank  47 VCCO - VCC1V2_FPGA - IO_L13P_T2L_N0_GC_QBC_47
#set_property IOSTANDARD  DIFF_SSTL12 [get_ports "CLK_P"] ;# Bank  47 VCCO - VCC1V2_FPGA - IO_L13P_T2L_N0_GC_QBC_47
#set_property PACKAGE_PIN G32      [get_ports "USER_SI570_CLOCK_N"] ;# Bank  47 VCCO - VCC1V2_FPGA - IO_L12N_T1U_N11_GC_47
#set_property IOSTANDARD  DIFF_SSTL12 [get_ports "USER_SI570_CLOCK_N"] ;# Bank  47 VCCO - VCC1V2_FPGA - IO_L12N_T1U_N11_GC_47
#set_property PACKAGE_PIN H32      [get_ports "USER_SI570_CLOCK_P"] ;# Bank  47 VCCO - VCC1V2_FPGA - IO_L12P_T1U_N10_GC_47
#set_property IOSTANDARD  DIFF_SSTL12 [get_ports "USER_SI570_CLOCK_P"] ;# Bank  47 VCCO - VCC1V2_FPGA - IO_L12P_T1U_N10_GC_47
#set_property PACKAGE_PIN H30      [get_ports "RLD3_C3_72B_CK_N"] ;# Bank  47 VCCO - VCC1V2_FPGA - IO_L11N_T1U_N9_GC_47
#set_property IOSTANDARD  DIFF_SSTL12 [get_ports "RLD3_C3_72B_CK_N"] ;# Bank  47 VCCO - VCC1V2_FPGA - IO_L11N_T1U_N9_GC_47
#set_property PACKAGE_PIN H29      [get_ports "RLD3_C3_72B_CK_P"] ;# Bank  47 VCCO - VCC1V2_FPGA - IO_L11P_T1U_N8_GC_47
#set_property IOSTANDARD  DIFF_SSTL12 [get_ports "RLD3_C3_72B_CK_P"] ;# Bank  47 VCCO - VCC1V2_FPGA - IO_L11P_T1U_N8_GC_47
#set_property PACKAGE_PIN G33      [get_ports "RLD3_C3_72B_DK3_N"] ;# Bank  47 VCCO - VCC1V2_FPGA - IO_L10N_T1U_N7_QBC_AD4N_47
#set_property IOSTANDARD  DIFF_SSTL12 [get_ports "RLD3_C3_72B_DK3_N"] ;# Bank  47 VCCO - VCC1V2_FPGA - IO_L10N_T1U_N7_QBC_AD4N_47
#set_property PACKAGE_PIN H33      [get_ports "RLD3_C3_72B_DK3_P"] ;# Bank  47 VCCO - VCC1V2_FPGA - IO_L10P_T1U_N6_QBC_AD4P_47
#set_property IOSTANDARD  DIFF_SSTL12 [get_ports "RLD3_C3_72B_DK3_P"] ;# Bank  47 VCCO - VCC1V2_FPGA - IO_L10P_T1U_N6_QBC_AD4P_47
#set_property PACKAGE_PIN J30      [get_ports "RLD3_C3_72B_DK2_N"] ;# Bank  47 VCCO - VCC1V2_FPGA - IO_L9N_T1L_N5_AD12N_47
#set_property IOSTANDARD  DIFF_SSTL12 [get_ports "RLD3_C3_72B_DK2_N"] ;# Bank  47 VCCO - VCC1V2_FPGA - IO_L9N_T1L_N5_AD12N_47
#set_property PACKAGE_PIN J29      [get_ports "RLD3_C3_72B_DK2_P"] ;# Bank  47 VCCO - VCC1V2_FPGA - IO_L9P_T1L_N4_AD12P_47
#set_property IOSTANDARD  DIFF_SSTL12 [get_ports "RLD3_C3_72B_DK2_P"] ;# Bank  47 VCCO - VCC1V2_FPGA - IO_L9P_T1L_N4_AD12P_47
#set_property PACKAGE_PIN J32      [get_ports "RLD3_C3_72B_DK1_N"] ;# Bank  47 VCCO - VCC1V2_FPGA - IO_L8N_T1L_N3_AD5N_47
#set_property IOSTANDARD  DIFF_SSTL12 [get_ports "RLD3_C3_72B_DK1_N"] ;# Bank  47 VCCO - VCC1V2_FPGA - IO_L8N_T1L_N3_AD5N_47
#set_property PACKAGE_PIN K32      [get_ports "RLD3_C3_72B_DK1_P"] ;# Bank  47 VCCO - VCC1V2_FPGA - IO_L8P_T1L_N2_AD5P_47
#set_property IOSTANDARD  DIFF_SSTL12 [get_ports "RLD3_C3_72B_DK1_P"] ;# Bank  47 VCCO - VCC1V2_FPGA - IO_L8P_T1L_N2_AD5P_47
#set_property PACKAGE_PIN J31      [get_ports "RLD3_C3_72B_DK0_N"] ;# Bank  47 VCCO - VCC1V2_FPGA - IO_L7N_T1L_N1_QBC_AD13N_47
#set_property IOSTANDARD  DIFF_SSTL12 [get_ports "RLD3_C3_72B_DK0_N"] ;# Bank  47 VCCO - VCC1V2_FPGA - IO_L7N_T1L_N1_QBC_AD13N_47
#set_property PACKAGE_PIN K31      [get_ports "RLD3_C3_72B_DK0_P"] ;# Bank  47 VCCO - VCC1V2_FPGA - IO_L7P_T1L_N0_QBC_AD13P_47
#set_property IOSTANDARD  DIFF_SSTL12 [get_ports "RLD3_C3_72B_DK0_P"] ;# Bank  47 VCCO - VCC1V2_FPGA - IO_L7P_T1L_N0_QBC_AD13P_47
#set_property PACKAGE_PIN K29      [get_ports "RLD3_C3_72B_WE_B"] ;# Bank  47 VCCO - VCC1V2_FPGA - IO_T1U_N12_47
#set_property IOSTANDARD  SSTL12 [get_ports "RLD3_C3_72B_WE_B"] ;# Bank  47 VCCO - VCC1V2_FPGA - IO_T1U_N12_47
##set_property PACKAGE_PIN T29      [get_ports "VRP_47"] ;# Bank  47 VCCO - VCC1V2_FPGA - IO_T0U_N12_VRP_47
##set_property IOSTANDARD  LVCMOSxx [get_ports "VRP_47"] ;# Bank  47 VCCO - VCC1V2_FPGA - IO_T0U_N12_VRP_47
#set_property PACKAGE_PIN L30      [get_ports "RLD3_C3_72B_REF_B"] ;# Bank  47 VCCO - VCC1V2_FPGA - IO_L6N_T0U_N11_AD6N_47
#set_property IOSTANDARD  SSTL12 [get_ports "RLD3_C3_72B_REF_B"] ;# Bank  47 VCCO - VCC1V2_FPGA - IO_L6N_T0U_N11_AD6N_47
#set_property PACKAGE_PIN L29      [get_ports "RLD3_C3_72B_RESET_B"] ;# Bank  47 VCCO - VCC1V2_FPGA - IO_L6P_T0U_N10_AD6P_47
#set_property IOSTANDARD  LVCMOS12 [get_ports "RLD3_C3_72B_RESET_B"] ;# Bank  47 VCCO - VCC1V2_FPGA - IO_L6P_T0U_N10_AD6P_47
#set_property PACKAGE_PIN N29      [get_ports "RLD3_C3_72B_CS_B"] ;# Bank  47 VCCO - VCC1V2_FPGA - IO_L5N_T0U_N9_AD14N_47
#set_property IOSTANDARD  SSTL12 [get_ports "RLD3_C3_72B_CS_B"] ;# Bank  47 VCCO - VCC1V2_FPGA - IO_L5N_T0U_N9_AD14N_47
# set_property PACKAGE_PIN N28 [get_ports {PMOD1_LS[0]}]
# set_property IOSTANDARD LVCMOS12 [get_ports {PMOD1_LS[0]}]
#set_property PACKAGE_PIN M30      [get_ports "PMOD1_LS[1]"] ;# Bank  47 VCCO - VCC1V2_FPGA - IO_L4N_T0U_N7_DBC_AD7N_47
#set_property IOSTANDARD  LVCMOS12 [get_ports "PMOD1_LS[1]"] ;# Bank  47 VCCO - VCC1V2_FPGA - IO_L4N_T0U_N7_DBC_AD7N_47
#set_property PACKAGE_PIN N30      [get_ports "PMOD1_LS[2]"] ;# Bank  47 VCCO - VCC1V2_FPGA - IO_L4P_T0U_N6_DBC_AD7P_47
#set_property IOSTANDARD  LVCMOS12 [get_ports "PMOD1_LS[2]"] ;# Bank  47 VCCO - VCC1V2_FPGA - IO_L4P_T0U_N6_DBC_AD7P_47
#set_property PACKAGE_PIN P30      [get_ports "PMOD1_LS[3]"] ;# Bank  47 VCCO - VCC1V2_FPGA - IO_L3N_T0L_N5_AD15N_47
#set_property IOSTANDARD  LVCMOS12 [get_ports "PMOD1_LS[3]"] ;# Bank  47 VCCO - VCC1V2_FPGA - IO_L3N_T0L_N5_AD15N_47
#set_property PACKAGE_PIN P29      [get_ports "PMOD1_LS[4]"] ;# Bank  47 VCCO - VCC1V2_FPGA - IO_L3P_T0L_N4_AD15P_47
#set_property IOSTANDARD  LVCMOS12 [get_ports "PMOD1_LS[4]"] ;# Bank  47 VCCO - VCC1V2_FPGA - IO_L3P_T0L_N4_AD15P_47
#set_property PACKAGE_PIN L31      [get_ports "PMOD1_LS[5]"] ;# Bank  47 VCCO - VCC1V2_FPGA - IO_L2N_T0L_N3_47
#set_property IOSTANDARD  LVCMOS12 [get_ports "PMOD1_LS[5]"] ;# Bank  47 VCCO - VCC1V2_FPGA - IO_L2N_T0L_N3_47
#set_property PACKAGE_PIN M31      [get_ports "PMOD1_LS[6]"] ;# Bank  47 VCCO - VCC1V2_FPGA - IO_L2P_T0L_N2_47
#set_property IOSTANDARD  LVCMOS12 [get_ports "PMOD1_LS[6]"] ;# Bank  47 VCCO - VCC1V2_FPGA - IO_L2P_T0L_N2_47
#set_property PACKAGE_PIN R29      [get_ports "PMOD1_LS[7]"] ;# Bank  47 VCCO - VCC1V2_FPGA - IO_L1N_T0L_N1_DBC_47
#set_property IOSTANDARD  LVCMOS12 [get_ports "PMOD1_LS[7]"] ;# Bank  47 VCCO - VCC1V2_FPGA - IO_L1N_T0L_N1_DBC_47
#set_property PACKAGE_PIN R28      [get_ports "RLD3_C3_72B_A20"] ;# Bank  47 VCCO - VCC1V2_FPGA - IO_L1P_T0L_N0_DBC_47
#set_property IOSTANDARD  SSTL12 [get_ports "RLD3_C3_72B_A20"] ;# Bank  47 VCCO - VCC1V2_FPGA - IO_L1P_T0L_N0_DBC_47
##Other net   PACKAGE_PIN T28      - 43N2999                   Bank  47 - VREF_47
#set_property PACKAGE_PIN A35      [get_ports "RLD3_C3_72B_DM1"] ;# Bank  46 VCCO - VCC1V2_FPGA - IO_L24N_T3U_N11_46
#set_property IOSTANDARD  SSTL12 [get_ports "RLD3_C3_72B_DM1"] ;# Bank  46 VCCO - VCC1V2_FPGA - IO_L24N_T3U_N11_46
#set_property PACKAGE_PIN A34      [get_ports "RLD3_C3_72B_DQ35"] ;# Bank  46 VCCO - VCC1V2_FPGA - IO_L24P_T3U_N10_46
#set_property IOSTANDARD  SSTL12 [get_ports "RLD3_C3_72B_DQ35"] ;# Bank  46 VCCO - VCC1V2_FPGA - IO_L24P_T3U_N10_46
#set_property PACKAGE_PIN A36      [get_ports "RLD3_C3_72B_DQ34"] ;# Bank  46 VCCO - VCC1V2_FPGA - IO_L23N_T3U_N9_46
#set_property IOSTANDARD  SSTL12 [get_ports "RLD3_C3_72B_DQ34"] ;# Bank  46 VCCO - VCC1V2_FPGA - IO_L23N_T3U_N9_46
#set_property PACKAGE_PIN B35      [get_ports "RLD3_C3_72B_DQ33"] ;# Bank  46 VCCO - VCC1V2_FPGA - IO_L23P_T3U_N8_46
#set_property IOSTANDARD  SSTL12 [get_ports "RLD3_C3_72B_DQ33"] ;# Bank  46 VCCO - VCC1V2_FPGA - IO_L23P_T3U_N8_46
#set_property PACKAGE_PIN B37      [get_ports "RLD3_C3_72B_DQ32"] ;# Bank  46 VCCO - VCC1V2_FPGA - IO_L22N_T3U_N7_DBC_AD0N_46
#set_property IOSTANDARD  SSTL12 [get_ports "RLD3_C3_72B_DQ32"] ;# Bank  46 VCCO - VCC1V2_FPGA - IO_L22N_T3U_N7_DBC_AD0N_46
#set_property PACKAGE_PIN B36      [get_ports "RLD3_C3_72B_DQ31"] ;# Bank  46 VCCO - VCC1V2_FPGA - IO_L22P_T3U_N6_DBC_AD0P_46
#set_property IOSTANDARD  SSTL12 [get_ports "RLD3_C3_72B_DQ31"] ;# Bank  46 VCCO - VCC1V2_FPGA - IO_L22P_T3U_N6_DBC_AD0P_46
#set_property PACKAGE_PIN C34      [get_ports "RLD3_C3_72B_DQ30"] ;# Bank  46 VCCO - VCC1V2_FPGA - IO_L21N_T3L_N5_AD8N_46
#set_property IOSTANDARD  SSTL12 [get_ports "RLD3_C3_72B_DQ30"] ;# Bank  46 VCCO - VCC1V2_FPGA - IO_L21N_T3L_N5_AD8N_46
#set_property PACKAGE_PIN D34      [get_ports "RLD3_C3_72B_DQ29"] ;# Bank  46 VCCO - VCC1V2_FPGA - IO_L21P_T3L_N4_AD8P_46
#set_property IOSTANDARD  SSTL12 [get_ports "RLD3_C3_72B_DQ29"] ;# Bank  46 VCCO - VCC1V2_FPGA - IO_L21P_T3L_N4_AD8P_46
#set_property PACKAGE_PIN C35      [get_ports "RLD3_C3_72B_DQ28"] ;# Bank  46 VCCO - VCC1V2_FPGA - IO_L20N_T3L_N3_AD1N_46
#set_property IOSTANDARD  SSTL12 [get_ports "RLD3_C3_72B_DQ28"] ;# Bank  46 VCCO - VCC1V2_FPGA - IO_L20N_T3L_N3_AD1N_46
#set_property PACKAGE_PIN D35      [get_ports "RLD3_C3_72B_DQ27"] ;# Bank  46 VCCO - VCC1V2_FPGA - IO_L20P_T3L_N2_AD1P_46
#set_property IOSTANDARD  SSTL12 [get_ports "RLD3_C3_72B_DQ27"] ;# Bank  46 VCCO - VCC1V2_FPGA - IO_L20P_T3L_N2_AD1P_46
#set_property PACKAGE_PIN C37      [get_ports "RLD3_C3_72B_QK3_N"] ;# Bank  46 VCCO - VCC1V2_FPGA - IO_L19N_T3L_N1_DBC_AD9N_46
#set_property IOSTANDARD  DIFF_SSTL12 [get_ports "RLD3_C3_72B_QK3_N"] ;# Bank  46 VCCO - VCC1V2_FPGA - IO_L19N_T3L_N1_DBC_AD9N_46
#set_property PACKAGE_PIN D37      [get_ports "RLD3_C3_72B_QK3_P"] ;# Bank  46 VCCO - VCC1V2_FPGA - IO_L19P_T3L_N0_DBC_AD9P_46
#set_property IOSTANDARD  DIFF_SSTL12 [get_ports "RLD3_C3_72B_QK3_P"] ;# Bank  46 VCCO - VCC1V2_FPGA - IO_L19P_T3L_N0_DBC_AD9P_46
##set_property PACKAGE_PIN D36      [get_ports ""] ;# Bank  46 VCCO - VCC1V2_FPGA - IO_T3U_N12_46
##set_property IOSTANDARD  LVCMOSxx [get_ports ""] ;# Bank  46 VCCO - VCC1V2_FPGA - IO_T3U_N12_46
##set_property PACKAGE_PIN C38      [get_ports ""] ;# Bank  46 VCCO - VCC1V2_FPGA - IO_T2U_N12_46
##set_property IOSTANDARD  LVCMOSxx [get_ports ""] ;# Bank  46 VCCO - VCC1V2_FPGA - IO_T2U_N12_46
#set_property PACKAGE_PIN A38      [get_ports "RLD3_C3_72B_QVLD1"] ;# Bank  46 VCCO - VCC1V2_FPGA - IO_L18N_T2U_N11_AD2N_46
#set_property IOSTANDARD  SSTL12 [get_ports "RLD3_C3_72B_QVLD1"] ;# Bank  46 VCCO - VCC1V2_FPGA - IO_L18N_T2U_N11_AD2N_46
#set_property PACKAGE_PIN B38      [get_ports "RLD3_C3_72B_DQ26"] ;# Bank  46 VCCO - VCC1V2_FPGA - IO_L18P_T2U_N10_AD2P_46
#set_property IOSTANDARD  SSTL12 [get_ports "RLD3_C3_72B_DQ26"] ;# Bank  46 VCCO - VCC1V2_FPGA - IO_L18P_T2U_N10_AD2P_46
#set_property PACKAGE_PIN C40      [get_ports "RLD3_C3_72B_DQ25"] ;# Bank  46 VCCO - VCC1V2_FPGA - IO_L17N_T2U_N9_AD10N_46
#set_property IOSTANDARD  SSTL12 [get_ports "RLD3_C3_72B_DQ25"] ;# Bank  46 VCCO - VCC1V2_FPGA - IO_L17N_T2U_N9_AD10N_46
#set_property PACKAGE_PIN D40      [get_ports "RLD3_C3_72B_DQ24"] ;# Bank  46 VCCO - VCC1V2_FPGA - IO_L17P_T2U_N8_AD10P_46
#set_property IOSTANDARD  SSTL12 [get_ports "RLD3_C3_72B_DQ24"] ;# Bank  46 VCCO - VCC1V2_FPGA - IO_L17P_T2U_N8_AD10P_46
#set_property PACKAGE_PIN A40      [get_ports "RLD3_C3_72B_DQ23"] ;# Bank  46 VCCO - VCC1V2_FPGA - IO_L16N_T2U_N7_QBC_AD3N_46
#set_property IOSTANDARD  SSTL12 [get_ports "RLD3_C3_72B_DQ23"] ;# Bank  46 VCCO - VCC1V2_FPGA - IO_L16N_T2U_N7_QBC_AD3N_46
#set_property PACKAGE_PIN A39      [get_ports "RLD3_C3_72B_DQ22"] ;# Bank  46 VCCO - VCC1V2_FPGA - IO_L16P_T2U_N6_QBC_AD3P_46
#set_property IOSTANDARD  SSTL12 [get_ports "RLD3_C3_72B_DQ22"] ;# Bank  46 VCCO - VCC1V2_FPGA - IO_L16P_T2U_N6_QBC_AD3P_46
#set_property PACKAGE_PIN B40      [get_ports "RLD3_C3_72B_DQ21"] ;# Bank  46 VCCO - VCC1V2_FPGA - IO_L15N_T2L_N5_AD11N_46
#set_property IOSTANDARD  SSTL12 [get_ports "RLD3_C3_72B_DQ21"] ;# Bank  46 VCCO - VCC1V2_FPGA - IO_L15N_T2L_N5_AD11N_46
#set_property PACKAGE_PIN C39      [get_ports "RLD3_C3_72B_DQ20"] ;# Bank  46 VCCO - VCC1V2_FPGA - IO_L15P_T2L_N4_AD11P_46
#set_property IOSTANDARD  SSTL12 [get_ports "RLD3_C3_72B_DQ20"] ;# Bank  46 VCCO - VCC1V2_FPGA - IO_L15P_T2L_N4_AD11P_46
#set_property PACKAGE_PIN E38      [get_ports "RLD3_C3_72B_DQ19"] ;# Bank  46 VCCO - VCC1V2_FPGA - IO_L14N_T2L_N3_GC_46
#set_property IOSTANDARD  SSTL12 [get_ports "RLD3_C3_72B_DQ19"] ;# Bank  46 VCCO - VCC1V2_FPGA - IO_L14N_T2L_N3_GC_46
#set_property PACKAGE_PIN E37      [get_ports "RLD3_C3_72B_DQ18"] ;# Bank  46 VCCO - VCC1V2_FPGA - IO_L14P_T2L_N2_GC_46
#set_property IOSTANDARD  SSTL12 [get_ports "RLD3_C3_72B_DQ18"] ;# Bank  46 VCCO - VCC1V2_FPGA - IO_L14P_T2L_N2_GC_46
#set_property PACKAGE_PIN D39      [get_ports "RLD3_C3_72B_QK2_N"] ;# Bank  46 VCCO - VCC1V2_FPGA - IO_L13N_T2L_N1_GC_QBC_46
#set_property IOSTANDARD  DIFF_SSTL12 [get_ports "RLD3_C3_72B_QK2_N"] ;# Bank  46 VCCO - VCC1V2_FPGA - IO_L13N_T2L_N1_GC_QBC_46
#set_property PACKAGE_PIN E39      [get_ports "RLD3_C3_72B_QK2_P"] ;# Bank  46 VCCO - VCC1V2_FPGA - IO_L13P_T2L_N0_GC_QBC_46
#set_property IOSTANDARD  DIFF_SSTL12 [get_ports "RLD3_C3_72B_QK2_P"] ;# Bank  46 VCCO - VCC1V2_FPGA - IO_L13P_T2L_N0_GC_QBC_46
#set_property PACKAGE_PIN G37      [get_ports "RLD3_C3_72B_QVLD0"] ;# Bank  46 VCCO - VCC1V2_FPGA - IO_L12N_T1U_N11_GC_46
#set_property IOSTANDARD  SSTL12 [get_ports "RLD3_C3_72B_QVLD0"] ;# Bank  46 VCCO - VCC1V2_FPGA - IO_L12N_T1U_N11_GC_46
#set_property PACKAGE_PIN G36      [get_ports "RLD3_C3_72B_DQ17"] ;# Bank  46 VCCO - VCC1V2_FPGA - IO_L12P_T1U_N10_GC_46
#set_property IOSTANDARD  SSTL12 [get_ports "RLD3_C3_72B_DQ17"] ;# Bank  46 VCCO - VCC1V2_FPGA - IO_L12P_T1U_N10_GC_46
#set_property PACKAGE_PIN F36      [get_ports "RLD3_C3_72B_DQ16"] ;# Bank  46 VCCO - VCC1V2_FPGA - IO_L11N_T1U_N9_GC_46
#set_property IOSTANDARD  SSTL12 [get_ports "RLD3_C3_72B_DQ16"] ;# Bank  46 VCCO - VCC1V2_FPGA - IO_L11N_T1U_N9_GC_46
#set_property PACKAGE_PIN F35      [get_ports "RLD3_C3_72B_DQ15"] ;# Bank  46 VCCO - VCC1V2_FPGA - IO_L11P_T1U_N8_GC_46
#set_property IOSTANDARD  SSTL12 [get_ports "RLD3_C3_72B_DQ15"] ;# Bank  46 VCCO - VCC1V2_FPGA - IO_L11P_T1U_N8_GC_46
#set_property PACKAGE_PIN G35      [get_ports "RLD3_C3_72B_DQ14"] ;# Bank  46 VCCO - VCC1V2_FPGA - IO_L10N_T1U_N7_QBC_AD4N_46
#set_property IOSTANDARD  SSTL12 [get_ports "RLD3_C3_72B_DQ14"] ;# Bank  46 VCCO - VCC1V2_FPGA - IO_L10N_T1U_N7_QBC_AD4N_46
#set_property PACKAGE_PIN H34      [get_ports "RLD3_C3_72B_DQ13"] ;# Bank  46 VCCO - VCC1V2_FPGA - IO_L10P_T1U_N6_QBC_AD4P_46
#set_property IOSTANDARD  SSTL12 [get_ports "RLD3_C3_72B_DQ13"] ;# Bank  46 VCCO - VCC1V2_FPGA - IO_L10P_T1U_N6_QBC_AD4P_46
#set_property PACKAGE_PIN H37      [get_ports "RLD3_C3_72B_DQ12"] ;# Bank  46 VCCO - VCC1V2_FPGA - IO_L9N_T1L_N5_AD12N_46
#set_property IOSTANDARD  SSTL12 [get_ports "RLD3_C3_72B_DQ12"] ;# Bank  46 VCCO - VCC1V2_FPGA - IO_L9N_T1L_N5_AD12N_46
#set_property PACKAGE_PIN J36      [get_ports "RLD3_C3_72B_DQ11"] ;# Bank  46 VCCO - VCC1V2_FPGA - IO_L9P_T1L_N4_AD12P_46
#set_property IOSTANDARD  SSTL12 [get_ports "RLD3_C3_72B_DQ11"] ;# Bank  46 VCCO - VCC1V2_FPGA - IO_L9P_T1L_N4_AD12P_46
#set_property PACKAGE_PIN H35      [get_ports "RLD3_C3_72B_DQ10"] ;# Bank  46 VCCO - VCC1V2_FPGA - IO_L8N_T1L_N3_AD5N_46
#set_property IOSTANDARD  SSTL12 [get_ports "RLD3_C3_72B_DQ10"] ;# Bank  46 VCCO - VCC1V2_FPGA - IO_L8N_T1L_N3_AD5N_46
#set_property PACKAGE_PIN J35      [get_ports "RLD3_C3_72B_DQ9"] ;# Bank  46 VCCO - VCC1V2_FPGA - IO_L8P_T1L_N2_AD5P_46
#set_property IOSTANDARD  SSTL12 [get_ports "RLD3_C3_72B_DQ9"] ;# Bank  46 VCCO - VCC1V2_FPGA - IO_L8P_T1L_N2_AD5P_46
#set_property PACKAGE_PIN E34      [get_ports "RLD3_C3_72B_QK1_N"] ;# Bank  46 VCCO - VCC1V2_FPGA - IO_L7N_T1L_N1_QBC_AD13N_46
#set_property IOSTANDARD  DIFF_SSTL12 [get_ports "RLD3_C3_72B_QK1_N"] ;# Bank  46 VCCO - VCC1V2_FPGA - IO_L7N_T1L_N1_QBC_AD13N_46
#set_property PACKAGE_PIN F34      [get_ports "RLD3_C3_72B_QK1_P"] ;# Bank  46 VCCO - VCC1V2_FPGA - IO_L7P_T1L_N0_QBC_AD13P_46
#set_property IOSTANDARD  DIFF_SSTL12 [get_ports "RLD3_C3_72B_QK1_P"] ;# Bank  46 VCCO - VCC1V2_FPGA - IO_L7P_T1L_N0_QBC_AD13P_46
##set_property PACKAGE_PIN E36      [get_ports ""] ;# Bank  46 VCCO - VCC1V2_FPGA - IO_T1U_N12_46
##set_property IOSTANDARD  LVCMOSxx [get_ports ""] ;# Bank  46 VCCO - VCC1V2_FPGA - IO_T1U_N12_46
##set_property PACKAGE_PIN K38      [get_ports "VRP_46"] ;# Bank  46 VCCO - VCC1V2_FPGA - IO_T0U_N12_VRP_46
##set_property IOSTANDARD  LVCMOSxx [get_ports "VRP_46"] ;# Bank  46 VCCO - VCC1V2_FPGA - IO_T0U_N12_VRP_46
#set_property PACKAGE_PIN F39      [get_ports "RLD3_C3_72B_DM0"] ;# Bank  46 VCCO - VCC1V2_FPGA - IO_L6N_T0U_N11_AD6N_46
#set_property IOSTANDARD  SSTL12 [get_ports "RLD3_C3_72B_DM0"] ;# Bank  46 VCCO - VCC1V2_FPGA - IO_L6N_T0U_N11_AD6N_46
#set_property PACKAGE_PIN F38      [get_ports "RLD3_C3_72B_DQ8"] ;# Bank  46 VCCO - VCC1V2_FPGA - IO_L6P_T0U_N10_AD6P_46
#set_property IOSTANDARD  SSTL12 [get_ports "RLD3_C3_72B_DQ8"] ;# Bank  46 VCCO - VCC1V2_FPGA - IO_L6P_T0U_N10_AD6P_46
#set_property PACKAGE_PIN J37      [get_ports "RLD3_C3_72B_DQ7"] ;# Bank  46 VCCO - VCC1V2_FPGA - IO_L5N_T0U_N9_AD14N_46
#set_property IOSTANDARD  SSTL12 [get_ports "RLD3_C3_72B_DQ7"] ;# Bank  46 VCCO - VCC1V2_FPGA - IO_L5N_T0U_N9_AD14N_46
#set_property PACKAGE_PIN K37      [get_ports "RLD3_C3_72B_DQ6"] ;# Bank  46 VCCO - VCC1V2_FPGA - IO_L5P_T0U_N8_AD14P_46
#set_property IOSTANDARD  SSTL12 [get_ports "RLD3_C3_72B_DQ6"] ;# Bank  46 VCCO - VCC1V2_FPGA - IO_L5P_T0U_N8_AD14P_46
#set_property PACKAGE_PIN G38      [get_ports "RLD3_C3_72B_DQ5"] ;# Bank  46 VCCO - VCC1V2_FPGA - IO_L4N_T0U_N7_DBC_AD7N_46
#set_property IOSTANDARD  SSTL12 [get_ports "RLD3_C3_72B_DQ5"] ;# Bank  46 VCCO - VCC1V2_FPGA - IO_L4N_T0U_N7_DBC_AD7N_46
#set_property PACKAGE_PIN H38      [get_ports "RLD3_C3_72B_DQ4"] ;# Bank  46 VCCO - VCC1V2_FPGA - IO_L4P_T0U_N6_DBC_AD7P_46
#set_property IOSTANDARD  SSTL12 [get_ports "RLD3_C3_72B_DQ4"] ;# Bank  46 VCCO - VCC1V2_FPGA - IO_L4P_T0U_N6_DBC_AD7P_46
#set_property PACKAGE_PIN F40      [get_ports "RLD3_C3_72B_DQ3"] ;# Bank  46 VCCO - VCC1V2_FPGA - IO_L3N_T0L_N5_AD15N_46
#set_property IOSTANDARD  SSTL12 [get_ports "RLD3_C3_72B_DQ3"] ;# Bank  46 VCCO - VCC1V2_FPGA - IO_L3N_T0L_N5_AD15N_46
#set_property PACKAGE_PIN G40      [get_ports "RLD3_C3_72B_DQ2"] ;# Bank  46 VCCO - VCC1V2_FPGA - IO_L3P_T0L_N4_AD15P_46
#set_property IOSTANDARD  SSTL12 [get_ports "RLD3_C3_72B_DQ2"] ;# Bank  46 VCCO - VCC1V2_FPGA - IO_L3P_T0L_N4_AD15P_46
#set_property PACKAGE_PIN H40      [get_ports "RLD3_C3_72B_DQ1"] ;# Bank  46 VCCO - VCC1V2_FPGA - IO_L2N_T0L_N3_46
#set_property IOSTANDARD  SSTL12 [get_ports "RLD3_C3_72B_DQ1"] ;# Bank  46 VCCO - VCC1V2_FPGA - IO_L2N_T0L_N3_46
#set_property PACKAGE_PIN H39      [get_ports "RLD3_C3_72B_DQ0"] ;# Bank  46 VCCO - VCC1V2_FPGA - IO_L2P_T0L_N2_46
#set_property IOSTANDARD  SSTL12 [get_ports "RLD3_C3_72B_DQ0"] ;# Bank  46 VCCO - VCC1V2_FPGA - IO_L2P_T0L_N2_46
#set_property PACKAGE_PIN J40      [get_ports "RLD3_C3_72B_QK0_N"] ;# Bank  46 VCCO - VCC1V2_FPGA - IO_L1N_T0L_N1_DBC_46
#set_property IOSTANDARD  DIFF_SSTL12 [get_ports "RLD3_C3_72B_QK0_N"] ;# Bank  46 VCCO - VCC1V2_FPGA - IO_L1N_T0L_N1_DBC_46
#set_property PACKAGE_PIN J39      [get_ports "RLD3_C3_72B_QK0_P"] ;# Bank  46 VCCO - VCC1V2_FPGA - IO_L1P_T0L_N0_DBC_46
#set_property IOSTANDARD  DIFF_SSTL12 [get_ports "RLD3_C3_72B_QK0_P"] ;# Bank  46 VCCO - VCC1V2_FPGA - IO_L1P_T0L_N0_DBC_46
##Other net   PACKAGE_PIN J34      -                  Bank  46 - VREF_46
#set_property PACKAGE_PIN L35      [get_ports "FMCP_HSPC_LA21_N"] ;# Bank  45 VCCO - VADJ_1V8_FPGA - IO_L24N_T3U_N11_45
#set_property IOSTANDARD  LVDS [get_ports "FMCP_HSPC_LA21_N"] ;# Bank  45 VCCO - VADJ_1V8_FPGA - IO_L24N_T3U_N11_45
#set_property PACKAGE_PIN M35      [get_ports "FMCP_HSPC_LA21_P"] ;# Bank  45 VCCO - VADJ_1V8_FPGA - IO_L24P_T3U_N10_45
#set_property IOSTANDARD  LVDS [get_ports "FMCP_HSPC_LA21_P"] ;# Bank  45 VCCO - VADJ_1V8_FPGA - IO_L24P_T3U_N10_45
#set_property PACKAGE_PIN M32      [get_ports "FMCP_HSPC_LA20_N"] ;# Bank  45 VCCO - VADJ_1V8_FPGA - IO_L23N_T3U_N9_45
#set_property IOSTANDARD  LVDS [get_ports "FMCP_HSPC_LA20_N"] ;# Bank  45 VCCO - VADJ_1V8_FPGA - IO_L23N_T3U_N9_45
#set_property PACKAGE_PIN N32      [get_ports "FMCP_HSPC_LA20_P"] ;# Bank  45 VCCO - VADJ_1V8_FPGA - IO_L23P_T3U_N8_45
#set_property IOSTANDARD  LVDS [get_ports "FMCP_HSPC_LA20_P"] ;# Bank  45 VCCO - VADJ_1V8_FPGA - IO_L23P_T3U_N8_45
#set_property PACKAGE_PIN M33      [get_ports "FMCP_HSPC_LA19_N"] ;# Bank  45 VCCO - VADJ_1V8_FPGA - IO_L22N_T3U_N7_DBC_AD0N_45
#set_property IOSTANDARD  LVDS [get_ports "FMCP_HSPC_LA19_N"] ;# Bank  45 VCCO - VADJ_1V8_FPGA - IO_L22N_T3U_N7_DBC_AD0N_45
#set_property PACKAGE_PIN N33      [get_ports "FMCP_HSPC_LA19_P"] ;# Bank  45 VCCO - VADJ_1V8_FPGA - IO_L22P_T3U_N6_DBC_AD0P_45
#set_property IOSTANDARD  LVDS [get_ports "FMCP_HSPC_LA19_P"] ;# Bank  45 VCCO - VADJ_1V8_FPGA - IO_L22P_T3U_N6_DBC_AD0P_45
#set_property PACKAGE_PIN K33      [get_ports "FMCP_HSPC_LA32_N"] ;# Bank  45 VCCO - VADJ_1V8_FPGA - IO_L21N_T3L_N5_AD8N_45
#set_property IOSTANDARD  LVDS [get_ports "FMCP_HSPC_LA32_N"] ;# Bank  45 VCCO - VADJ_1V8_FPGA - IO_L21N_T3L_N5_AD8N_45
#set_property PACKAGE_PIN L33      [get_ports "FMCP_HSPC_LA32_P"] ;# Bank  45 VCCO - VADJ_1V8_FPGA - IO_L21P_T3L_N4_AD8P_45
#set_property IOSTANDARD  LVDS [get_ports "FMCP_HSPC_LA32_P"] ;# Bank  45 VCCO - VADJ_1V8_FPGA - IO_L21P_T3L_N4_AD8P_45
#set_property PACKAGE_PIN N35      [get_ports "FMCP_HSPC_LA22_N"] ;# Bank  45 VCCO - VADJ_1V8_FPGA - IO_L20N_T3L_N3_AD1N_45
#set_property IOSTANDARD  LVDS [get_ports "FMCP_HSPC_LA22_N"] ;# Bank  45 VCCO - VADJ_1V8_FPGA - IO_L20N_T3L_N3_AD1N_45
#set_property PACKAGE_PIN N34      [get_ports "FMCP_HSPC_LA22_P"] ;# Bank  45 VCCO - VADJ_1V8_FPGA - IO_L20P_T3L_N2_AD1P_45
#set_property IOSTANDARD  LVDS [get_ports "FMCP_HSPC_LA22_P"] ;# Bank  45 VCCO - VADJ_1V8_FPGA - IO_L20P_T3L_N2_AD1P_45
#set_property PACKAGE_PIN K34      [get_ports "FMCP_HSPC_LA33_N"] ;# Bank  45 VCCO - VADJ_1V8_FPGA - IO_L19N_T3L_N1_DBC_AD9N_45
#set_property IOSTANDARD  LVDS [get_ports "FMCP_HSPC_LA33_N"] ;# Bank  45 VCCO - VADJ_1V8_FPGA - IO_L19N_T3L_N1_DBC_AD9N_45
#set_property PACKAGE_PIN L34      [get_ports "FMCP_HSPC_LA33_P"] ;# Bank  45 VCCO - VADJ_1V8_FPGA - IO_L19P_T3L_N0_DBC_AD9P_45
#set_property IOSTANDARD  LVDS [get_ports "FMCP_HSPC_LA33_P"] ;# Bank  45 VCCO - VADJ_1V8_FPGA - IO_L19P_T3L_N0_DBC_AD9P_45
##set_property PACKAGE_PIN K36      [get_ports ""] ;# Bank  45 VCCO - VADJ_1V8_FPGA - IO_T3U_N12_45
##set_property IOSTANDARD  LVCMOSxx [get_ports ""] ;# Bank  45 VCCO - VADJ_1V8_FPGA - IO_T3U_N12_45
##set_property PACKAGE_PIN R36      [get_ports ""] ;# Bank  45 VCCO - VADJ_1V8_FPGA - IO_T2U_N12_45
##set_property IOSTANDARD  LVCMOSxx [get_ports ""] ;# Bank  45 VCCO - VADJ_1V8_FPGA - IO_T2U_N12_45
#set_property PACKAGE_PIN M38      [get_ports "FMCP_HSPC_LA30_N"] ;# Bank  45 VCCO - VADJ_1V8_FPGA - IO_L18N_T2U_N11_AD2N_45
#set_property IOSTANDARD  LVDS [get_ports "FMCP_HSPC_LA30_N"] ;# Bank  45 VCCO - VADJ_1V8_FPGA - IO_L18N_T2U_N11_AD2N_45
#set_property PACKAGE_PIN N38      [get_ports "FMCP_HSPC_LA30_P"] ;# Bank  45 VCCO - VADJ_1V8_FPGA - IO_L18P_T2U_N10_AD2P_45
#set_property IOSTANDARD  LVDS [get_ports "FMCP_HSPC_LA30_P"] ;# Bank  45 VCCO - VADJ_1V8_FPGA - IO_L18P_T2U_N10_AD2P_45
#set_property PACKAGE_PIN L36      [get_ports "FMCP_HSPC_LA28_N"] ;# Bank  45 VCCO - VADJ_1V8_FPGA - IO_L17N_T2U_N9_AD10N_45
#set_property IOSTANDARD  LVDS [get_ports "FMCP_HSPC_LA28_N"] ;# Bank  45 VCCO - VADJ_1V8_FPGA - IO_L17N_T2U_N9_AD10N_45
#set_property PACKAGE_PIN M36      [get_ports "FMCP_HSPC_LA28_P"] ;# Bank  45 VCCO - VADJ_1V8_FPGA - IO_L17P_T2U_N8_AD10P_45
#set_property IOSTANDARD  LVDS [get_ports "FMCP_HSPC_LA28_P"] ;# Bank  45 VCCO - VADJ_1V8_FPGA - IO_L17P_T2U_N8_AD10P_45
#set_property PACKAGE_PIN N37      [get_ports "FMCP_HSPC_LA31_N"] ;# Bank  45 VCCO - VADJ_1V8_FPGA - IO_L16N_T2U_N7_QBC_AD3N_45
#set_property IOSTANDARD  LVDS [get_ports "FMCP_HSPC_LA31_N"] ;# Bank  45 VCCO - VADJ_1V8_FPGA - IO_L16N_T2U_N7_QBC_AD3N_45
#set_property PACKAGE_PIN P37      [get_ports "FMCP_HSPC_LA31_P"] ;# Bank  45 VCCO - VADJ_1V8_FPGA - IO_L16P_T2U_N6_QBC_AD3P_45
#set_property IOSTANDARD  LVDS [get_ports "FMCP_HSPC_LA31_P"] ;# Bank  45 VCCO - VADJ_1V8_FPGA - IO_L16P_T2U_N6_QBC_AD3P_45
##set_property PACKAGE_PIN L38      [get_ports ""] ;# Bank  45 VCCO - VADJ_1V8_FPGA - IO_L15N_T2L_N5_AD11N_45
##set_property IOSTANDARD  LVCMOSxx [get_ports ""] ;# Bank  45 VCCO - VADJ_1V8_FPGA - IO_L15N_T2L_N5_AD11N_45
##set_property PACKAGE_PIN M37      [get_ports ""] ;# Bank  45 VCCO - VADJ_1V8_FPGA - IO_L15P_T2L_N4_AD11P_45
##set_property IOSTANDARD  LVCMOSxx [get_ports ""] ;# Bank  45 VCCO - VADJ_1V8_FPGA - IO_L15P_T2L_N4_AD11P_45
#set_property PACKAGE_PIN P36      [get_ports "FMCP_HSPC_CLK1_M2C_N"] ;# Bank  45 VCCO - VADJ_1V8_FPGA - IO_L14N_T2L_N3_GC_45
#set_property IOSTANDARD  LVDS [get_ports "FMCP_HSPC_CLK1_M2C_N"] ;# Bank  45 VCCO - VADJ_1V8_FPGA - IO_L14N_T2L_N3_GC_45
#set_property PACKAGE_PIN P35      [get_ports "FMCP_HSPC_CLK1_M2C_P"] ;# Bank  45 VCCO - VADJ_1V8_FPGA - IO_L14P_T2L_N2_GC_45
#set_property IOSTANDARD  LVDS [get_ports "FMCP_HSPC_CLK1_M2C_P"] ;# Bank  45 VCCO - VADJ_1V8_FPGA - IO_L14P_T2L_N2_GC_45
#set_property PACKAGE_PIN P34      [get_ports "FMCP_HSPC_LA17_CC_N"] ;# Bank  45 VCCO - VADJ_1V8_FPGA - IO_L13N_T2L_N1_GC_QBC_45
#set_property IOSTANDARD  LVDS [get_ports "FMCP_HSPC_LA17_CC_N"] ;# Bank  45 VCCO - VADJ_1V8_FPGA - IO_L13N_T2L_N1_GC_QBC_45
#set_property PACKAGE_PIN R34      [get_ports "FMCP_HSPC_LA17_CC_P"] ;# Bank  45 VCCO - VADJ_1V8_FPGA - IO_L13P_T2L_N0_GC_QBC_45
#set_property IOSTANDARD  LVDS [get_ports "FMCP_HSPC_LA17_CC_P"] ;# Bank  45 VCCO - VADJ_1V8_FPGA - IO_L13P_T2L_N0_GC_QBC_45
##set_property PACKAGE_PIN R33      [get_ports ""] ;# Bank  45 VCCO - VADJ_1V8_FPGA - IO_L12N_T1U_N11_GC_45
##set_property IOSTANDARD  LVCMOSxx [get_ports ""] ;# Bank  45 VCCO - VADJ_1V8_FPGA - IO_L12N_T1U_N11_GC_45
##set_property PACKAGE_PIN T33      [get_ports ""] ;# Bank  45 VCCO - VADJ_1V8_FPGA - IO_L12P_T1U_N10_GC_45
##set_property IOSTANDARD  LVCMOSxx [get_ports ""] ;# Bank  45 VCCO - VADJ_1V8_FPGA - IO_L12P_T1U_N10_GC_45
#set_property PACKAGE_PIN P32      [get_ports "USER_SMA_CLOCK_N"] ;# Bank  45 VCCO - VADJ_1V8_FPGA - IO_L11N_T1U_N9_GC_45
#set_property IOSTANDARD  LVDS [get_ports "USER_SMA_CLOCK_N"] ;# Bank  45 VCCO - VADJ_1V8_FPGA - IO_L11N_T1U_N9_GC_45
#set_property PACKAGE_PIN R32      [get_ports "USER_SMA_CLOCK_P"] ;# Bank  45 VCCO - VADJ_1V8_FPGA - IO_L11P_T1U_N8_GC_45
#set_property IOSTANDARD  LVDS [get_ports "USER_SMA_CLOCK_P"] ;# Bank  45 VCCO - VADJ_1V8_FPGA - IO_L11P_T1U_N8_GC_45
#set_property PACKAGE_PIN P31      [get_ports "FMCP_HSPC_LA18_CC_N"] ;# Bank  45 VCCO - VADJ_1V8_FPGA - IO_L10N_T1U_N7_QBC_AD4N_45
#set_property IOSTANDARD  LVDS [get_ports "FMCP_HSPC_LA18_CC_N"] ;# Bank  45 VCCO - VADJ_1V8_FPGA - IO_L10N_T1U_N7_QBC_AD4N_45
#set_property PACKAGE_PIN R31      [get_ports "FMCP_HSPC_LA18_CC_P"] ;# Bank  45 VCCO - VADJ_1V8_FPGA - IO_L10P_T1U_N6_QBC_AD4P_45
#set_property IOSTANDARD  LVDS [get_ports "FMCP_HSPC_LA18_CC_P"] ;# Bank  45 VCCO - VADJ_1V8_FPGA - IO_L10P_T1U_N6_QBC_AD4P_45
##set_property PACKAGE_PIN W31      [get_ports ""] ;# Bank  45 VCCO - VADJ_1V8_FPGA - IO_L9N_T1L_N5_AD12N_45
##set_property IOSTANDARD  LVCMOSxx [get_ports ""] ;# Bank  45 VCCO - VADJ_1V8_FPGA - IO_L9N_T1L_N5_AD12N_45
##set_property PACKAGE_PIN Y31      [get_ports ""] ;# Bank  45 VCCO - VADJ_1V8_FPGA - IO_L9P_T1L_N4_AD12P_45
##set_property IOSTANDARD  LVCMOSxx [get_ports ""] ;# Bank  45 VCCO - VADJ_1V8_FPGA - IO_L9P_T1L_N4_AD12P_45
##set_property PACKAGE_PIN U32      [get_ports ""] ;# Bank  45 VCCO - VADJ_1V8_FPGA - IO_L8N_T1L_N3_AD5N_45
##set_property IOSTANDARD  LVCMOSxx [get_ports ""] ;# Bank  45 VCCO - VADJ_1V8_FPGA - IO_L8N_T1L_N3_AD5N_45
##set_property PACKAGE_PIN U31      [get_ports ""] ;# Bank  45 VCCO - VADJ_1V8_FPGA - IO_L8P_T1L_N2_AD5P_45
##set_property IOSTANDARD  LVCMOSxx [get_ports ""] ;# Bank  45 VCCO - VADJ_1V8_FPGA - IO_L8P_T1L_N2_AD5P_45
##set_property PACKAGE_PIN T31      [get_ports ""] ;# Bank  45 VCCO - VADJ_1V8_FPGA - IO_L7N_T1L_N1_QBC_AD13N_45
##set_property IOSTANDARD  LVCMOSxx [get_ports ""] ;# Bank  45 VCCO - VADJ_1V8_FPGA - IO_L7N_T1L_N1_QBC_AD13N_45
##set_property PACKAGE_PIN T30      [get_ports ""] ;# Bank  45 VCCO - VADJ_1V8_FPGA - IO_L7P_T1L_N0_QBC_AD13P_45
##set_property IOSTANDARD  LVCMOSxx [get_ports ""] ;# Bank  45 VCCO - VADJ_1V8_FPGA - IO_L7P_T1L_N0_QBC_AD13P_45
##set_property PACKAGE_PIN V30      [get_ports ""] ;# Bank  45 VCCO - VADJ_1V8_FPGA - IO_T1U_N12_45
##set_property IOSTANDARD  LVCMOSxx [get_ports ""] ;# Bank  45 VCCO - VADJ_1V8_FPGA - IO_T1U_N12_45
##set_property PACKAGE_PIN Y33      [get_ports "VRP_45"] ;# Bank  45 VCCO - VADJ_1V8_FPGA - IO_T0U_N12_VRP_45
##set_property IOSTANDARD  LVCMOSxx [get_ports "VRP_45"] ;# Bank  45 VCCO - VADJ_1V8_FPGA - IO_T0U_N12_VRP_45
#set_property PACKAGE_PIN T35      [get_ports "FMCP_HSPC_LA24_N"] ;# Bank  45 VCCO - VADJ_1V8_FPGA - IO_L6N_T0U_N11_AD6N_45
#set_property IOSTANDARD  LVDS [get_ports "FMCP_HSPC_LA24_N"] ;# Bank  45 VCCO - VADJ_1V8_FPGA - IO_L6N_T0U_N11_AD6N_45
#set_property PACKAGE_PIN T34      [get_ports "FMCP_HSPC_LA24_P"] ;# Bank  45 VCCO - VADJ_1V8_FPGA - IO_L6P_T0U_N10_AD6P_45
#set_property IOSTANDARD  LVDS [get_ports "FMCP_HSPC_LA24_P"] ;# Bank  45 VCCO - VADJ_1V8_FPGA - IO_L6P_T0U_N10_AD6P_45
#set_property PACKAGE_PIN V34      [get_ports "FMCP_HSPC_LA27_N"] ;# Bank  45 VCCO - VADJ_1V8_FPGA - IO_L5N_T0U_N9_AD14N_45
#set_property IOSTANDARD  LVDS [get_ports "FMCP_HSPC_LA27_N"] ;# Bank  45 VCCO - VADJ_1V8_FPGA - IO_L5N_T0U_N9_AD14N_45
#set_property PACKAGE_PIN V33      [get_ports "FMCP_HSPC_LA27_P"] ;# Bank  45 VCCO - VADJ_1V8_FPGA - IO_L5P_T0U_N8_AD14P_45
#set_property IOSTANDARD  LVDS [get_ports "FMCP_HSPC_LA27_P"] ;# Bank  45 VCCO - VADJ_1V8_FPGA - IO_L5P_T0U_N8_AD14P_45
#set_property PACKAGE_PIN T36      [get_ports "FMCP_HSPC_LA29_N"] ;# Bank  45 VCCO - VADJ_1V8_FPGA - IO_L4N_T0U_N7_DBC_AD7N_45
#set_property IOSTANDARD  LVDS [get_ports "FMCP_HSPC_LA29_N"] ;# Bank  45 VCCO - VADJ_1V8_FPGA - IO_L4N_T0U_N7_DBC_AD7N_45
#set_property PACKAGE_PIN U35      [get_ports "FMCP_HSPC_LA29_P"] ;# Bank  45 VCCO - VADJ_1V8_FPGA - IO_L4P_T0U_N6_DBC_AD7P_45
#set_property IOSTANDARD  LVDS [get_ports "FMCP_HSPC_LA29_P"] ;# Bank  45 VCCO - VADJ_1V8_FPGA - IO_L4P_T0U_N6_DBC_AD7P_45
#set_property PACKAGE_PIN W34      [get_ports "FMCP_HSPC_LA25_N"] ;# Bank  45 VCCO - VADJ_1V8_FPGA - IO_L3N_T0L_N5_AD15N_45
#set_property IOSTANDARD  LVDS [get_ports "FMCP_HSPC_LA25_N"] ;# Bank  45 VCCO - VADJ_1V8_FPGA - IO_L3N_T0L_N5_AD15N_45
#set_property PACKAGE_PIN Y34      [get_ports "FMCP_HSPC_LA25_P"] ;# Bank  45 VCCO - VADJ_1V8_FPGA - IO_L3P_T0L_N4_AD15P_45
#set_property IOSTANDARD  LVDS [get_ports "FMCP_HSPC_LA25_P"] ;# Bank  45 VCCO - VADJ_1V8_FPGA - IO_L3P_T0L_N4_AD15P_45
#set_property PACKAGE_PIN U33      [get_ports "FMCP_HSPC_LA26_N"] ;# Bank  45 VCCO - VADJ_1V8_FPGA - IO_L2N_T0L_N3_45
#set_property IOSTANDARD  LVDS [get_ports "FMCP_HSPC_LA26_N"] ;# Bank  45 VCCO - VADJ_1V8_FPGA - IO_L2N_T0L_N3_45
#set_property PACKAGE_PIN V32      [get_ports "FMCP_HSPC_LA26_P"] ;# Bank  45 VCCO - VADJ_1V8_FPGA - IO_L2P_T0L_N2_45
#set_property IOSTANDARD  LVDS [get_ports "FMCP_HSPC_LA26_P"] ;# Bank  45 VCCO - VADJ_1V8_FPGA - IO_L2P_T0L_N2_45
#set_property PACKAGE_PIN W32      [get_ports "FMCP_HSPC_LA23_N"] ;# Bank  45 VCCO - VADJ_1V8_FPGA - IO_L1N_T0L_N1_DBC_45
#set_property IOSTANDARD  LVDS [get_ports "FMCP_HSPC_LA23_N"] ;# Bank  45 VCCO - VADJ_1V8_FPGA - IO_L1N_T0L_N1_DBC_45
#set_property PACKAGE_PIN Y32      [get_ports "FMCP_HSPC_LA23_P"] ;# Bank  45 VCCO - VADJ_1V8_FPGA - IO_L1P_T0L_N0_DBC_45
#set_property IOSTANDARD  LVDS [get_ports "FMCP_HSPC_LA23_P"] ;# Bank  45 VCCO - VADJ_1V8_FPGA - IO_L1P_T0L_N0_DBC_45
##Other net   PACKAGE_PIN U30      - VREF_45                   Bank  45 - VREF_45
#set_property PACKAGE_PIN AK13     [get_ports "FMC_HPC1_LA33_N"] ;# Bank  67 VCCO - VADJ_1V8_FPGA - IO_L24N_T3U_N11_67
#set_property IOSTANDARD  LVDS [get_ports "FMC_HPC1_LA33_N"] ;# Bank  67 VCCO - VADJ_1V8_FPGA - IO_L24N_T3U_N11_67
#set_property PACKAGE_PIN AK14     [get_ports "FMC_HPC1_LA33_P"] ;# Bank  67 VCCO - VADJ_1V8_FPGA - IO_L24P_T3U_N10_67
#set_property IOSTANDARD  LVDS [get_ports "FMC_HPC1_LA33_P"] ;# Bank  67 VCCO - VADJ_1V8_FPGA - IO_L24P_T3U_N10_67
#set_property PACKAGE_PIN AM12     [get_ports "FMC_HPC1_LA31_N"] ;# Bank  67 VCCO - VADJ_1V8_FPGA - IO_L23N_T3U_N9_67
#set_property IOSTANDARD  LVDS [get_ports "FMC_HPC1_LA31_N"] ;# Bank  67 VCCO - VADJ_1V8_FPGA - IO_L23N_T3U_N9_67
#set_property PACKAGE_PIN AM13     [get_ports "FMC_HPC1_LA31_P"] ;# Bank  67 VCCO - VADJ_1V8_FPGA - IO_L23P_T3U_N8_67
#set_property IOSTANDARD  LVDS [get_ports "FMC_HPC1_LA31_P"] ;# Bank  67 VCCO - VADJ_1V8_FPGA - IO_L23P_T3U_N8_67
#set_property PACKAGE_PIN AJ12     [get_ports "FMC_HPC1_LA32_N"] ;# Bank  67 VCCO - VADJ_1V8_FPGA - IO_L22N_T3U_N7_DBC_AD0N_67
#set_property IOSTANDARD  LVDS [get_ports "FMC_HPC1_LA32_N"] ;# Bank  67 VCCO - VADJ_1V8_FPGA - IO_L22N_T3U_N7_DBC_AD0N_67
#set_property PACKAGE_PIN AJ13     [get_ports "FMC_HPC1_LA32_P"] ;# Bank  67 VCCO - VADJ_1V8_FPGA - IO_L22P_T3U_N6_DBC_AD0P_67
#set_property IOSTANDARD  LVDS [get_ports "FMC_HPC1_LA32_P"] ;# Bank  67 VCCO - VADJ_1V8_FPGA - IO_L22P_T3U_N6_DBC_AD0P_67
#set_property PACKAGE_PIN AL12     [get_ports "FMC_HPC1_LA30_N"] ;# Bank  67 VCCO - VADJ_1V8_FPGA - IO_L21N_T3L_N5_AD8N_67
#set_property IOSTANDARD  LVDS [get_ports "FMC_HPC1_LA30_N"] ;# Bank  67 VCCO - VADJ_1V8_FPGA - IO_L21N_T3L_N5_AD8N_67
#set_property PACKAGE_PIN AK12     [get_ports "FMC_HPC1_LA30_P"] ;# Bank  67 VCCO - VADJ_1V8_FPGA - IO_L21P_T3L_N4_AD8P_67
#set_property IOSTANDARD  LVDS [get_ports "FMC_HPC1_LA30_P"] ;# Bank  67 VCCO - VADJ_1V8_FPGA - IO_L21P_T3L_N4_AD8P_67
#set_property PACKAGE_PIN AL15     [get_ports "FMC_HPC1_LA26_N"] ;# Bank  67 VCCO - VADJ_1V8_FPGA - IO_L20N_T3L_N3_AD1N_67
#set_property IOSTANDARD  LVDS [get_ports "FMC_HPC1_LA26_N"] ;# Bank  67 VCCO - VADJ_1V8_FPGA - IO_L20N_T3L_N3_AD1N_67
#set_property PACKAGE_PIN AK15     [get_ports "FMC_HPC1_LA26_P"] ;# Bank  67 VCCO - VADJ_1V8_FPGA - IO_L20P_T3L_N2_AD1P_67
#set_property IOSTANDARD  LVDS [get_ports "FMC_HPC1_LA26_P"] ;# Bank  67 VCCO - VADJ_1V8_FPGA - IO_L20P_T3L_N2_AD1P_67
#set_property PACKAGE_PIN AM14     [get_ports "FMC_HPC1_LA27_N"] ;# Bank  67 VCCO - VADJ_1V8_FPGA - IO_L19N_T3L_N1_DBC_AD9N_67
#set_property IOSTANDARD  LVDS [get_ports "FMC_HPC1_LA27_N"] ;# Bank  67 VCCO - VADJ_1V8_FPGA - IO_L19N_T3L_N1_DBC_AD9N_67
#set_property PACKAGE_PIN AL14     [get_ports "FMC_HPC1_LA27_P"] ;# Bank  67 VCCO - VADJ_1V8_FPGA - IO_L19P_T3L_N0_DBC_AD9P_67
#set_property IOSTANDARD  LVDS [get_ports "FMC_HPC1_LA27_P"] ;# Bank  67 VCCO - VADJ_1V8_FPGA - IO_L19P_T3L_N0_DBC_AD9P_67
##set_property PACKAGE_PIN AM16     [get_ports ""] ;# Bank  67 VCCO - VADJ_1V8_FPGA - IO_T3U_N12_67
##set_property IOSTANDARD  LVCMOSxx [get_ports ""] ;# Bank  67 VCCO - VADJ_1V8_FPGA - IO_T3U_N12_67
##set_property PACKAGE_PIN AR15     [get_ports ""] ;# Bank  67 VCCO - VADJ_1V8_FPGA - IO_T2U_N12_67
##set_property IOSTANDARD  LVCMOSxx [get_ports ""] ;# Bank  67 VCCO - VADJ_1V8_FPGA - IO_T2U_N12_67
#set_property PACKAGE_PIN AP15     [get_ports "FMC_HPC1_LA29_N"] ;# Bank  67 VCCO - VADJ_1V8_FPGA - IO_L18N_T2U_N11_AD2N_67
#set_property IOSTANDARD  LVDS [get_ports "FMC_HPC1_LA29_N"] ;# Bank  67 VCCO - VADJ_1V8_FPGA - IO_L18N_T2U_N11_AD2N_67
#set_property PACKAGE_PIN AN15     [get_ports "FMC_HPC1_LA29_P"] ;# Bank  67 VCCO - VADJ_1V8_FPGA - IO_L18P_T2U_N10_AD2P_67
#set_property IOSTANDARD  LVDS [get_ports "FMC_HPC1_LA29_P"] ;# Bank  67 VCCO - VADJ_1V8_FPGA - IO_L18P_T2U_N10_AD2P_67
#set_property PACKAGE_PIN AP16     [get_ports "FMC_HPC1_LA23_N"] ;# Bank  67 VCCO - VADJ_1V8_FPGA - IO_L17N_T2U_N9_AD10N_67
#set_property IOSTANDARD  LVDS [get_ports "FMC_HPC1_LA23_N"] ;# Bank  67 VCCO - VADJ_1V8_FPGA - IO_L17N_T2U_N9_AD10N_67
#set_property PACKAGE_PIN AN16     [get_ports "FMC_HPC1_LA23_P"] ;# Bank  67 VCCO - VADJ_1V8_FPGA - IO_L17P_T2U_N8_AD10P_67
#set_property IOSTANDARD  LVDS [get_ports "FMC_HPC1_LA23_P"] ;# Bank  67 VCCO - VADJ_1V8_FPGA - IO_L17P_T2U_N8_AD10P_67
#set_property PACKAGE_PIN AR12     [get_ports "FMC_HPC1_LA18_CC_N"] ;# Bank  67 VCCO - VADJ_1V8_FPGA - IO_L16N_T2U_N7_QBC_AD3N_67
#set_property IOSTANDARD  LVDS [get_ports "FMC_HPC1_LA18_CC_N"] ;# Bank  67 VCCO - VADJ_1V8_FPGA - IO_L16N_T2U_N7_QBC_AD3N_67
#set_property PACKAGE_PIN AP12     [get_ports "FMC_HPC1_LA18_CC_P"] ;# Bank  67 VCCO - VADJ_1V8_FPGA - IO_L16P_T2U_N6_QBC_AD3P_67
#set_property IOSTANDARD  LVDS [get_ports "FMC_HPC1_LA18_CC_P"] ;# Bank  67 VCCO - VADJ_1V8_FPGA - IO_L16P_T2U_N6_QBC_AD3P_67
##set_property PACKAGE_PIN AN13     [get_ports ""] ;# Bank  67 VCCO - VADJ_1V8_FPGA - IO_L15N_T2L_N5_AD11N_67
##set_property IOSTANDARD  LVCMOSxx [get_ports ""] ;# Bank  67 VCCO - VADJ_1V8_FPGA - IO_L15N_T2L_N5_AD11N_67
##set_property PACKAGE_PIN AN14     [get_ports ""] ;# Bank  67 VCCO - VADJ_1V8_FPGA - IO_L15P_T2L_N4_AD11P_67
##set_property IOSTANDARD  LVCMOSxx [get_ports ""] ;# Bank  67 VCCO - VADJ_1V8_FPGA - IO_L15P_T2L_N4_AD11P_67
#set_property PACKAGE_PIN AR13     [get_ports "FMC_HPC1_LA24_N"] ;# Bank  67 VCCO - VADJ_1V8_FPGA - IO_L14N_T2L_N3_GC_67
#set_property IOSTANDARD  LVDS [get_ports "FMC_HPC1_LA24_N"] ;# Bank  67 VCCO - VADJ_1V8_FPGA - IO_L14N_T2L_N3_GC_67
#set_property PACKAGE_PIN AP13     [get_ports "FMC_HPC1_LA24_P"] ;# Bank  67 VCCO - VADJ_1V8_FPGA - IO_L14P_T2L_N2_GC_67
#set_property IOSTANDARD  LVDS [get_ports "FMC_HPC1_LA24_P"] ;# Bank  67 VCCO - VADJ_1V8_FPGA - IO_L14P_T2L_N2_GC_67
#set_property PACKAGE_PIN AT14     [get_ports "FMC_HPC1_LA17_CC_N"] ;# Bank  67 VCCO - VADJ_1V8_FPGA - IO_L13N_T2L_N1_GC_QBC_67
#set_property IOSTANDARD  LVDS [get_ports "FMC_HPC1_LA17_CC_N"] ;# Bank  67 VCCO - VADJ_1V8_FPGA - IO_L13N_T2L_N1_GC_QBC_67
#set_property PACKAGE_PIN AR14     [get_ports "FMC_HPC1_LA17_CC_P"] ;# Bank  67 VCCO - VADJ_1V8_FPGA - IO_L13P_T2L_N0_GC_QBC_67
#set_property IOSTANDARD  LVDS [get_ports "FMC_HPC1_LA17_CC_P"] ;# Bank  67 VCCO - VADJ_1V8_FPGA - IO_L13P_T2L_N0_GC_QBC_67
#set_property PACKAGE_PIN AV13     [get_ports "FMC_HPC1_CLK1_M2C_N"] ;# Bank  67 VCCO - VADJ_1V8_FPGA - IO_L12N_T1U_N11_GC_67
#set_property IOSTANDARD  LVDS [get_ports "FMC_HPC1_CLK1_M2C_N"] ;# Bank  67 VCCO - VADJ_1V8_FPGA - IO_L12N_T1U_N11_GC_67
#set_property PACKAGE_PIN AV14     [get_ports "FMC_HPC1_CLK1_M2C_P"] ;# Bank  67 VCCO - VADJ_1V8_FPGA - IO_L12P_T1U_N10_GC_67
#set_property IOSTANDARD  LVDS [get_ports "FMC_HPC1_CLK1_M2C_P"] ;# Bank  67 VCCO - VADJ_1V8_FPGA - IO_L12P_T1U_N10_GC_67
##set_property PACKAGE_PIN AU13     [get_ports ""] ;# Bank  67 VCCO - VADJ_1V8_FPGA - IO_L11N_T1U_N9_GC_67
##set_property IOSTANDARD  LVCMOSxx [get_ports ""] ;# Bank  67 VCCO - VADJ_1V8_FPGA - IO_L11N_T1U_N9_GC_67
##set_property PACKAGE_PIN AU14     [get_ports ""] ;# Bank  67 VCCO - VADJ_1V8_FPGA - IO_L11P_T1U_N8_GC_67
##set_property IOSTANDARD  LVCMOSxx [get_ports ""] ;# Bank  67 VCCO - VADJ_1V8_FPGA - IO_L11P_T1U_N8_GC_67
#set_property PACKAGE_PIN AY14     [get_ports "PMOD0_0_LS"] ;# Bank  67 VCCO - VADJ_1V8_FPGA - IO_L10N_T1U_N7_QBC_AD4N_67
#set_property IOSTANDARD  LVCMOS18 [get_ports "PMOD0_0_LS"] ;# Bank  67 VCCO - VADJ_1V8_FPGA - IO_L10N_T1U_N7_QBC_AD4N_67
#set_property PACKAGE_PIN AY15     [get_ports "PMOD0_1_LS"] ;# Bank  67 VCCO - VADJ_1V8_FPGA - IO_L10P_T1U_N6_QBC_AD4P_67
#set_property IOSTANDARD  LVCMOS18 [get_ports "PMOD0_1_LS"] ;# Bank  67 VCCO - VADJ_1V8_FPGA - IO_L10P_T1U_N6_QBC_AD4P_67
#set_property PACKAGE_PIN AW15     [get_ports "PMOD0_2_LS"] ;# Bank  67 VCCO - VADJ_1V8_FPGA - IO_L9N_T1L_N5_AD12N_67
#set_property IOSTANDARD  LVCMOS18 [get_ports "PMOD0_2_LS"] ;# Bank  67 VCCO - VADJ_1V8_FPGA - IO_L9N_T1L_N5_AD12N_67
#set_property PACKAGE_PIN AV15     [get_ports "PMOD0_3_LS"] ;# Bank  67 VCCO - VADJ_1V8_FPGA - IO_L9P_T1L_N4_AD12P_67
#set_property IOSTANDARD  LVCMOS18 [get_ports "PMOD0_3_LS"] ;# Bank  67 VCCO - VADJ_1V8_FPGA - IO_L9P_T1L_N4_AD12P_67
#set_property PACKAGE_PIN AV16     [get_ports "PMOD0_4_LS"] ;# Bank  67 VCCO - VADJ_1V8_FPGA - IO_L8N_T1L_N3_AD5N_67
#set_property IOSTANDARD  LVCMOS18 [get_ports "PMOD0_4_LS"] ;# Bank  67 VCCO - VADJ_1V8_FPGA - IO_L8N_T1L_N3_AD5N_67
#set_property PACKAGE_PIN AU16     [get_ports "PMOD0_5_LS"] ;# Bank  67 VCCO - VADJ_1V8_FPGA - IO_L8P_T1L_N2_AD5P_67
#set_property IOSTANDARD  LVCMOS18 [get_ports "PMOD0_5_LS"] ;# Bank  67 VCCO - VADJ_1V8_FPGA - IO_L8P_T1L_N2_AD5P_67
#set_property PACKAGE_PIN AT15     [get_ports "PMOD0_6_LS"] ;# Bank  67 VCCO - VADJ_1V8_FPGA - IO_L7N_T1L_N1_QBC_AD13N_67
#set_property IOSTANDARD  LVCMOS18 [get_ports "PMOD0_6_LS"] ;# Bank  67 VCCO - VADJ_1V8_FPGA - IO_L7N_T1L_N1_QBC_AD13N_67
#set_property PACKAGE_PIN AT16     [get_ports "PMOD0_7_LS"] ;# Bank  67 VCCO - VADJ_1V8_FPGA - IO_L7P_T1L_N0_QBC_AD13P_67
#set_property IOSTANDARD  LVCMOS18 [get_ports "PMOD0_7_LS"] ;# Bank  67 VCCO - VADJ_1V8_FPGA - IO_L7P_T1L_N0_QBC_AD13P_67
#set_property PACKAGE_PIN AW16     [get_ports "10N8842"] ;# Bank  67 VCCO - VADJ_1V8_FPGA - IO_T1U_N12_67
#set_property IOSTANDARD  LVCMOSxx [get_ports "10N8842"] ;# Bank  67 VCCO - VADJ_1V8_FPGA - IO_T1U_N12_67
##set_property PACKAGE_PIN BA12     [get_ports "VRP_67"] ;# Bank  67 VCCO - VADJ_1V8_FPGA - IO_T0U_N12_VRP_67
##set_property IOSTANDARD  LVCMOSxx [get_ports "VRP_67"] ;# Bank  67 VCCO - VADJ_1V8_FPGA - IO_T0U_N12_VRP_67
#set_property PACKAGE_PIN AV11     [get_ports "FMC_HPC1_LA21_N"] ;# Bank  67 VCCO - VADJ_1V8_FPGA - IO_L6N_T0U_N11_AD6N_67
#set_property IOSTANDARD  LVDS [get_ports "FMC_HPC1_LA21_N"] ;# Bank  67 VCCO - VADJ_1V8_FPGA - IO_L6N_T0U_N11_AD6N_67
#set_property PACKAGE_PIN AU11     [get_ports "FMC_HPC1_LA21_P"] ;# Bank  67 VCCO - VADJ_1V8_FPGA - IO_L6P_T0U_N10_AD6P_67
#set_property IOSTANDARD  LVDS [get_ports "FMC_HPC1_LA21_P"] ;# Bank  67 VCCO - VADJ_1V8_FPGA - IO_L6P_T0U_N10_AD6P_67
#set_property PACKAGE_PIN AY13     [get_ports "FMC_HPC1_LA22_N"] ;# Bank  67 VCCO - VADJ_1V8_FPGA - IO_L5N_T0U_N9_AD14N_67
#set_property IOSTANDARD  LVDS [get_ports "FMC_HPC1_LA22_N"] ;# Bank  67 VCCO - VADJ_1V8_FPGA - IO_L5N_T0U_N9_AD14N_67
#set_property PACKAGE_PIN AW13     [get_ports "FMC_HPC1_LA22_P"] ;# Bank  67 VCCO - VADJ_1V8_FPGA - IO_L5P_T0U_N8_AD14P_67
#set_property IOSTANDARD  LVDS [get_ports "FMC_HPC1_LA22_P"] ;# Bank  67 VCCO - VADJ_1V8_FPGA - IO_L5P_T0U_N8_AD14P_67
#set_property PACKAGE_PIN AW10     [get_ports "FMC_HPC1_LA28_N"] ;# Bank  67 VCCO - VADJ_1V8_FPGA - IO_L4N_T0U_N7_DBC_AD7N_67
#set_property IOSTANDARD  LVDS [get_ports "FMC_HPC1_LA28_N"] ;# Bank  67 VCCO - VADJ_1V8_FPGA - IO_L4N_T0U_N7_DBC_AD7N_67
#set_property PACKAGE_PIN AV10     [get_ports "FMC_HPC1_LA28_P"] ;# Bank  67 VCCO - VADJ_1V8_FPGA - IO_L4P_T0U_N6_DBC_AD7P_67
#set_property IOSTANDARD  LVDS [get_ports "FMC_HPC1_LA28_P"] ;# Bank  67 VCCO - VADJ_1V8_FPGA - IO_L4P_T0U_N6_DBC_AD7P_67
#set_property PACKAGE_PIN AY10     [get_ports "FMC_HPC1_LA20_N"] ;# Bank  67 VCCO - VADJ_1V8_FPGA - IO_L3N_T0L_N5_AD15N_67
#set_property IOSTANDARD  LVDS [get_ports "FMC_HPC1_LA20_N"] ;# Bank  67 VCCO - VADJ_1V8_FPGA - IO_L3N_T0L_N5_AD15N_67
#set_property PACKAGE_PIN AW11     [get_ports "FMC_HPC1_LA20_P"] ;# Bank  67 VCCO - VADJ_1V8_FPGA - IO_L3P_T0L_N4_AD15P_67
#set_property IOSTANDARD  LVDS [get_ports "FMC_HPC1_LA20_P"] ;# Bank  67 VCCO - VADJ_1V8_FPGA - IO_L3P_T0L_N4_AD15P_67
#set_property PACKAGE_PIN AY12     [get_ports "FMC_HPC1_LA19_N"] ;# Bank  67 VCCO - VADJ_1V8_FPGA - IO_L2N_T0L_N3_67
#set_property IOSTANDARD  LVDS [get_ports "FMC_HPC1_LA19_N"] ;# Bank  67 VCCO - VADJ_1V8_FPGA - IO_L2N_T0L_N3_67
#set_property PACKAGE_PIN AW12     [get_ports "FMC_HPC1_LA19_P"] ;# Bank  67 VCCO - VADJ_1V8_FPGA - IO_L2P_T0L_N2_67
#set_property IOSTANDARD  LVDS [get_ports "FMC_HPC1_LA19_P"] ;# Bank  67 VCCO - VADJ_1V8_FPGA - IO_L2P_T0L_N2_67
#set_property PACKAGE_PIN AU12     [get_ports "FMC_HPC1_LA25_N"] ;# Bank  67 VCCO - VADJ_1V8_FPGA - IO_L1N_T0L_N1_DBC_67
#set_property IOSTANDARD  LVDS [get_ports "FMC_HPC1_LA25_N"] ;# Bank  67 VCCO - VADJ_1V8_FPGA - IO_L1N_T0L_N1_DBC_67
#set_property PACKAGE_PIN AT12     [get_ports "FMC_HPC1_LA25_P"] ;# Bank  67 VCCO - VADJ_1V8_FPGA - IO_L1P_T0L_N0_DBC_67
#set_property IOSTANDARD  LVDS [get_ports "FMC_HPC1_LA25_P"] ;# Bank  67 VCCO - VADJ_1V8_FPGA - IO_L1P_T0L_N0_DBC_67
##Other net   PACKAGE_PIN AL16     - VREF_67                   Bank  67 - VREF_67
#set_property PACKAGE_PIN BB12     [get_ports "FMC_HPC1_LA10_N"] ;# Bank  66 VCCO - VADJ_1V8_FPGA - IO_L24N_T3U_N11_66
#set_property IOSTANDARD  LVDS [get_ports "FMC_HPC1_LA10_N"] ;# Bank  66 VCCO - VADJ_1V8_FPGA - IO_L24N_T3U_N11_66
#set_property PACKAGE_PIN BB13     [get_ports "FMC_HPC1_LA10_P"] ;# Bank  66 VCCO - VADJ_1V8_FPGA - IO_L24P_T3U_N10_66
#set_property IOSTANDARD  LVDS [get_ports "FMC_HPC1_LA10_P"] ;# Bank  66 VCCO - VADJ_1V8_FPGA - IO_L24P_T3U_N10_66
#set_property PACKAGE_PIN BB14     [get_ports "FMC_HPC1_LA09_N"] ;# Bank  66 VCCO - VADJ_1V8_FPGA - IO_L23N_T3U_N9_66
#set_property IOSTANDARD  LVDS [get_ports "FMC_HPC1_LA09_N"] ;# Bank  66 VCCO - VADJ_1V8_FPGA - IO_L23N_T3U_N9_66
#set_property PACKAGE_PIN BA14     [get_ports "FMC_HPC1_LA09_P"] ;# Bank  66 VCCO - VADJ_1V8_FPGA - IO_L23P_T3U_N8_66
#set_property IOSTANDARD  LVDS [get_ports "FMC_HPC1_LA09_P"] ;# Bank  66 VCCO - VADJ_1V8_FPGA - IO_L23P_T3U_N8_66
#set_property PACKAGE_PIN BA15     [get_ports "FMC_HPC1_LA11_N"] ;# Bank  66 VCCO - VADJ_1V8_FPGA - IO_L22N_T3U_N7_DBC_AD0N_66
#set_property IOSTANDARD  LVDS [get_ports "FMC_HPC1_LA11_N"] ;# Bank  66 VCCO - VADJ_1V8_FPGA - IO_L22N_T3U_N7_DBC_AD0N_66
#set_property PACKAGE_PIN BA16     [get_ports "FMC_HPC1_LA11_P"] ;# Bank  66 VCCO - VADJ_1V8_FPGA - IO_L22P_T3U_N6_DBC_AD0P_66
#set_property IOSTANDARD  LVDS [get_ports "FMC_HPC1_LA11_P"] ;# Bank  66 VCCO - VADJ_1V8_FPGA - IO_L22P_T3U_N6_DBC_AD0P_66
#set_property PACKAGE_PIN BD15     [get_ports "FMC_HPC1_LA07_N"] ;# Bank  66 VCCO - VADJ_1V8_FPGA - IO_L21N_T3L_N5_AD8N_66
#set_property IOSTANDARD  LVDS [get_ports "FMC_HPC1_LA07_N"] ;# Bank  66 VCCO - VADJ_1V8_FPGA - IO_L21N_T3L_N5_AD8N_66
#set_property PACKAGE_PIN BC15     [get_ports "FMC_HPC1_LA07_P"] ;# Bank  66 VCCO - VADJ_1V8_FPGA - IO_L21P_T3L_N4_AD8P_66
#set_property IOSTANDARD  LVDS [get_ports "FMC_HPC1_LA07_P"] ;# Bank  66 VCCO - VADJ_1V8_FPGA - IO_L21P_T3L_N4_AD8P_66
#set_property PACKAGE_PIN BC16     [get_ports "FMC_HPC1_LA15_N"] ;# Bank  66 VCCO - VADJ_1V8_FPGA - IO_L20N_T3L_N3_AD1N_66
#set_property IOSTANDARD  LVDS [get_ports "FMC_HPC1_LA15_N"] ;# Bank  66 VCCO - VADJ_1V8_FPGA - IO_L20N_T3L_N3_AD1N_66
#set_property PACKAGE_PIN BB16     [get_ports "FMC_HPC1_LA15_P"] ;# Bank  66 VCCO - VADJ_1V8_FPGA - IO_L20P_T3L_N2_AD1P_66
#set_property IOSTANDARD  LVDS [get_ports "FMC_HPC1_LA15_P"] ;# Bank  66 VCCO - VADJ_1V8_FPGA - IO_L20P_T3L_N2_AD1P_66
#set_property PACKAGE_PIN BC13     [get_ports "FMC_HPC1_LA12_N"] ;# Bank  66 VCCO - VADJ_1V8_FPGA - IO_L19N_T3L_N1_DBC_AD9N_66
#set_property IOSTANDARD  LVDS [get_ports "FMC_HPC1_LA12_N"] ;# Bank  66 VCCO - VADJ_1V8_FPGA - IO_L19N_T3L_N1_DBC_AD9N_66
#set_property PACKAGE_PIN BC14     [get_ports "FMC_HPC1_LA12_P"] ;# Bank  66 VCCO - VADJ_1V8_FPGA - IO_L19P_T3L_N0_DBC_AD9P_66
#set_property IOSTANDARD  LVDS [get_ports "FMC_HPC1_LA12_P"] ;# Bank  66 VCCO - VADJ_1V8_FPGA - IO_L19P_T3L_N0_DBC_AD9P_66
#set_property PACKAGE_PIN BB11     [get_ports "10N8224"] ;# Bank  66 VCCO - VADJ_1V8_FPGA - IO_T3U_N12_66
#set_property IOSTANDARD  LVCMOSxx [get_ports "10N8224"] ;# Bank  66 VCCO - VADJ_1V8_FPGA - IO_T3U_N12_66
#set_property PACKAGE_PIN BA10     [get_ports "10N9644"] ;# Bank  66 VCCO - VADJ_1V8_FPGA - IO_T2U_N12_66
#set_property IOSTANDARD  LVCMOSxx [get_ports "10N9644"] ;# Bank  66 VCCO - VADJ_1V8_FPGA - IO_T2U_N12_66
#set_property PACKAGE_PIN AW7      [get_ports "FMC_HPC1_LA14_N"] ;# Bank  66 VCCO - VADJ_1V8_FPGA - IO_L18N_T2U_N11_AD2N_66
#set_property IOSTANDARD  LVDS [get_ports "FMC_HPC1_LA14_N"] ;# Bank  66 VCCO - VADJ_1V8_FPGA - IO_L18N_T2U_N11_AD2N_66
#set_property PACKAGE_PIN AW8      [get_ports "FMC_HPC1_LA14_P"] ;# Bank  66 VCCO - VADJ_1V8_FPGA - IO_L18P_T2U_N10_AD2P_66
#set_property IOSTANDARD  LVDS [get_ports "FMC_HPC1_LA14_P"] ;# Bank  66 VCCO - VADJ_1V8_FPGA - IO_L18P_T2U_N10_AD2P_66
#set_property PACKAGE_PIN AY7      [get_ports "FMC_HPC1_LA13_N"] ;# Bank  66 VCCO - VADJ_1V8_FPGA - IO_L17N_T2U_N9_AD10N_66
#set_property IOSTANDARD  LVDS [get_ports "FMC_HPC1_LA13_N"] ;# Bank  66 VCCO - VADJ_1V8_FPGA - IO_L17N_T2U_N9_AD10N_66
#set_property PACKAGE_PIN AY8      [get_ports "FMC_HPC1_LA13_P"] ;# Bank  66 VCCO - VADJ_1V8_FPGA - IO_L17P_T2U_N8_AD10P_66
#set_property IOSTANDARD  LVDS [get_ports "FMC_HPC1_LA13_P"] ;# Bank  66 VCCO - VADJ_1V8_FPGA - IO_L17P_T2U_N8_AD10P_66
#set_property PACKAGE_PIN AV8      [get_ports "FMC_HPC1_LA16_N"] ;# Bank  66 VCCO - VADJ_1V8_FPGA - IO_L16N_T2U_N7_QBC_AD3N_66
#set_property IOSTANDARD  LVDS [get_ports "FMC_HPC1_LA16_N"] ;# Bank  66 VCCO - VADJ_1V8_FPGA - IO_L16N_T2U_N7_QBC_AD3N_66
#set_property PACKAGE_PIN AV9      [get_ports "FMC_HPC1_LA16_P"] ;# Bank  66 VCCO - VADJ_1V8_FPGA - IO_L16P_T2U_N6_QBC_AD3P_66
#set_property IOSTANDARD  LVDS [get_ports "FMC_HPC1_LA16_P"] ;# Bank  66 VCCO - VADJ_1V8_FPGA - IO_L16P_T2U_N6_QBC_AD3P_66
#set_property PACKAGE_PIN BB7      [get_ports "FMC_HPC1_PRSNT_M2C_B_LS"] ;# Bank  66 VCCO - VADJ_1V8_FPGA - IO_L15N_T2L_N5_AD11N_66
#set_property IOSTANDARD  LVCMOS18 [get_ports "FMC_HPC1_PRSNT_M2C_B_LS"] ;# Bank  66 VCCO - VADJ_1V8_FPGA - IO_L15N_T2L_N5_AD11N_66
#set_property PACKAGE_PIN BA7      [get_ports "FMC_HPC1_PG_M2C_LS"] ;# Bank  66 VCCO - VADJ_1V8_FPGA - IO_L15P_T2L_N4_AD11P_66
#set_property IOSTANDARD  LVCMOS18 [get_ports "FMC_HPC1_PG_M2C_LS"] ;# Bank  66 VCCO - VADJ_1V8_FPGA - IO_L15P_T2L_N4_AD11P_66
##set_property PACKAGE_PIN BB8      [get_ports ""] ;# Bank  66 VCCO - VADJ_1V8_FPGA - IO_L14N_T2L_N3_GC_66
##set_property IOSTANDARD  LVCMOSxx [get_ports ""] ;# Bank  66 VCCO - VADJ_1V8_FPGA - IO_L14N_T2L_N3_GC_66
##set_property PACKAGE_PIN BB9      [get_ports ""] ;# Bank  66 VCCO - VADJ_1V8_FPGA - IO_L14P_T2L_N2_GC_66
##set_property IOSTANDARD  LVCMOSxx [get_ports ""] ;# Bank  66 VCCO - VADJ_1V8_FPGA - IO_L14P_T2L_N2_GC_66
#set_property PACKAGE_PIN BA9      [get_ports "FMC_HPC1_LA00_CC_N"] ;# Bank  66 VCCO - VADJ_1V8_FPGA - IO_L13N_T2L_N1_GC_QBC_66
#set_property IOSTANDARD  LVDS [get_ports "FMC_HPC1_LA00_CC_N"] ;# Bank  66 VCCO - VADJ_1V8_FPGA - IO_L13N_T2L_N1_GC_QBC_66
#set_property PACKAGE_PIN AY9      [get_ports "FMC_HPC1_LA00_CC_P"] ;# Bank  66 VCCO - VADJ_1V8_FPGA - IO_L13P_T2L_N0_GC_QBC_66
#set_property IOSTANDARD  LVDS [get_ports "FMC_HPC1_LA00_CC_P"] ;# Bank  66 VCCO - VADJ_1V8_FPGA - IO_L13P_T2L_N0_GC_QBC_66
#set_property PACKAGE_PIN BC8      [get_ports "FMC_HPC1_CLK0_M2C_N"] ;# Bank  66 VCCO - VADJ_1V8_FPGA - IO_L12N_T1U_N11_GC_66
#set_property IOSTANDARD  LVDS [get_ports "FMC_HPC1_CLK0_M2C_N"] ;# Bank  66 VCCO - VADJ_1V8_FPGA - IO_L12N_T1U_N11_GC_66
#set_property PACKAGE_PIN BC9      [get_ports "FMC_HPC1_CLK0_M2C_P"] ;# Bank  66 VCCO - VADJ_1V8_FPGA - IO_L12P_T1U_N10_GC_66
#set_property IOSTANDARD  LVDS [get_ports "FMC_HPC1_CLK0_M2C_P"] ;# Bank  66 VCCO - VADJ_1V8_FPGA - IO_L12P_T1U_N10_GC_66
##set_property PACKAGE_PIN BD10     [get_ports ""] ;# Bank  66 VCCO - VADJ_1V8_FPGA - IO_L11N_T1U_N9_GC_66
##set_property IOSTANDARD  LVCMOSxx [get_ports ""] ;# Bank  66 VCCO - VADJ_1V8_FPGA - IO_L11N_T1U_N9_GC_66
##set_property PACKAGE_PIN BC10     [get_ports ""] ;# Bank  66 VCCO - VADJ_1V8_FPGA - IO_L11P_T1U_N8_GC_66
##set_property IOSTANDARD  LVCMOSxx [get_ports ""] ;# Bank  66 VCCO - VADJ_1V8_FPGA - IO_L11P_T1U_N8_GC_66
#set_property PACKAGE_PIN BF9      [get_ports "FMC_HPC1_LA01_CC_N"] ;# Bank  66 VCCO - VADJ_1V8_FPGA - IO_L10N_T1U_N7_QBC_AD4N_66
#set_property IOSTANDARD  LVDS [get_ports "FMC_HPC1_LA01_CC_N"] ;# Bank  66 VCCO - VADJ_1V8_FPGA - IO_L10N_T1U_N7_QBC_AD4N_66
#set_property PACKAGE_PIN BF10     [get_ports "FMC_HPC1_LA01_CC_P"] ;# Bank  66 VCCO - VADJ_1V8_FPGA - IO_L10P_T1U_N6_QBC_AD4P_66
#set_property IOSTANDARD  LVDS [get_ports "FMC_HPC1_LA01_CC_P"] ;# Bank  66 VCCO - VADJ_1V8_FPGA - IO_L10P_T1U_N6_QBC_AD4P_66
##set_property PACKAGE_PIN BE9      [get_ports ""] ;# Bank  66 VCCO - VADJ_1V8_FPGA - IO_L9N_T1L_N5_AD12N_66
##set_property IOSTANDARD  LVCMOSxx [get_ports ""] ;# Bank  66 VCCO - VADJ_1V8_FPGA - IO_L9N_T1L_N5_AD12N_66
##set_property PACKAGE_PIN BE10     [get_ports ""] ;# Bank  66 VCCO - VADJ_1V8_FPGA - IO_L9P_T1L_N4_AD12P_66
##set_property IOSTANDARD  LVCMOSxx [get_ports ""] ;# Bank  66 VCCO - VADJ_1V8_FPGA - IO_L9P_T1L_N4_AD12P_66
##set_property PACKAGE_PIN BE7      [get_ports ""] ;# Bank  66 VCCO - VADJ_1V8_FPGA - IO_L8N_T1L_N3_AD5N_66
##set_property IOSTANDARD  LVCMOSxx [get_ports ""] ;# Bank  66 VCCO - VADJ_1V8_FPGA - IO_L8N_T1L_N3_AD5N_66
##set_property PACKAGE_PIN BE8      [get_ports ""] ;# Bank  66 VCCO - VADJ_1V8_FPGA - IO_L8P_T1L_N2_AD5P_66
##set_property IOSTANDARD  LVCMOSxx [get_ports ""] ;# Bank  66 VCCO - VADJ_1V8_FPGA - IO_L8P_T1L_N2_AD5P_66
##set_property PACKAGE_PIN BD7      [get_ports ""] ;# Bank  66 VCCO - VADJ_1V8_FPGA - IO_L7N_T1L_N1_QBC_AD13N_66
##set_property IOSTANDARD  LVCMOSxx [get_ports ""] ;# Bank  66 VCCO - VADJ_1V8_FPGA - IO_L7N_T1L_N1_QBC_AD13N_66
##set_property PACKAGE_PIN BD8      [get_ports ""] ;# Bank  66 VCCO - VADJ_1V8_FPGA - IO_L7P_T1L_N0_QBC_AD13P_66
##set_property IOSTANDARD  LVCMOSxx [get_ports ""] ;# Bank  66 VCCO - VADJ_1V8_FPGA - IO_L7P_T1L_N0_QBC_AD13P_66
##set_property PACKAGE_PIN BF7      [get_ports ""] ;# Bank  66 VCCO - VADJ_1V8_FPGA - IO_T1U_N12_66
##set_property IOSTANDARD  LVCMOSxx [get_ports ""] ;# Bank  66 VCCO - VADJ_1V8_FPGA - IO_T1U_N12_66
##set_property PACKAGE_PIN BD16     [get_ports "VRP_66"] ;# Bank  66 VCCO - VADJ_1V8_FPGA - IO_T0U_N12_VRP_66
##set_property IOSTANDARD  LVCMOSxx [get_ports "VRP_66"] ;# Bank  66 VCCO - VADJ_1V8_FPGA - IO_T0U_N12_VRP_66
#set_property PACKAGE_PIN BF15     [get_ports "FMC_HPC1_LA08_N"] ;# Bank  66 VCCO - VADJ_1V8_FPGA - IO_L6N_T0U_N11_AD6N_66
#set_property IOSTANDARD  LVDS [get_ports "FMC_HPC1_LA08_N"] ;# Bank  66 VCCO - VADJ_1V8_FPGA - IO_L6N_T0U_N11_AD6N_66
#set_property PACKAGE_PIN BE15     [get_ports "FMC_HPC1_LA08_P"] ;# Bank  66 VCCO - VADJ_1V8_FPGA - IO_L6P_T0U_N10_AD6P_66
#set_property IOSTANDARD  LVDS [get_ports "FMC_HPC1_LA08_P"] ;# Bank  66 VCCO - VADJ_1V8_FPGA - IO_L6P_T0U_N10_AD6P_66
#set_property PACKAGE_PIN BF14     [get_ports "FMC_HPC1_LA05_N"] ;# Bank  66 VCCO - VADJ_1V8_FPGA - IO_L5N_T0U_N9_AD14N_66
#set_property IOSTANDARD  LVDS [get_ports "FMC_HPC1_LA05_N"] ;# Bank  66 VCCO - VADJ_1V8_FPGA - IO_L5N_T0U_N9_AD14N_66
#set_property PACKAGE_PIN BE14     [get_ports "FMC_HPC1_LA05_P"] ;# Bank  66 VCCO - VADJ_1V8_FPGA - IO_L5P_T0U_N8_AD14P_66
#set_property IOSTANDARD  LVDS [get_ports "FMC_HPC1_LA05_P"] ;# Bank  66 VCCO - VADJ_1V8_FPGA - IO_L5P_T0U_N8_AD14P_66
#set_property PACKAGE_PIN BE13     [get_ports "FMC_HPC1_LA06_N"] ;# Bank  66 VCCO - VADJ_1V8_FPGA - IO_L4N_T0U_N7_DBC_AD7N_66
#set_property IOSTANDARD  LVDS [get_ports "FMC_HPC1_LA06_N"] ;# Bank  66 VCCO - VADJ_1V8_FPGA - IO_L4N_T0U_N7_DBC_AD7N_66
#set_property PACKAGE_PIN BD13     [get_ports "FMC_HPC1_LA06_P"] ;# Bank  66 VCCO - VADJ_1V8_FPGA - IO_L4P_T0U_N6_DBC_AD7P_66
#set_property IOSTANDARD  LVDS [get_ports "FMC_HPC1_LA06_P"] ;# Bank  66 VCCO - VADJ_1V8_FPGA - IO_L4P_T0U_N6_DBC_AD7P_66
#set_property PACKAGE_PIN BD11     [get_ports "FMC_HPC1_LA02_N"] ;# Bank  66 VCCO - VADJ_1V8_FPGA - IO_L3N_T0L_N5_AD15N_66
#set_property IOSTANDARD  LVDS [get_ports "FMC_HPC1_LA02_N"] ;# Bank  66 VCCO - VADJ_1V8_FPGA - IO_L3N_T0L_N5_AD15N_66
#set_property PACKAGE_PIN BC11     [get_ports "FMC_HPC1_LA02_P"] ;# Bank  66 VCCO - VADJ_1V8_FPGA - IO_L3P_T0L_N4_AD15P_66
#set_property IOSTANDARD  LVDS [get_ports "FMC_HPC1_LA02_P"] ;# Bank  66 VCCO - VADJ_1V8_FPGA - IO_L3P_T0L_N4_AD15P_66
#set_property PACKAGE_PIN BF11     [get_ports "FMC_HPC1_LA04_N"] ;# Bank  66 VCCO - VADJ_1V8_FPGA - IO_L2N_T0L_N3_66
#set_property IOSTANDARD  LVDS [get_ports "FMC_HPC1_LA04_N"] ;# Bank  66 VCCO - VADJ_1V8_FPGA - IO_L2N_T0L_N3_66
#set_property PACKAGE_PIN BF12     [get_ports "FMC_HPC1_LA04_P"] ;# Bank  66 VCCO - VADJ_1V8_FPGA - IO_L2P_T0L_N2_66
#set_property IOSTANDARD  LVDS [get_ports "FMC_HPC1_LA04_P"] ;# Bank  66 VCCO - VADJ_1V8_FPGA - IO_L2P_T0L_N2_66
#set_property PACKAGE_PIN BE12     [get_ports "FMC_HPC1_LA03_N"] ;# Bank  66 VCCO - VADJ_1V8_FPGA - IO_L1N_T0L_N1_DBC_66
#set_property IOSTANDARD  LVDS [get_ports "FMC_HPC1_LA03_N"] ;# Bank  66 VCCO - VADJ_1V8_FPGA - IO_L1N_T0L_N1_DBC_66
#set_property PACKAGE_PIN BD12     [get_ports "FMC_HPC1_LA03_P"] ;# Bank  66 VCCO - VADJ_1V8_FPGA - IO_L1P_T0L_N0_DBC_66
#set_property IOSTANDARD  LVDS [get_ports "FMC_HPC1_LA03_P"] ;# Bank  66 VCCO - VADJ_1V8_FPGA - IO_L1P_T0L_N0_DBC_66
##Other net   PACKAGE_PIN BA11     - VREF_66                   Bank  66 - VREF_66
##set_property PACKAGE_PIN AL19     [get_ports ""] ;# Bank  65 VCCO - VCC1V8_FPGA - IO_L24N_T3U_N11_DOUT_CSO_B_65
##set_property IOSTANDARD  LVCMOSxx [get_ports ""] ;# Bank  65 VCCO - VCC1V8_FPGA - IO_L24N_T3U_N11_DOUT_CSO_B_65
#set_property PACKAGE_PIN AL20     [get_ports "FPGA_EMCCLK"] ;# Bank  65 VCCO - VCC1V8_FPGA - IO_L24P_T3U_N10_EMCCLK_65
#set_property IOSTANDARD  LVCMOS18 [get_ports "FPGA_EMCCLK"] ;# Bank  65 VCCO - VCC1V8_FPGA - IO_L24P_T3U_N10_EMCCLK_65
#set_property PACKAGE_PIN AP17     [get_ports "SYSMON_SDA"] ;# Bank  65 VCCO - VCC1V8_FPGA - IO_L23N_T3U_N9_PERSTN1_I2C_SDA_65
#set_property IOSTANDARD  LVCMOS18 [get_ports "SYSMON_SDA"] ;# Bank  65 VCCO - VCC1V8_FPGA - IO_L23N_T3U_N9_PERSTN1_I2C_SDA_65
#set_property PACKAGE_PIN AP18     [get_ports "SYSMON_SCL"] ;# Bank  65 VCCO - VCC1V8_FPGA - IO_L23P_T3U_N8_I2C_SCLK_65
#set_property IOSTANDARD  LVCMOS18 [get_ports "SYSMON_SCL"] ;# Bank  65 VCCO - VCC1V8_FPGA - IO_L23P_T3U_N8_I2C_SCLK_65
#set_property PACKAGE_PIN AM18     [get_ports "QSPI1_DQ1"] ;# Bank  65 VCCO - VCC1V8_FPGA - IO_L22N_T3U_N7_DBC_AD0N_D05_65
#set_property IOSTANDARD  LVCMOS18 [get_ports "QSPI1_DQ1"] ;# Bank  65 VCCO - VCC1V8_FPGA - IO_L22N_T3U_N7_DBC_AD0N_D05_65
#set_property PACKAGE_PIN AM19     [get_ports "QSPI1_DQ0"] ;# Bank  65 VCCO - VCC1V8_FPGA - IO_L22P_T3U_N6_DBC_AD0P_D04_65
#set_property IOSTANDARD  LVCMOS18 [get_ports "QSPI1_DQ0"] ;# Bank  65 VCCO - VCC1V8_FPGA - IO_L22P_T3U_N6_DBC_AD0P_D04_65
#set_property PACKAGE_PIN AP20     [get_ports "QSPI1_DQ3"] ;# Bank  65 VCCO - VCC1V8_FPGA - IO_L21N_T3L_N5_AD8N_D07_65
#set_property IOSTANDARD  LVCMOS18 [get_ports "QSPI1_DQ3"] ;# Bank  65 VCCO - VCC1V8_FPGA - IO_L21N_T3L_N5_AD8N_D07_65
#set_property PACKAGE_PIN AN20     [get_ports "QSPI1_DQ2"] ;# Bank  65 VCCO - VCC1V8_FPGA - IO_L21P_T3L_N4_AD8P_D06_65
#set_property IOSTANDARD  LVCMOS18 [get_ports "QSPI1_DQ2"] ;# Bank  65 VCCO - VCC1V8_FPGA - IO_L21P_T3L_N4_AD8P_D06_65
##set_property PACKAGE_PIN AN18     [get_ports ""] ;# Bank  65 VCCO - VCC1V8_FPGA - IO_L20N_T3L_N3_AD1N_D09_65
##set_property IOSTANDARD  LVCMOSxx [get_ports ""] ;# Bank  65 VCCO - VCC1V8_FPGA - IO_L20N_T3L_N3_AD1N_D09_65
##set_property PACKAGE_PIN AN19     [get_ports ""] ;# Bank  65 VCCO - VCC1V8_FPGA - IO_L20P_T3L_N2_AD1P_D08_65
##set_property IOSTANDARD  LVCMOSxx [get_ports ""] ;# Bank  65 VCCO - VCC1V8_FPGA - IO_L20P_T3L_N2_AD1P_D08_65
##set_property PACKAGE_PIN AR17     [get_ports ""] ;# Bank  65 VCCO - VCC1V8_FPGA - IO_L19N_T3L_N1_DBC_AD9N_D11_65
##set_property IOSTANDARD  LVCMOSxx [get_ports ""] ;# Bank  65 VCCO - VCC1V8_FPGA - IO_L19N_T3L_N1_DBC_AD9N_D11_65
##set_property PACKAGE_PIN AR18     [get_ports ""] ;# Bank  65 VCCO - VCC1V8_FPGA - IO_L19P_T3L_N0_DBC_AD9P_D10_65
##set_property IOSTANDARD  LVCMOSxx [get_ports ""] ;# Bank  65 VCCO - VCC1V8_FPGA - IO_L19P_T3L_N0_DBC_AD9P_D10_65
#set_property PACKAGE_PIN AM17     [get_ports "PCIE_PERST_LS"] ;# Bank  65 VCCO - VCC1V8_FPGA - IO_T3U_N12_PERSTN0_65
#set_property IOSTANDARD  LVCMOS18 [get_ports "PCIE_PERST_LS"] ;# Bank  65 VCCO - VCC1V8_FPGA - IO_T3U_N12_PERSTN0_65
##set_property PACKAGE_PIN AW17     [get_ports ""] ;# Bank  65 VCCO - VCC1V8_FPGA - IO_T2U_N12_CSI_ADV_B_65
##set_property IOSTANDARD  LVCMOSxx [get_ports ""] ;# Bank  65 VCCO - VCC1V8_FPGA - IO_T2U_N12_CSI_ADV_B_65
##set_property PACKAGE_PIN AT19     [get_ports ""] ;# Bank  65 VCCO - VCC1V8_FPGA - IO_L18N_T2U_N11_AD2N_D13_65
##set_property IOSTANDARD  LVCMOSxx [get_ports ""] ;# Bank  65 VCCO - VCC1V8_FPGA - IO_L18N_T2U_N11_AD2N_D13_65
##set_property PACKAGE_PIN AT20     [get_ports ""] ;# Bank  65 VCCO - VCC1V8_FPGA - IO_L18P_T2U_N10_AD2P_D12_65
##set_property IOSTANDARD  LVCMOSxx [get_ports ""] ;# Bank  65 VCCO - VCC1V8_FPGA - IO_L18P_T2U_N10_AD2P_D12_65
##set_property PACKAGE_PIN AU17     [get_ports ""] ;# Bank  65 VCCO - VCC1V8_FPGA - IO_L17N_T2U_N9_AD10N_D15_65
##set_property IOSTANDARD  LVCMOSxx [get_ports ""] ;# Bank  65 VCCO - VCC1V8_FPGA - IO_L17N_T2U_N9_AD10N_D15_65
##set_property PACKAGE_PIN AT17     [get_ports ""] ;# Bank  65 VCCO - VCC1V8_FPGA - IO_L17P_T2U_N8_AD10P_D14_65
##set_property IOSTANDARD  LVCMOSxx [get_ports ""] ;# Bank  65 VCCO - VCC1V8_FPGA - IO_L17P_T2U_N8_AD10P_D14_65
##set_property PACKAGE_PIN AR19     [get_ports ""] ;# Bank  65 VCCO - VCC1V8_FPGA - IO_L16N_T2U_N7_QBC_AD3N_A01_D17_65
##set_property IOSTANDARD  LVCMOSxx [get_ports ""] ;# Bank  65 VCCO - VCC1V8_FPGA - IO_L16N_T2U_N7_QBC_AD3N_A01_D17_65
##set_property PACKAGE_PIN AR20     [get_ports ""] ;# Bank  65 VCCO - VCC1V8_FPGA - IO_L16P_T2U_N6_QBC_AD3P_A00_D16_65
##set_property IOSTANDARD  LVCMOSxx [get_ports ""] ;# Bank  65 VCCO - VCC1V8_FPGA - IO_L16P_T2U_N6_QBC_AD3P_A00_D16_65
##set_property PACKAGE_PIN AW20     [get_ports ""] ;# Bank  65 VCCO - VCC1V8_FPGA - IO_L15N_T2L_N5_AD11N_A03_D19_65
##set_property IOSTANDARD  LVCMOSxx [get_ports ""] ;# Bank  65 VCCO - VCC1V8_FPGA - IO_L15N_T2L_N5_AD11N_A03_D19_65
##set_property PACKAGE_PIN AV20     [get_ports ""] ;# Bank  65 VCCO - VCC1V8_FPGA - IO_L15P_T2L_N4_AD11P_A02_D18_65
##set_property IOSTANDARD  LVCMOSxx [get_ports ""] ;# Bank  65 VCCO - VCC1V8_FPGA - IO_L15P_T2L_N4_AD11P_A02_D18_65
##set_property PACKAGE_PIN AU18     [get_ports ""] ;# Bank  65 VCCO - VCC1V8_FPGA - IO_L14N_T2L_N3_GC_A05_D21_65
##set_property IOSTANDARD  LVCMOSxx [get_ports ""] ;# Bank  65 VCCO - VCC1V8_FPGA - IO_L14N_T2L_N3_GC_A05_D21_65
##set_property PACKAGE_PIN AU19     [get_ports ""] ;# Bank  65 VCCO - VCC1V8_FPGA - IO_L14P_T2L_N2_GC_A04_D20_65
##set_property IOSTANDARD  LVCMOSxx [get_ports ""] ;# Bank  65 VCCO - VCC1V8_FPGA - IO_L14P_T2L_N2_GC_A04_D20_65
##set_property PACKAGE_PIN AV18     [get_ports ""] ;# Bank  65 VCCO - VCC1V8_FPGA - IO_L13N_T2L_N1_GC_QBC_A07_D23_65
##set_property IOSTANDARD  LVCMOSxx [get_ports ""] ;# Bank  65 VCCO - VCC1V8_FPGA - IO_L13N_T2L_N1_GC_QBC_A07_D23_65
##set_property PACKAGE_PIN AV19     [get_ports ""] ;# Bank  65 VCCO - VCC1V8_FPGA - IO_L13P_T2L_N0_GC_QBC_A06_D22_65
##set_property IOSTANDARD  LVCMOSxx [get_ports ""] ;# Bank  65 VCCO - VCC1V8_FPGA - IO_L13P_T2L_N0_GC_QBC_A06_D22_65
##set_property PACKAGE_PIN AY18     [get_ports ""] ;# Bank  65 VCCO - VCC1V8_FPGA - IO_L12N_T1U_N11_GC_A09_D25_65
##set_property IOSTANDARD  LVCMOSxx [get_ports ""] ;# Bank  65 VCCO - VCC1V8_FPGA - IO_L12N_T1U_N11_GC_A09_D25_65
##set_property PACKAGE_PIN AW18     [get_ports ""] ;# Bank  65 VCCO - VCC1V8_FPGA - IO_L12P_T1U_N10_GC_A08_D24_65
##set_property IOSTANDARD  LVCMOSxx [get_ports ""] ;# Bank  65 VCCO - VCC1V8_FPGA - IO_L12P_T1U_N10_GC_A08_D24_65
##set_property PACKAGE_PIN BA19     [get_ports ""] ;# Bank  65 VCCO - VCC1V8_FPGA - IO_L11N_T1U_N9_GC_A11_D27_65
##set_property IOSTANDARD  LVCMOSxx [get_ports ""] ;# Bank  65 VCCO - VCC1V8_FPGA - IO_L11N_T1U_N9_GC_A11_D27_65
##set_property PACKAGE_PIN AY19     [get_ports ""] ;# Bank  65 VCCO - VCC1V8_FPGA - IO_L11P_T1U_N8_GC_A10_D26_65
##set_property IOSTANDARD  LVCMOSxx [get_ports ""] ;# Bank  65 VCCO - VCC1V8_FPGA - IO_L11P_T1U_N8_GC_A10_D26_65
##set_property PACKAGE_PIN BB17     [get_ports ""] ;# Bank  65 VCCO - VCC1V8_FPGA - IO_L10N_T1U_N7_QBC_AD4N_A13_D29_65
##set_property IOSTANDARD  LVCMOSxx [get_ports ""] ;# Bank  65 VCCO - VCC1V8_FPGA - IO_L10N_T1U_N7_QBC_AD4N_A13_D29_65
##set_property PACKAGE_PIN BA17     [get_ports ""] ;# Bank  65 VCCO - VCC1V8_FPGA - IO_L10P_T1U_N6_QBC_AD4P_A12_D28_65
##set_property IOSTANDARD  LVCMOSxx [get_ports ""] ;# Bank  65 VCCO - VCC1V8_FPGA - IO_L10P_T1U_N6_QBC_AD4P_A12_D28_65
##set_property PACKAGE_PIN BC19     [get_ports ""] ;# Bank  65 VCCO - VCC1V8_FPGA - IO_L9N_T1L_N5_AD12N_A15_D31_65
##set_property IOSTANDARD  LVCMOSxx [get_ports ""] ;# Bank  65 VCCO - VCC1V8_FPGA - IO_L9N_T1L_N5_AD12N_A15_D31_65
##set_property PACKAGE_PIN BB19     [get_ports ""] ;# Bank  65 VCCO - VCC1V8_FPGA - IO_L9P_T1L_N4_AD12P_A14_D30_65
##set_property IOSTANDARD  LVCMOSxx [get_ports ""] ;# Bank  65 VCCO - VCC1V8_FPGA - IO_L9P_T1L_N4_AD12P_A14_D30_65
##set_property PACKAGE_PIN BC18     [get_ports ""] ;# Bank  65 VCCO - VCC1V8_FPGA - IO_L8N_T1L_N3_AD5N_A17_65
##set_property IOSTANDARD  LVCMOSxx [get_ports ""] ;# Bank  65 VCCO - VCC1V8_FPGA - IO_L8N_T1L_N3_AD5N_A17_65
##set_property PACKAGE_PIN BB18     [get_ports ""] ;# Bank  65 VCCO - VCC1V8_FPGA - IO_L8P_T1L_N2_AD5P_A16_65
##set_property IOSTANDARD  LVCMOSxx [get_ports ""] ;# Bank  65 VCCO - VCC1V8_FPGA - IO_L8P_T1L_N2_AD5P_A16_65
##set_property PACKAGE_PIN BA20     [get_ports ""] ;# Bank  65 VCCO - VCC1V8_FPGA - IO_L7N_T1L_N1_QBC_AD13N_A19_65
##set_property IOSTANDARD  LVCMOSxx [get_ports ""] ;# Bank  65 VCCO - VCC1V8_FPGA - IO_L7N_T1L_N1_QBC_AD13N_A19_65
##set_property PACKAGE_PIN AY20     [get_ports ""] ;# Bank  65 VCCO - VCC1V8_FPGA - IO_L7P_T1L_N0_QBC_AD13P_A18_65
##set_property IOSTANDARD  LVCMOSxx [get_ports ""] ;# Bank  65 VCCO - VCC1V8_FPGA - IO_L7P_T1L_N0_QBC_AD13P_A18_65
##set_property PACKAGE_PIN AY17     [get_ports ""] ;# Bank  65 VCCO - VCC1V8_FPGA - IO_T1U_N12_SMBALERT_65
##set_property IOSTANDARD  LVCMOSxx [get_ports ""] ;# Bank  65 VCCO - VCC1V8_FPGA - IO_T1U_N12_SMBALERT_65
##set_property PACKAGE_PIN BF21     [get_ports "VRP_65"] ;# Bank  65 VCCO - VCC1V8_FPGA - IO_T0U_N12_VRP_A28_65
##set_property IOSTANDARD  LVCMOSxx [get_ports "VRP_65"] ;# Bank  65 VCCO - VCC1V8_FPGA - IO_T0U_N12_VRP_A28_65
##set_property PACKAGE_PIN BD17     [get_ports ""] ;# Bank  65 VCCO - VCC1V8_FPGA - IO_L6N_T0U_N11_AD6N_A21_65
##set_property IOSTANDARD  LVCMOSxx [get_ports ""] ;# Bank  65 VCCO - VCC1V8_FPGA - IO_L6N_T0U_N11_AD6N_A21_65
##set_property PACKAGE_PIN BD18     [get_ports ""] ;# Bank  65 VCCO - VCC1V8_FPGA - IO_L6P_T0U_N10_AD6P_A20_65
##set_property IOSTANDARD  LVCMOSxx [get_ports ""] ;# Bank  65 VCCO - VCC1V8_FPGA - IO_L6P_T0U_N10_AD6P_A20_65
##set_property PACKAGE_PIN BD20     [get_ports ""] ;# Bank  65 VCCO - VCC1V8_FPGA - IO_L5N_T0U_N9_AD14N_A23_65
##set_property IOSTANDARD  LVCMOSxx [get_ports ""] ;# Bank  65 VCCO - VCC1V8_FPGA - IO_L5N_T0U_N9_AD14N_A23_65
##set_property PACKAGE_PIN BC20     [get_ports ""] ;# Bank  65 VCCO - VCC1V8_FPGA - IO_L5P_T0U_N8_AD14P_A22_65
##set_property IOSTANDARD  LVCMOSxx [get_ports ""] ;# Bank  65 VCCO - VCC1V8_FPGA - IO_L5P_T0U_N8_AD14P_A22_65
##set_property PACKAGE_PIN BE17     [get_ports ""] ;# Bank  65 VCCO - VCC1V8_FPGA - IO_L4N_T0U_N7_DBC_AD7N_A25_65
##set_property IOSTANDARD  LVCMOSxx [get_ports ""] ;# Bank  65 VCCO - VCC1V8_FPGA - IO_L4N_T0U_N7_DBC_AD7N_A25_65
##set_property PACKAGE_PIN BE18     [get_ports ""] ;# Bank  65 VCCO - VCC1V8_FPGA - IO_L4P_T0U_N6_DBC_AD7P_A24_65
##set_property IOSTANDARD  LVCMOSxx [get_ports ""] ;# Bank  65 VCCO - VCC1V8_FPGA - IO_L4P_T0U_N6_DBC_AD7P_A24_65
##set_property PACKAGE_PIN BF19     [get_ports ""] ;# Bank  65 VCCO - VCC1V8_FPGA - IO_L3N_T0L_N5_AD15N_A27_65
##set_property IOSTANDARD  LVCMOSxx [get_ports ""] ;# Bank  65 VCCO - VCC1V8_FPGA - IO_L3N_T0L_N5_AD15N_A27_65
##set_property PACKAGE_PIN BE19     [get_ports ""] ;# Bank  65 VCCO - VCC1V8_FPGA - IO_L3P_T0L_N4_AD15P_A26_65
##set_property IOSTANDARD  LVCMOSxx [get_ports ""] ;# Bank  65 VCCO - VCC1V8_FPGA - IO_L3P_T0L_N4_AD15P_A26_65
#set_property PACKAGE_PIN BF16     [get_ports "QSPI1_CS_B"] ;# Bank  65 VCCO - VCC1V8_FPGA - IO_L2N_T0L_N3_FWE_FCS2_B_65
#set_property IOSTANDARD  LVCMOS18 [get_ports "QSPI1_CS_B"] ;# Bank  65 VCCO - VCC1V8_FPGA - IO_L2N_T0L_N3_FWE_FCS2_B_65
#set_property PACKAGE_PIN BF17     [get_ports "BPI_FLASH_OE_B"] ;# Bank  65 VCCO - VCC1V8_FPGA - IO_L2P_T0L_N2_FOE_B_65
#set_property IOSTANDARD  LVCMOS18 [get_ports "BPI_FLASH_OE_B"] ;# Bank  65 VCCO - VCC1V8_FPGA - IO_L2P_T0L_N2_FOE_B_65
##set_property PACKAGE_PIN BF20     [get_ports ""] ;# Bank  65 VCCO - VCC1V8_FPGA - IO_L1N_T0L_N1_DBC_RS1_65
##set_property IOSTANDARD  LVCMOSxx [get_ports ""] ;# Bank  65 VCCO - VCC1V8_FPGA - IO_L1N_T0L_N1_DBC_RS1_65
##set_property PACKAGE_PIN BE20     [get_ports ""] ;# Bank  65 VCCO - VCC1V8_FPGA - IO_L1P_T0L_N0_DBC_RS0_65
##set_property IOSTANDARD  LVCMOSxx [get_ports ""] ;# Bank  65 VCCO - VCC1V8_FPGA - IO_L1P_T0L_N0_DBC_RS0_65
##Other net   PACKAGE_PIN AL17     - 8N8196                    Bank  65 - VREF_65
#set_property PACKAGE_PIN AM24     [get_ports "IIC_MAIN_SCL"] ;# Bank  64 VCCO - VCC1V8_FPGA - IO_L24N_T3U_N11_64
#set_property IOSTANDARD  LVCMOS18 [get_ports "IIC_MAIN_SCL"] ;# Bank  64 VCCO - VCC1V8_FPGA - IO_L24N_T3U_N11_64
#set_property PACKAGE_PIN AL24     [get_ports "IIC_MAIN_SDA"] ;# Bank  64 VCCO - VCC1V8_FPGA - IO_L24P_T3U_N10_64
#set_property IOSTANDARD  LVCMOS18 [get_ports "IIC_MAIN_SDA"] ;# Bank  64 VCCO - VCC1V8_FPGA - IO_L24P_T3U_N10_64
#set_property PACKAGE_PIN AM21     [get_ports "QSFP1_MODSELL_LS"] ;# Bank  64 VCCO - VCC1V8_FPGA - IO_L23N_T3U_N9_64
#set_property IOSTANDARD  LVCMOS18 [get_ports "QSFP1_MODSELL_LS"] ;# Bank  64 VCCO - VCC1V8_FPGA - IO_L23N_T3U_N9_64
#set_property PACKAGE_PIN AL21     [get_ports "QSFP1_MODPRSL_LS"] ;# Bank  64 VCCO - VCC1V8_FPGA - IO_L23P_T3U_N8_64
#set_property IOSTANDARD  LVCMOS18 [get_ports "QSFP1_MODPRSL_LS"] ;# Bank  64 VCCO - VCC1V8_FPGA - IO_L23P_T3U_N8_64
#set_property PACKAGE_PIN AM22     [get_ports "QSFP1_RECCLK_N"] ;# Bank  64 VCCO - VCC1V8_FPGA - IO_L22N_T3U_N7_DBC_AD0N_64
#set_property IOSTANDARD  LVDS [get_ports "QSFP1_RECCLK_N"] ;# Bank  64 VCCO - VCC1V8_FPGA - IO_L22N_T3U_N7_DBC_AD0N_64
#set_property PACKAGE_PIN AM23     [get_ports "QSFP1_RECCLK_P"] ;# Bank  64 VCCO - VCC1V8_FPGA - IO_L22P_T3U_N6_DBC_AD0P_64
#set_property IOSTANDARD  LVDS [get_ports "QSFP1_RECCLK_P"] ;# Bank  64 VCCO - VCC1V8_FPGA - IO_L22P_T3U_N6_DBC_AD0P_64
#set_property PACKAGE_PIN AP21     [get_ports "QSFP1_INTL_LS"] ;# Bank  64 VCCO - VCC1V8_FPGA - IO_L21N_T3L_N5_AD8N_64
#set_property IOSTANDARD  LVCMOS18 [get_ports "QSFP1_INTL_LS"] ;# Bank  64 VCCO - VCC1V8_FPGA - IO_L21N_T3L_N5_AD8N_64
#set_property PACKAGE_PIN AN21     [get_ports "QSFP1_LPMODE_LS"] ;# Bank  64 VCCO - VCC1V8_FPGA - IO_L21P_T3L_N4_AD8P_64
#set_property IOSTANDARD  LVCMOS18 [get_ports "QSFP1_LPMODE_LS"] ;# Bank  64 VCCO - VCC1V8_FPGA - IO_L21P_T3L_N4_AD8P_64
#set_property PACKAGE_PIN AN23     [get_ports "QSFP2_MODSELL_LS"] ;# Bank  64 VCCO - VCC1V8_FPGA - IO_L20N_T3L_N3_AD1N_64
#set_property IOSTANDARD  LVCMOS18 [get_ports "QSFP2_MODSELL_LS"] ;# Bank  64 VCCO - VCC1V8_FPGA - IO_L20N_T3L_N3_AD1N_64
#set_property PACKAGE_PIN AN24     [get_ports "QSFP2_MODPRSL_LS"] ;# Bank  64 VCCO - VCC1V8_FPGA - IO_L20P_T3L_N2_AD1P_64
#set_property IOSTANDARD  LVCMOS18 [get_ports "QSFP2_MODPRSL_LS"] ;# Bank  64 VCCO - VCC1V8_FPGA - IO_L20P_T3L_N2_AD1P_64
#set_property PACKAGE_PIN AP22     [get_ports "QSFP2_RECCLK_N"] ;# Bank  64 VCCO - VCC1V8_FPGA - IO_L19N_T3L_N1_DBC_AD9N_64
#set_property IOSTANDARD  LVDS [get_ports "QSFP2_RECCLK_N"] ;# Bank  64 VCCO - VCC1V8_FPGA - IO_L19N_T3L_N1_DBC_AD9N_64
#set_property PACKAGE_PIN AP23     [get_ports "QSFP2_RECCLK_P"] ;# Bank  64 VCCO - VCC1V8_FPGA - IO_L19P_T3L_N0_DBC_AD9P_64
#set_property IOSTANDARD  LVDS [get_ports "QSFP2_RECCLK_P"] ;# Bank  64 VCCO - VCC1V8_FPGA - IO_L19P_T3L_N0_DBC_AD9P_64
#set_property PACKAGE_PIN AL25     [get_ports "IIC_MUX_RESET_B"] ;# Bank  64 VCCO - VCC1V8_FPGA - IO_T3U_N12_64
#set_property IOSTANDARD  LVCMOS18 [get_ports "IIC_MUX_RESET_B"] ;# Bank  64 VCCO - VCC1V8_FPGA - IO_T3U_N12_64
#set_property PACKAGE_PIN AT21     [get_ports "QSFP2_INTL_LS"] ;# Bank  64 VCCO - VCC1V8_FPGA - IO_T2U_N12_64
#set_property IOSTANDARD  LVCMOS18 [get_ports "QSFP2_INTL_LS"] ;# Bank  64 VCCO - VCC1V8_FPGA - IO_T2U_N12_64
#set_property PACKAGE_PIN AT24     [get_ports "QSFP2_LPMODE_LS"] ;# Bank  64 VCCO - VCC1V8_FPGA - IO_L18N_T2U_N11_AD2N_64
#set_property IOSTANDARD  LVCMOS18 [get_ports "QSFP2_LPMODE_LS"] ;# Bank  64 VCCO - VCC1V8_FPGA - IO_L18N_T2U_N11_AD2N_64
#set_property PACKAGE_PIN AR24     [get_ports "PHY1_PDWN_B_I_INT_B_O"] ;# Bank  64 VCCO - VCC1V8_FPGA - IO_L18P_T2U_N10_AD2P_64
#set_property IOSTANDARD  LVCMOS18 [get_ports "PHY1_PDWN_B_I_INT_B_O"] ;# Bank  64 VCCO - VCC1V8_FPGA - IO_L18P_T2U_N10_AD2P_64
#set_property PACKAGE_PIN AR22     [get_ports "PHY1_GPIO_0"] ;# Bank  64 VCCO - VCC1V8_FPGA - IO_L17N_T2U_N9_AD10N_64
#set_property IOSTANDARD  LVCMOS18 [get_ports "PHY1_GPIO_0"] ;# Bank  64 VCCO - VCC1V8_FPGA - IO_L17N_T2U_N9_AD10N_64
#set_property PACKAGE_PIN AR23     [get_ports "PHY1_MDIO"] ;# Bank  64 VCCO - VCC1V8_FPGA - IO_L17P_T2U_N8_AD10P_64
#set_property IOSTANDARD  LVCMOS18 [get_ports "PHY1_MDIO"] ;# Bank  64 VCCO - VCC1V8_FPGA - IO_L17P_T2U_N8_AD10P_64
#set_property PACKAGE_PIN AV24     [get_ports "PHY1_SGMII_OUT_N"] ;# Bank  64 VCCO - VCC1V8_FPGA - IO_L16N_T2U_N7_QBC_AD3N_64
#set_property IOSTANDARD  LVDS [get_ports "PHY1_SGMII_OUT_N"] ;# Bank  64 VCCO - VCC1V8_FPGA - IO_L16N_T2U_N7_QBC_AD3N_64
#set_property PACKAGE_PIN AU24     [get_ports "PHY1_SGMII_OUT_P"] ;# Bank  64 VCCO - VCC1V8_FPGA - IO_L16P_T2U_N6_QBC_AD3P_64
#set_property IOSTANDARD  LVDS [get_ports "PHY1_SGMII_OUT_P"] ;# Bank  64 VCCO - VCC1V8_FPGA - IO_L16P_T2U_N6_QBC_AD3P_64
#set_property PACKAGE_PIN AV21     [get_ports "PHY1_SGMII_IN_N"] ;# Bank  64 VCCO - VCC1V8_FPGA - IO_L15N_T2L_N5_AD11N_64
#set_property IOSTANDARD  LVDS [get_ports "PHY1_SGMII_IN_N"] ;# Bank  64 VCCO - VCC1V8_FPGA - IO_L15N_T2L_N5_AD11N_64
#set_property PACKAGE_PIN AU21     [get_ports "PHY1_SGMII_IN_P"] ;# Bank  64 VCCO - VCC1V8_FPGA - IO_L15P_T2L_N4_AD11P_64
#set_property IOSTANDARD  LVDS [get_ports "PHY1_SGMII_IN_P"] ;# Bank  64 VCCO - VCC1V8_FPGA - IO_L15P_T2L_N4_AD11P_64
#set_property PACKAGE_PIN AV23     [get_ports "PHY1_MDC"] ;# Bank  64 VCCO - VCC1V8_FPGA - IO_L14N_T2L_N3_GC_64
#set_property IOSTANDARD  LVCMOS18 [get_ports "PHY1_MDC"] ;# Bank  64 VCCO - VCC1V8_FPGA - IO_L14N_T2L_N3_GC_64
#set_property PACKAGE_PIN AU23     [get_ports "PHY1_CLKOUT"] ;# Bank  64 VCCO - VCC1V8_FPGA - IO_L14P_T2L_N2_GC_64
#set_property IOSTANDARD  LVCMOS18 [get_ports "PHY1_CLKOUT"] ;# Bank  64 VCCO - VCC1V8_FPGA - IO_L14P_T2L_N2_GC_64
#set_property PACKAGE_PIN AU22     [get_ports "PHY1_SGMII_CLK_N"] ;# Bank  64 VCCO - VCC1V8_FPGA - IO_L13N_T2L_N1_GC_QBC_64
#set_property IOSTANDARD  LVDS [get_ports "PHY1_SGMII_CLK_N"] ;# Bank  64 VCCO - VCC1V8_FPGA - IO_L13N_T2L_N1_GC_QBC_64
#set_property PACKAGE_PIN AT22     [get_ports "PHY1_SGMII_CLK_P"] ;# Bank  64 VCCO - VCC1V8_FPGA - IO_L13P_T2L_N0_GC_QBC_64
#set_property IOSTANDARD  LVDS [get_ports "PHY1_SGMII_CLK_P"] ;# Bank  64 VCCO - VCC1V8_FPGA - IO_L13P_T2L_N0_GC_QBC_64
#set_property PACKAGE_PIN AW22     [get_ports "USER_SI570_CLOCK1_N"] ;# Bank  64 VCCO - VCC1V8_FPGA - IO_L12N_T1U_N11_GC_64
#set_property IOSTANDARD  LVDS [get_ports "USER_SI570_CLOCK1_N"] ;# Bank  64 VCCO - VCC1V8_FPGA - IO_L12N_T1U_N11_GC_64
#set_property PACKAGE_PIN AW23     [get_ports "USER_SI570_CLOCK1_P"] ;# Bank  64 VCCO - VCC1V8_FPGA - IO_L12P_T1U_N10_GC_64
#set_property IOSTANDARD  LVDS [get_ports "USER_SI570_CLOCK1_P"] ;# Bank  64 VCCO - VCC1V8_FPGA - IO_L12P_T1U_N10_GC_64
#set_property PACKAGE_PIN AY23     [get_ports "CLK_125MHZ_N"] ;# Bank  64 VCCO - VCC1V8_FPGA - IO_L11N_T1U_N9_GC_64
#set_property IOSTANDARD  LVDS [get_ports "CLK_125MHZ_N"] ;# Bank  64 VCCO - VCC1V8_FPGA - IO_L11N_T1U_N9_GC_64
#set_property PACKAGE_PIN AY24     [get_ports "CLK_125MHZ_P"] ;# Bank  64 VCCO - VCC1V8_FPGA - IO_L11P_T1U_N8_GC_64
#set_property IOSTANDARD  LVDS [get_ports "CLK_125MHZ_P"] ;# Bank  64 VCCO - VCC1V8_FPGA - IO_L11P_T1U_N8_GC_64
#set_property PACKAGE_PIN BA22     [get_ports "QSFP1_RESETL_LS"] ;# Bank  64 VCCO - VCC1V8_FPGA - IO_L10N_T1U_N7_QBC_AD4N_64
#set_property IOSTANDARD  LVCMOS18 [get_ports "QSFP1_RESETL_LS"] ;# Bank  64 VCCO - VCC1V8_FPGA - IO_L10N_T1U_N7_QBC_AD4N_64
#set_property PACKAGE_PIN AY22     [get_ports "QSFP2_RESETL_LS"] ;# Bank  64 VCCO - VCC1V8_FPGA - IO_L10P_T1U_N6_QBC_AD4P_64
#set_property IOSTANDARD  LVCMOS18 [get_ports "QSFP2_RESETL_LS"] ;# Bank  64 VCCO - VCC1V8_FPGA - IO_L10P_T1U_N6_QBC_AD4P_64
#set_property PACKAGE_PIN AY25     [get_ports "USB_UART_RTS"] ;# Bank  64 VCCO - VCC1V8_FPGA - IO_L9N_T1L_N5_AD12N_64
#set_property IOSTANDARD  LVCMOS18 [get_ports "USB_UART_RTS"] ;# Bank  64 VCCO - VCC1V8_FPGA - IO_L9N_T1L_N5_AD12N_64
set_property PACKAGE_PIN AW25 [get_ports USB_UART_TX]
set_property IOSTANDARD LVCMOS18 [get_ports USB_UART_TX]
set_property PACKAGE_PIN BB21 [get_ports USB_UART_RX]
set_property IOSTANDARD LVCMOS18 [get_ports USB_UART_RX]
#set_property PACKAGE_PIN BB22     [get_ports "USB_UART_CTS"] ;# Bank  64 VCCO - VCC1V8_FPGA - IO_L8P_T1L_N2_AD5P_64
#set_property IOSTANDARD  LVCMOS18 [get_ports "USB_UART_CTS"] ;# Bank  64 VCCO - VCC1V8_FPGA - IO_L8P_T1L_N2_AD5P_64
#set_property PACKAGE_PIN BA24     [get_ports "SYSCTLR_GPIO_7"] ;# Bank  64 VCCO - VCC1V8_FPGA - IO_L7N_T1L_N1_QBC_AD13N_64
#set_property IOSTANDARD  LVCMOS18 [get_ports "SYSCTLR_GPIO_7"] ;# Bank  64 VCCO - VCC1V8_FPGA - IO_L7N_T1L_N1_QBC_AD13N_64
#set_property PACKAGE_PIN BA25     [get_ports "SYSCTLR_GPIO_6"] ;# Bank  64 VCCO - VCC1V8_FPGA - IO_L7P_T1L_N0_QBC_AD13P_64
#set_property IOSTANDARD  LVCMOS18 [get_ports "SYSCTLR_GPIO_6"] ;# Bank  64 VCCO - VCC1V8_FPGA - IO_L7P_T1L_N0_QBC_AD13P_64
#set_property PACKAGE_PIN BA21     [get_ports "PHY1_RESET_B"] ;# Bank  64 VCCO - VCC1V8_FPGA - IO_T1U_N12_64
#set_property IOSTANDARD  LVCMOS18 [get_ports "PHY1_RESET_B"] ;# Bank  64 VCCO - VCC1V8_FPGA - IO_T1U_N12_64
##set_property PACKAGE_PIN BC24     [get_ports "PCIE_WAKE_B_LS"] ;# Bank  64 VCCO - VCC1V8_FPGA - IO_T0U_N12_VRP_64
##set_property IOSTANDARD  LVCMOS18 [get_ports "PCIE_WAKE_B_LS"] ;# Bank  64 VCCO - VCC1V8_FPGA - IO_T0U_N12_VRP_64
#set_property PACKAGE_PIN BD21     [get_ports "SYSCTLR_GPIO_5"] ;# Bank  64 VCCO - VCC1V8_FPGA - IO_L6N_T0U_N11_AD6N_64
#set_property IOSTANDARD  LVCMOS18 [get_ports "SYSCTLR_GPIO_5"] ;# Bank  64 VCCO - VCC1V8_FPGA - IO_L6N_T0U_N11_AD6N_64
#set_property PACKAGE_PIN BC21     [get_ports "SI5328_RST_LS_B"] ;# Bank  64 VCCO - VCC1V8_FPGA - IO_L6P_T0U_N10_AD6P_64
#set_property IOSTANDARD  LVCMOS18 [get_ports "SI5328_RST_LS_B"] ;# Bank  64 VCCO - VCC1V8_FPGA - IO_L6P_T0U_N10_AD6P_64
#set_property PACKAGE_PIN BB23     [get_ports "PMBUS_ALERT_FPGA"] ;# Bank  64 VCCO - VCC1V8_FPGA - IO_L5N_T0U_N9_AD14N_64
#set_property IOSTANDARD  LVCMOS18 [get_ports "PMBUS_ALERT_FPGA"] ;# Bank  64 VCCO - VCC1V8_FPGA - IO_L5N_T0U_N9_AD14N_64
# set_property PACKAGE_PIN BB24 [get_ports GPIO_SW_N]
# set_property IOSTANDARD LVCMOS18 [get_ports GPIO_SW_N]
#set_property PACKAGE_PIN BF22     [get_ports "GPIO_SW_W"] ;# Bank  64 VCCO - VCC1V8_FPGA - IO_L4N_T0U_N7_DBC_AD7N_64
#set_property IOSTANDARD  LVCMOS18 [get_ports "GPIO_SW_W"] ;# Bank  64 VCCO - VCC1V8_FPGA - IO_L4N_T0U_N7_DBC_AD7N_64
# set_property PACKAGE_PIN BE22 [get_ports GPIO_SW_S]
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
