ankoman/HTBPA/src/seqencer.sv

`timescale 1ns / 1ps
//////////////////////////////////////////////////////////////////////////////////
// Company: YNU
// Engineer: Junichi Sakamoto
// 
// Create Date: 2022/10/21 10:53:29
// Design Name: 
// Module Name: sequencer
// Project Name: 
// Target Devices: 
// Tool Versions: 
// Description: 
// 
// Dependencies: 
// 
// Revision:
// Revision 0.01 - File Created
// Additional Comments:
// 
//////////////////////////////////////////////////////////////////////////////////

import CONTROL::*;

module sequencer(
    input clk, rstn, run, swrst, invresult,
    input [3:0] n_func,
    output reg opstart, endflag, busy,
    output ctrl_sig c_sig
    );


reg [15:0] cnt;  //?v???O?????J?E???^
reg [15:0] debug_ccnt;  
reg [15:0] ocnt;  //?v???O?????J?E???^
reg [8:0] opcnt;    //何回目の関数呼び出しか
reg [8:0] opcnt_start;
reg [8:0] opcnt_end;

wire [4:0] opnum;
wire [4:0] oopnum;
reg [8:0] oopcnt;
reg [1:0] cnt_4clk;
wire cnt_en = (cnt_4clk == 2'b11);

wire [7:0] addra0_wire;
wire [7:0] addra1_wire;
wire [7:0] addrb0_wire;
wire [7:0] addrb1_wire;


wire [17:0] compress_mul_addr_wire;
wire [7:0] compress_mul_addra;
wire [7:0] compress_mul_addrb;
wire [17:0] FP12square_wire;
wire [26:0] FP12_frob_addr_wire;
wire [26:0] FP12_mul_addr_wire;
wire [26:0] FP12_comul_addr_wire;

logic [58:0] rom_out;
assign c_sig.opcode = rom_out[58:32]; //2サイクル遅れる？
//assign c_sig.opcode = (cnt_4clk == 2'b10) ? rom_out[58:32] : {rom_out[58:53], 11'b11111111111, rom_out[41:32]}; //2サイクル遅れる？

assign c_sig.waddr0 = (oopnum == 9'd10)?addra0_wire + compress_mul_addra:(oopnum == 9'd11)?addra0_wire + FP12square_wire[8:0]:(oopnum == 9'd14)?addra0_wire + FP12_comul_addr_wire[8:0]:
                (oopnum == 9'd15)?addra0_wire + FP12_mul_addr_wire[8:0]:(oopnum == 9'd17)?addra0_wire + FP12_frob_addr_wire[8:0]:addra0_wire;
assign c_sig.waddr1 = (oopnum == 9'd10)?addra1_wire + compress_mul_addra:(oopnum == 9'd11)?addra1_wire + FP12square_wire[8:0]:(oopnum == 9'd14)?addra1_wire + FP12_comul_addr_wire[8:0]:
                (oopnum == 9'd15)?addra1_wire + FP12_mul_addr_wire[8:0]:(oopnum == 9'd17)?addra1_wire + FP12_frob_addr_wire[8:0]:addra1_wire;
assign c_sig.raddr0 = (oopnum == 9'd10)?addrb0_wire + compress_mul_addrb:(oopnum == 9'd11)?addrb0_wire + FP12square_wire[17:9]: (oopnum == 9'd14)?addrb0_wire + FP12_comul_addr_wire[26:18]:
                (oopnum == 9'd15)?addrb0_wire + FP12_mul_addr_wire[26:18]:(oopnum == 9'd17)?addrb0_wire + FP12_frob_addr_wire[26:18]:addrb0_wire;
assign c_sig.raddr1 = (oopnum == 9'd11)?addrb1_wire + FP12square_wire[17:9]: (oopnum == 9'd14)?addrb1_wire + FP12_comul_addr_wire[17:9]:
                (oopnum == 9'd15)?addrb1_wire + FP12_mul_addr_wire[17:9]:(oopnum == 9'd17)?((cnt == 16'd1)?addrb1_wire:addrb1_wire + FP12_frob_addr_wire[17:9]):addrb1_wire;
assign c_sig.thread = cnt_4clk + 1; //2サイクル遅れる？

assign addra0_wire = rom_out[31:24];
assign addra1_wire = rom_out[23:16];
assign addrb0_wire = rom_out[16:8]; //////////////////////
assign addrb1_wire = rom_out[7:0];
assign compress_mul_addra = (ocnt > 16'd117)?compress_mul_addr_wire[8:0]:8'b0;
assign compress_mul_addrb = (ocnt < 16'd108)?compress_mul_addr_wire[17:9]:8'b0;



wire [11:0] rom_addr_offset = (opnum == 5'd0)? 0:(opnum == 5'd1)?16'd277:(opnum == 5'd2)? 16'd421:(opnum == 5'd3)? 16'd663:
                  (opnum == 5'd4)? 16'd989: (opnum == 5'd5)? 16'd1340: (opnum == 5'd6)? 16'd1368:
                  (opnum == 5'd7)? 16'd1396: (opnum == 5'd8)? 16'd1429: (opnum == 5'd9)? 16'd1457:
                  (opnum == 5'd10)? 16'd1467: (opnum == 5'd11)? 16'd1695: (opnum == 5'd12)? 16'd1752:
                  (opnum == 5'd13)? + 16'd1862: (opnum == 5'd14)? + 16'd1919: (opnum == 5'd15)? + 16'd2027:
                  (opnum == 5'd16)? 16'd2135: (opnum == 5'd17)? 16'd2145: 16'd2157;
wire [11:0] rom_addr = rom_addr_offset + cnt;
microcode_rom rom(clk, !endflag, rom_addr, rom_out);            

assign opnum = func_opnum(opcnt);
assign oopnum = func_opnum(oopcnt);

wire [8:0] debug = oopnum - opnum;

assign compress_mul_addr_wire = func_compress_mul_addr(oopcnt[7:6]);
assign FP12square_wire = func_FP12square(oopcnt[0]);

assign FP12_frob_addr_wire = func_FP12_frob_addr(oopcnt[1]);
assign FP12_mul_addr_wire = func_FP12_mul_addr(oopcnt[3:0]);
assign FP12_comul_addr_wire = func_FP12_comul_addr(oopcnt[1:0]);



//????J?E???^?iopcnt?j??????s??????iopnum?j???o??p???
function [4:0] func_opnum;
    input [8:0] opcnt;
    begin
    case(opcnt)
        9'd0   :func_opnum = 5'd0 ;
        9'd1   :func_opnum = 5'd1 ;
        9'd2   :func_opnum = 5'd1 ;
        9'd3   :func_opnum = 5'd1 ;
        9'd4   :func_opnum = 5'd1 ;
        9'd5   :func_opnum = 5'd2 ;
        9'd6   :func_opnum = 5'd2 ;
        9'd7   :func_opnum = 5'd1 ;
        9'd8   :func_opnum = 5'd1 ;
        9'd9   :func_opnum = 5'd1 ;
        9'd10  :func_opnum = 5'd1 ;
        9'd11  :func_opnum = 5'd1 ;
        9'd12  :func_opnum = 5'd1 ;
        9'd13  :func_opnum = 5'd1 ;
        9'd14  :func_opnum = 5'd1 ;
        9'd15  :func_opnum = 5'd1 ;
        9'd16  :func_opnum = 5'd1 ;
        9'd17  :func_opnum = 5'd1 ;
        9'd18  :func_opnum = 5'd1 ;
        9'd19  :func_opnum = 5'd1 ;
        9'd20  :func_opnum = 5'd1 ;
        9'd21  :func_opnum = 5'd1 ;
        9'd22  :func_opnum = 5'd1 ;
        9'd23  :func_opnum = 5'd1 ;
        9'd24  :func_opnum = 5'd1 ;
        9'd25  :func_opnum = 5'd1 ;
        9'd26  :func_opnum = 5'd1 ;
        9'd27  :func_opnum = 5'd1 ;
        9'd28  :func_opnum = 5'd1 ;
        9'd29  :func_opnum = 5'd1 ;
        9'd30  :func_opnum = 5'd1 ;
        9'd31  :func_opnum = 5'd1 ;
        9'd32  :func_opnum = 5'd1 ;
        9'd33  :func_opnum = 5'd1 ;
        9'd34  :func_opnum = 5'd1 ;
        9'd35  :func_opnum = 5'd1 ;
        9'd36  :func_opnum = 5'd1 ;
        9'd37  :func_opnum = 5'd1 ;
        9'd38  :func_opnum = 5'd1 ;
        9'd39  :func_opnum = 5'd1 ;
        9'd40  :func_opnum = 5'd1 ;
        9'd41  :func_opnum = 5'd1 ;
        9'd42  :func_opnum = 5'd1 ;
        9'd43  :func_opnum = 5'd1 ;
        9'd44  :func_opnum = 5'd1 ;
        9'd45  :func_opnum = 5'd1 ;
        9'd46  :func_opnum = 5'd1 ;
        9'd47  :func_opnum = 5'd1 ;
        9'd48  :func_opnum = 5'd1 ;
        9'd49  :func_opnum = 5'd1 ;
        9'd50  :func_opnum = 5'd1 ;
        9'd51  :func_opnum = 5'd1 ;
        9'd52  :func_opnum = 5'd1 ;
        9'd53  :func_opnum = 5'd1 ;
        9'd54  :func_opnum = 5'd1 ;
        9'd55  :func_opnum = 5'd1 ;
        9'd56  :func_opnum = 5'd1 ;
        9'd57  :func_opnum = 5'd1 ;
        9'd58  :func_opnum = 5'd1 ;
        9'd59  :func_opnum = 5'd1 ;
        9'd60  :func_opnum = 5'd2 ;
        9'd61  :func_opnum = 5'd1 ;
        9'd62  :func_opnum = 5'd3 ;
        9'd63  :func_opnum = 5'd4 ;
        9'd64  :func_opnum = 5'd5 ;
        9'd65  :func_opnum = 5'd6 ;
        9'd66  :func_opnum = 5'd5 ;
        9'd67  :func_opnum = 5'd6 ;
        9'd68  :func_opnum = 5'd5 ;
        9'd69  :func_opnum = 5'd6 ;
        9'd70  :func_opnum = 5'd5 ;
        9'd71  :func_opnum = 5'd6 ;
        9'd72  :func_opnum = 5'd5 ;
        9'd73  :func_opnum = 5'd6 ;
        9'd74  :func_opnum = 5'd5 ;
        9'd75  :func_opnum = 5'd6 ;
        9'd76  :func_opnum = 5'd5 ;
        9'd77  :func_opnum = 5'd6 ;
        9'd78  :func_opnum = 5'd5 ;
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
        9'd278 :func_opnum = 5'd18;
        9'd279 :func_opnum = 5'd18;
        9'd280 :func_opnum = 5'd18;
        9'd281 :func_opnum = 5'd18;
        
        9'd282 :func_opnum = 5'd19;
        9'd283 :func_opnum = 5'd20;
        default func_opnum = 5'd31;
    endcase
    end
endfunction

function [17:0] func_compress_mul_addr;
    input[1:0] opnum;
    begin
        case(opnum)
            2'b01: func_compress_mul_addr = 18'b000010000001010000;
            2'b11: func_compress_mul_addr = 18'b000110000001010000;
            2'b00: func_compress_mul_addr = 18'b001000000001000000;
        endcase
    end
endfunction


function [17:0] func_FP12square;
    input opnum;
    begin
        case(opnum)
            1'b0: func_FP12square = 18'b001010000000100000;
            1'b1: func_FP12square = 18'b000100000001010000;
        endcase
    end
endfunction

function [26:0] func_FP12_comul_addr;
    input[1:0] opnum;
    begin
        case(opnum)
            2'b00: func_FP12_comul_addr = 27'b001010000000110000001100000;
            2'b10: func_FP12_comul_addr = 27'b001100000001000000001010000;
            2'b11: func_FP12_comul_addr = 27'b001000000000010000000110000;
            2'b01: func_FP12_comul_addr = 27'b0;
        endcase
    end
endfunction

function [26:0] func_FP12_mul_addr;
    input[3:0] opnum;
    begin
        case(opnum)
            4'b0101: func_FP12_mul_addr = 27'b000010000001010000000110000;
            4'b1000: func_FP12_mul_addr = 27'b000100000001010000001000000;
            4'b1001: func_FP12_mul_addr = 27'b000110000001010000000100000;
            4'b1101: func_FP12_mul_addr = 27'b000100000001010000000010000;
            4'b1111: func_FP12_mul_addr = 27'b001000000000010000000100000;
            4'b0001: func_FP12_mul_addr = 27'b000110000000100000000010000;
            default: func_FP12_mul_addr = 27'b0;
        endcase
    end
endfunction


function [26:0] func_FP12_frob_addr;
    input opnum;
    begin
        case(opnum)
            1'b0: func_FP12_frob_addr = 27'b001000000010000000001000000;
            1'b1: func_FP12_frob_addr = 27'b000110000001111000000110000;
        endcase
    end
endfunction

reg [1:0] init_cnt;

always@ (posedge clk )begin
    if(!rstn)begin
        cnt <= 2159;
        debug_ccnt <= '0;
        cnt_4clk <= '0;
        opcnt <= 0;
        oopcnt <= 0;
        init_cnt <= 0;
        opstart <= 0;
        endflag <= 0;
        busy <= 0;
    end else if(swrst) begin

    end else if(run) begin : INIT_BRAM //init BRAM??
        cnt <= 0;
        debug_ccnt <= '0;
        cnt_4clk <= '0;
        opcnt <= 0;
        oopcnt <= 0;
        init_cnt <= 0;
        opstart <= 0;
        endflag <= 0;
        
        init_cnt <= 1;
        busy <= 1;
        

        case(n_func)
            4'd0: begin //pairing
                opcnt_start <= 0;
                opcnt_end <= 9'd283;
            end
            4'd1: begin //ML
                opcnt_start <= 0;
                opcnt_end <= 9'd10;
            end
            4'd2: begin //FE
                opcnt_start <= 9'd63;
                opcnt_end <= 9'd283;
            end
            default: begin
                opcnt_start <= 0;
                opcnt_end <= 9'h3f;
            end
        endcase
        
    end
//     else if(|init_cnt) begin


//         init_cnt <= init_cnt + 1;
//         case (init_cnt)
//             16'd3  :begin
//                 opstart <= 1;
//             end
//         endcase
//    end 
    else if(busy) begin
            debug_ccnt <= debug_ccnt + 1;
            oopcnt <= opcnt;
            ocnt <= cnt;
            //        opstartset <= 1;
    



            
            if(opcnt == opcnt_end) begin
                endflag <= 1;
                busy <= 0;
            end
            else begin
                cnt_4clk <= cnt_4clk + 1'b1;
                if (cnt_en) begin
                    cnt <= cnt + 1;
                    case(opnum)
                        6'd0 :begin
                            if(cnt == 16'd276)begin
                                opcnt <= opcnt + 1;
                                cnt <= 0;
                            end
                        end
                        6'd1 :begin
                            if(cnt == 16'd143)begin
                                opcnt <= opcnt + 1;
                                cnt <= 0;
                            end
                        end
                        6'd2 :begin
                            if(cnt == 16'd241)begin
                                opcnt <= opcnt + 1;
                                cnt <= 0;
                            end
                        end
                        6'd3 :begin
                            if(cnt == 16'd325)begin
                                opcnt <= opcnt + 1;
                                cnt <= 0;
                            end
                        end
                        6'd4 :begin
                            // if(invresult)begin
                            //     cnt <= cnt + 1;
                            // end
                            // if(16'd152 <= cnt && cnt <= 16'd178 )begin
                            //     cnt <= cnt + 1;
                            // end
                            if(cnt == 16'd350)begin
                                opcnt <= opcnt + 1;
                                cnt <= 0;
                            end
                        end
                        6'd5 :begin
                            if(cnt == 16'd27)begin
                                opcnt <= opcnt + 1;
                                cnt <= 0;
                            end
                        end
                        6'd6 :begin
                            if(cnt == 16'd27)begin
                                opcnt <= opcnt + 1;
                                cnt <= 0;
                            end
                        end
                        6'd7 :begin
                            if(cnt == 16'd32)begin
                                opcnt <= opcnt + 1;
                                cnt <= 0;
                            end
                        end
                        6'd8 :begin
                            if(cnt == 16'd27)begin
                                opcnt <= opcnt + 1;
                                cnt <= 0;
                            end
                        end
                        6'd9 :begin
                            if(cnt == 16'd9)begin
                                opcnt <= opcnt + 1;
                                cnt <= 0;
                            end
                        end
                        6'd10 :begin
                            if(cnt == 16'd227)begin
                                opcnt <= opcnt + 1;
                                cnt <= 0;
                            end
                        end
                        6'd11 :begin
                            if(cnt == 16'd56)begin
                                opcnt <= opcnt + 1;
                                cnt <= 0;
                            end
                        end
                        6'd12 :begin
                            if(cnt == 16'd109)begin
                                opcnt <= opcnt + 1;
                                cnt <= 0;
                            end
                        end
                        6'd13 :begin
                            if(cnt == 16'd56)begin
                                opcnt <= opcnt + 1;
                                cnt <= 0;
                            end
                        end
                        6'd14 :begin
                            if(cnt == 16'd107)begin
                                opcnt <= opcnt + 1;
                                cnt <= 0;
                            end
                        end
                        6'd15 :begin
                            if(cnt == 16'd107)begin
                                opcnt <= opcnt + 1;
                                cnt <= 0;
                            end
                        end
                        6'd16 :begin
                            if(cnt == 16'd9)begin
                                opcnt <= opcnt + 1;
                                cnt <= 0;
                            end
                        end
                        6'd17 :begin
                            if(cnt == 16'd11)begin
                                opcnt <= opcnt + 1;
                                cnt <= 0;
                            end
                        end
                        6'd18 :begin
                            if(cnt == 16'd1)begin
                                opcnt <= opcnt + 1;
                                cnt <= 0;
                            end
                        end
                        6'd19 :begin
                            opcnt <= opcnt + 1;
                        end
                    endcase
                end
            end
        end
    end

endmodule
