ankoman/HTBPA/(commit log)

2022-10-13 Bug fix, QPMM 1000000 tests pass on 32M_tilde inputs.
    [QPMM_d0.sv, TOP_test.sv, params.sv, test_QPMM.sv]
2022-10-16 Add test_reduction. The test doesn't pass completely in particular subtraction.
    [adders.sv, params.sv, postadder.sv, test_reduction.sv]
2022-10-28 ML simulation looks correct.
    [BN254_pairing.sv, DSP_mul.sv, QPMM_d0.sv, TOP_pairing.sv, TOP_test.sv, adders.sv, cmul.sv]
2022-11-07 A bug exitsts on thread_cnt
    [BN254_pairing.sv, new_sequencer.sv, params.sv, postadder.sv, preadder.sv, test_pairing.sv, test_sequencer.sv]
2022-11-10 It looks runnning ML correctly.
    [BN254_pairing.sv, new_sequencer.sv, params.sv, postadder.sv, preadder.sv, test_pairing.sv]
2022-11-29 power of u test pass
2022-11-29 BLS parameter circuit ML test pass
2022-12-03 Modify postadder
    [制御信号スケジューリング_okuaki_オリジナル_sakamoto.xlsx]
2022-12-11 Modify eeinv for 6 threads
2023-02-17 BN254 pairing sumulation (P, 2Q), (2P, Q) become the same results.
    [制御信号スケジューリング_okuaki_オリジナル_sakamoto.xlsx]
2023-02-17 Add Q->T code in the microcode
    [制御信号スケジューリング_okuaki_オリジナル_sakamoto.xlsx]
2023-03-27 Increasing freqency by improving pre/postadders. test failed
    [BN254_pairing.sv, TOP_pairing.sv, TOP_test.sv, adders.sv, new_sequencer.sv, postadder.sv, preadder.sv, test_pairing.sv]
2023-10-05 Bug fix form QPMM test.
    [test_QPMM.sv]
2023-10-06 Move directory
    [csig_sequence.xlsx]
